Frrrrrrrrrank/Underwater-Glider/Datasheet/Pump/驱动器资料/电机驱动器BLD-485.STEP

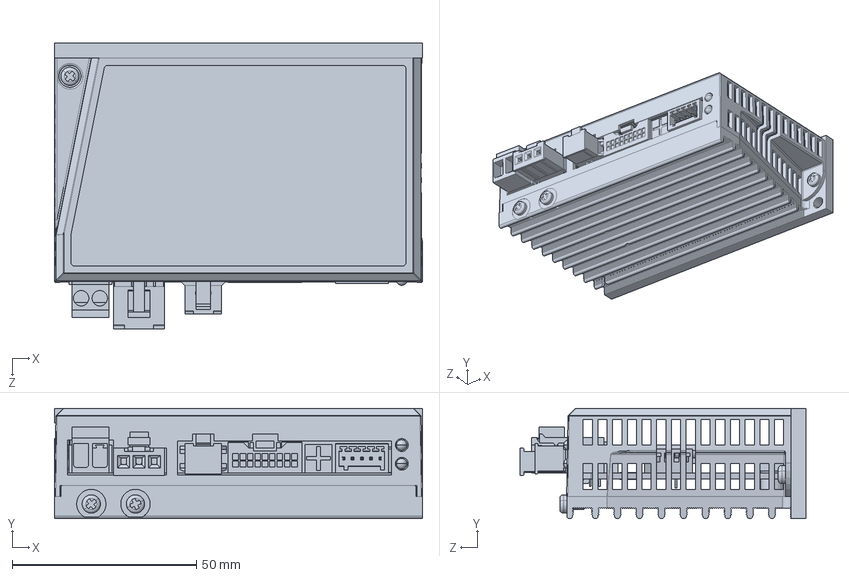
[picture p2: CAD file, 2026-04-29]
Datasheet/Pump/驱动器资料/电机驱动器BLD-485.STEP
100.0 x 30.0 x 77.6 mm
