Frrrrrrrrrank/Underwater-Glider/UnderwaterGlider/UnderwaterGlider.step

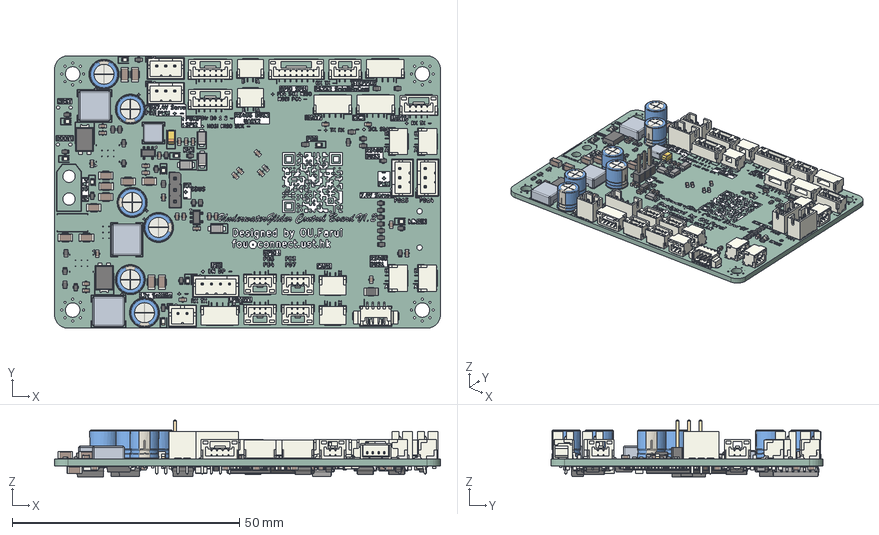
[picture p3: CAD file, 2026-06-17]
UnderwaterGlider/UnderwaterGlider.step
85.0 x 60.0 x 12.5 mm
C_0603_1608Metric x 64
JST_GH_SM04B-GHS-TB_1x04-1MP_P1.25mm_Horizontal x 4
CP_EIA-3216-18_Kemet-A
C_1206_3216Metric x 15
CP_Radial_D6.3mm_P2.50mm x 6
LED_0603_1608Metric x 10
UnderwaterGlider 1.10.1 x 3
R_0603_1608Metric x 64
JST_GH_SM02B-GHS-TB_1x02-1MP_P1.25mm_Horizontal x 8
JST_GH_BM04B-GHS-TBT_1x04-1MP_P1.25mm_Vertical
JST_GH_BM03B-GHS-TBT_1x03-1MP_P1.25mm_Vertical x 5
JST_PH_B3B-PH-K_1x03_P2.00mm_Vertical x 4
D_SMF x 5
JST_PH_B2B-PH-K_1x02_P2.00mm_Vertical
L_0603_1608Metric
PinHeader_1x03_P2.54mm_Vertical
SOT-23-5 x 2
Molex_PicoBlade_53261-0471_1x04-1MP_P1.25mm_Horizontal
JST_GH_BM05B-GHS-TBT_1x05-1MP_P1.25mm_Vertical x 2
UnderwaterGlider 1.111.1
JST_PH_B4B-PH-K_1x04_P2.00mm_Vertical
JST_GH_BM07B-GHS-TBT_1x07-1MP_P1.25mm_Vertical
Fuse_1206_3216Metric
TO-277B x 3
R_Array_Concave_4x0603 x 16
SOT-23 x 5
D_SMA x 3
D_SMC
Crystal_SMD_3225-4Pin_3.2x2.5mm
SOIC-8_3.9x4.9mm_P1.27mm x 4
TQFN-16-1EP_3x3mm_P0.5mm_EP1.6x1.6mm
SOT-363_SC-70-6
SOIC-16_4.55x10.3mm_P1.27mm
LQFP-100_14x14mm_P0.5mm
Fuse_1210_3225Metric
UnderwaterGlider_silkscreen
UnderwaterGlider_PCB
