Frrrrrrrrrank/Underwater-Glider/Datasheet/UMotor/UMLR闭环一体式系列调试软件V1.0(1)/UMLR闭环一体式系列调试软件V1.0/UMLR闭环RS485系列调试软件-V1.0/config/products/RS系列/UMLR28_object.xlsx

Index | Name | Value | Max | Min | Type | Access | Comment | Callback | Show
0x0000 | 驱动器版本 | 0 | 65535 | 0 | OB_UINT16 | RO |  | n | y
0x0001 | 驱动器标号 | 0 | 65535 | 0 | OB_UINT16 | RO |  | n | n
0x0002 | 驱动器节点号 | 0 | 65535 | 0 | OB_UINT16 | RO |  | n | n
0x0003 | 驱动器工作模式 | 0 | 65535 | 0 | OB_UINT16 | RO |  | n | n
0x0004 | 驱动器状态 | 0 | 65535 | 0 | OB_UINT16 | RO | Bit0:释放/使能 Bit1:静止/运动 Bit2-Bit3:回零状态 Bit4-Bit5:运动方向 Bit6:报警状态 | n | n
0x0005 | 当前给定理论速度 | 0 | 65535 | 0 | OB_UINT16 | RO | 单位:rev/min | n | n
0x0006 | 当前实际运行速度 | 0 | 65535 | 0 | OB_UINT16 | RO | 单位:rev/min | n | n
0x0007 | 当前错误码 | 0 | 65535 | 0 | OB_UINT16 | RO | 0:正常 其他值:错误码 | n | n
0x0008 | 当前错误子码 | 0 | 65535 | 0 | OB_UINT16 | RO | 0:正常 其他值:错误子码 | n | n
0x0009 | 输入端口状态标志位 | 0 | 65535 | 0 | OB_UINT16 | RO | 0:输入电平无效 1:输入电平有效 | n | n
0x000A | 输出端口状态标志位 | 0 | 65535 | 0 | OB_UINT16 | RO | 0:输出电平无效 1:输出电平有效 | n | n
0x000B | 当前位置低 | 0 | 65535 | 0 | OB_UINT16 | RO | 单位：Pul | n | n
0x000C | 当前位置高 | 0 | 65535 | 0 | OB_UINT16 | RO | 单位：Pul | n | n
0x000D | 当前实际电流值 | 0 | 65535 | 0 | OB_UINT16 | RO | 单位：mA | n | n
0x000E | 当前A相电流 | 0 | 65535 | 0 | OB_UINT16 | RO | 单位：mA | n | n
0x000F | 当前B相电流 | 0 | 65535 | 0 | OB_UINT16 | RO | 单位：mA | n | n
0x0010 | 闭环当前给定电流 | 0 | 65535 | 0 | OB_UINT16 | RO | 单位：rev/min | n | n
0x0011 | 拨码状态 | 0 | 65535 | 0 | OB_UINT16 | RO | 0:输入电平无效 1:输入电平有效 | n | n
0x0012 | 当前PT段路径号 | 0 | 65535 | 0 | OB_UINT16 | RO | 低8位：路径执行完成状态（保持），当前路径执行完成时，查询使用； 高8位：若处于运行中，则指示当前正在执行的路径段；若处于静止中，则指示上一次执行完成的路径段； | n | n
0x0194 | 最近一次故障码 | 0 | 65535 | 0 | OB_UINT16 | RO |  | n | y
0x0195 | 最近一次故障码子码 | 0 | 65535 | 0 | OB_UINT16 | RO |  | n | y
0x0196 | 最近二次故障码 | 0 | 65535 | 0 | OB_UINT16 | RO |  | n | n
0x0197 | 最近二次故障码子码 | 0 | 65535 | 0 | OB_UINT16 | RO |  | n | n
0x0198 | 最近三次故障码 | 0 | 65535 | 0 | OB_UINT16 | RO |  | n | n
0x0199 | 最近三次故障码子码 | 0 | 65535 | 0 | OB_UINT16 | RO |  | n | n
0x019A | 通讯类故障信息 | 0 | 65535 | 0 | OB_UINT16 | RO |  | n | n
0x019B | 通讯类故障信息 | 0 | 65535 | 0 | OB_UINT16 | RO |  | n | n
0x019C | 驱动器故障信息低16位 | 0 | 65535 | 0 | OB_UINT16 | RO |  | n | n
0x019D | 驱动器故障信息高16位 | 0 | 65535 | 0 | OB_UINT16 | RO |  | n | n
0x019E | 闭环定位精度值低16位 | 0 | 65535 | 0 | OB_UINT16 | RO | 单位：进制为10，1代表0.1个编码器值； | n | n
0x019F | 闭环定位精度值高16位 | 0 | 65535 | 0 | OB_UINT16 | RO | 以原点为分界线，正方向上差值为正值表示未到达目标位置，负值表示超过了目标位置；反方向上差值为负值表示未到达目标位置，正值表示超过了目标位置； | n | n
0x01A0 | 电机单次运行时间低16位 | 0 | 65535 | 0 | OB_UINT16 | RO | 单位：us | n | y
0x01A1 | 电机单次运行时间高16位 | 0 | 65535 | 0 | OB_UINT16 | RO | 单位：us | n | y
0x01A2 | 位置模式下实际给定的起始速度 | 0 | 65535 | 0 | OB_UINT16 | RO | 单位：rev/min | n | y
0x01A3 | 位置模式下实际给定的加速时间 | 0 | 65535 | 0 | OB_UINT16 | RO | 单位：ms | n | y
0x01A4 | 位置模式下实际给定的减速时间 | 0 | 65535 | 0 | OB_UINT16 | RO | 单位：ms | n | y
0x01A5 | 位置模式下实际给定的最大速度 | 0 | 65535 | 0 | OB_UINT16 | RO | 单位：rev/min | n | y
0x01A8 | 反馈单圈角度值 | 0 | 65535 | 0 | OB_UINT16 | RO | 单位：0.01° | n | n
0x0014 | 驱动器节点设置 | 0 | 65535 | 0 | OB_UINT16 | RW | 当设置地址拨码状态全为off时，才可自行设置驱动器节点号； | n | y
0x0015 | 自定义通讯波特率 | 0 | 6 | 0 | OB_UINT16 | RW | 0:9600 1:14400 2:19200 3:38400 4:115200 5:128000 6:256000 | n | y
0x0016 | 串口数据格式 | 0 | 3 | 0 | OB_UINT16 | RW | 0:8位数据，无校验，1停止 1:8位数据，无校验，2停止 2:8位数据，偶校验，1停止 3:8位数据，偶校验，1停止 | n | y
0x0017 | 保存参数功能 | 0 | 65535 | 0 | OB_UINT16 | RW | Bit0:同步更新功能 0:不更新 1:同步更新 Bit15:保存所有参数功能 0:不保存 1:保存所有参数 其他位功能详见说明书 | n | y
0x0018 | 超程停车方式 | 0 | 7 | 0 | OB_UINT16 | RW | 0:正负软限位生效 5:正负硬限位生效 6：软硬限位均无效 | n | y
0x0019 | 报警清除 | 0 | 1 | 0 | OB_UINT16 | RW | 0:无效 1:清除报警 | n | y
0x001A | 参数恢复出厂设置 | 0 | 1 | 0 | OB_UINT16 | RW | 0:无效 1:恢复出厂设置 | n | y
0x001B | 相位记忆使能 | 0 | 3 | 0 | OB_UINT16 | RW | Bit0：相位记忆使能功能 Bit1：掉电存储当前位置功能 0:不使能 1:使能 | n | n
0x001C | 初始旋转方向切换 | 0 | 3 | 0 | OB_UINT16 | RW | 1：出厂默认旋转方向 3：与出厂默认旋转方向相反 | n | y
0x001D | 回原点超时报警设置 | 0 | 4000 | 0 | OB_UINT16 | RW | 单位：s | n | y
0x001E | 开环电流设置 | 0 | 6000 | 0 | OB_UINT16 | RW | 单位：mA | n | n
0x001F | 开环细分设定 | 0 | 60000 | 200 | OB_UINT16 | RW | 单位：Pul/rev | n | n
0x0020 | 开环软启动时间 | 0 | 1000 | 1 | OB_UINT16 | RW | 单位：ms | n | n
0x0021 | 开环锁机电流时间 | 0 | 1000 | 1 | OB_UINT16 | RW | 单位：ms | n | n
0x0022 | 开环锁机电流比 | 0 | 100 | 0 | OB_UINT16 | RW | 单位：% | n | n
0x0023 | 开环算法选择 | 0 | 1 | 0 | OB_UINT16 | RW |  | n | n
0x0024 | 闭环运行最小有效电流值设置 | 0 | 6000 | 0 | OB_UINT16 | RW | 单位：mA | n | y
0x0025 | 闭环运行最大有效电流值设置 | 0 | 6000 | 0 | OB_UINT16 | RW | 单位：mA | n | y
0x0026 | 闭环锁机最小有效电流值设置 | 0 | 6000 | 0 | OB_UINT16 | RW | 单位：mA | n | y
0x0027 | 闭环锁机最大有效电流值设置 | 0 | 6000 | 0 | OB_UINT16 | RW | 单位：mA | n | y
0x0028 | 闭环细分设置 | 0 | 60000 | 200 | OB_UINT16 | RW | 单位：Pul/rev | n | y
0x0029 | 闭环软启动时间T1 | 0 | 65535 | 1 | OB_UINT16 | RW | 单位：ms | n | n
0x002A | 闭环软启动时间T2 | 0 | 65535 | 1 | OB_UINT16 | RW | 单位：ms | n | n
0x002B | 闭环锁机时间 | 0 | 500 | 1 | OB_UINT16 | RW | 单位：ms | n | n
0x002C | 闭环位置超差报警阈值 | 0 | 65535 | 1 | OB_UINT16 | RW | 单位：1代表0.09° 4000*0.09°=360° | n | y
0x002D | 闭环超差报警时间 | 0 | 1000 | 1 | OB_UINT16 | RW | 单位：ms | n | y
0x002E | 力矩模式选择 | 0 | 2 | 0 | OB_UINT16 | RW | 0:正常闭环模式 1:闭环力矩模式1(不会超差但可输出报警信号) 2:闭环力矩模式2(不会超差也不会输出报警信号) | n | n
0x002F | 闭环算法选择 | 0 | 31 | 0 | OB_UINT16 | RW |  | n | n
0x0030 | 起始速度 | 0 | 3000 | 1 | OB_UINT16 | RW | 单位：rev/min | n | n
0x0031 | 加速时间 | 0 | 2000 | 0 | OB_UINT16 | RW | 单位：ms | n | n
0x0032 | 减速时间 | 0 | 2000 | 0 | OB_UINT16 | RW | 单位：ms | n | n
0x0033 | 最大速度 | 0 | 65535 | 0 | OB_INT16 | RW | 单位：rev/min | n | n
0x0034 | 总脉冲数低16位 | 0 | 65535 | 0 | OB_UINT16 | RW | 单位：Pul | n | n
0x0035 | 总脉冲数高16位 | 0 | 65535 | 0 | OB_UINT16 | RW | 单位：Pul | n | n
0x0036 | 相对位置/绝对位置选择 | 0 | 1 | 0 | OB_UINT16 | RW |  | n | n
0x0037 | 启动命令 | 0 | 255 | 0 | OB_UINT16 | RW |  | n | n
0x0038 | 停止命令 | 0 | 2 | 0 | OB_UINT16 | RW |  | n | n
0x0039 | 电机使能//释放命令 | 0 | 3 | 0 | OB_UINT16 | RW | 0:不使能 1：手动控制使能 3：上电自动使能 | n | y
0x003A | 清除当前位置 | 0 | 1 | 0 | OB_UINT16 | RW | 0：无效；1：当前位置清零 | n | y
0x003B | 回原点模式 | 0 | 65535 | 0 | OB_UINT16 | RW | 回原方式详见说明书章节中回原点模式 | n | y
0x003C | 回原点速度V1 | 0 | 3000 | 1 | OB_UINT16 | RW | 单位：rev/min | n | y
0x003D | 回原点速度V2 | 0 | 3000 | 1 | OB_UINT16 | RW | 单位：rev/min | n | y
0x003E | 回原点加速时间 | 0 | 2000 | 0 | OB_UINT16 | RW | 单位：ms | n | n
0x003F | 回原点减速时间 | 0 | 2000 | 0 | OB_UINT16 | RW | 单位：ms | n | n
0x0040 | 原点低位补偿值 | 0 | 65535 | 0 | OB_UINT16 | RW | 单位：Pul | n | n
0x0041 | 原点高位补偿值 | 0 | 65535 | 0 | OB_UINT16 | RW | 单位：Pul | n | n
0x0042 | 堵转回零力矩保留时间 | 0 | 65535 | 0 | OB_UINT16 | RW | 单位:ms | n | n
0x0043 | 回零电流百分比设定 | 0 | 300 | 1 | OB_UINT16 | RW | 单位:% | n | n
0x0044 | 位置回零模式位置值设定低16位 | 0 | 65535 | 0 | OB_UINT16 | RW | 单位:pul 无符号 | n | n
0x0045 | 位置回零模式位置值设定高16位 | 0 | 65535 | 0 | OB_UINT16 | RW | 单位:pul 无符号 | n | n
0x004E | 单圈角度回零模式下，角度设定 | 0 | 36000 | 0 | OB_UINT16 | RW | 单位:0.01° | n | n
0x0046 | JOG运动起始速度设置 | 0 | 3000 | 1 | OB_UINT16 | RW | 单位rev/min | n | n
0x0047 | JOG运动加速时间设置 | 0 | 2000 | 0 | OB_UINT16 | RW | 单位:ms | n | y
0x0048 | JOG运动减速时间设置 | 0 | 2000 | 0 | OB_UINT16 | RW | 单位:ms | n | y
0x0049 | JOG运动最大速度设置 | 0 | 3000 | 0 | OB_UINT16 | RW | 单位rev/min | n | y
0x0056 | 正向超程最大位置低16位 | 0 | 65535 | 0 | OB_UINT16 | RW | 单位:pul 无符号 | n | y
0x0057 | 正向超程最大位置高16位 | 0 | 65535 | 0 | OB_UINT16 | RW | 单位:pul 无符号 | n | y
0x0058 | 反向超程最大位置低16位 | 0 | 65535 | 0 | OB_UINT16 | RW | 单位:pul 无符号 | n | y
0x0059 | 反向超程最大位置高16位 | 0 | 65535 | 0 | OB_UINT16 | RW | 单位:pul 无符号 | n | y
0x005A | 上电自动回零点使能 | 0 | 1 | 0 | OB_UINT16 | RW | 0:上电不自动回零功能 1:上电自动回零功能 | n | y
0x01B0 | 输入端口有效电平 | 0 | 65535 | 0 | OB_UINT16 | RW |  | n | y
0x01B1 | 输入端口 X0功能选择 | 0 | 21 | 0 | OB_UINT16 | RW |  | n | n
0x01B2 | 输入端口 X1功能选择 | 0 | 21 | 0 | OB_UINT16 | RW |  | n | n
0x01B3 | 输入端口 X2功能选择 | 0 | 21 | 0 | OB_UINT16 | RW |  | n | n
0x01B4 | 输入端口 X3功能选择 | 0 | 21 | 0 | OB_UINT16 | RW |  | n | n
0x01B5 | 输入端口 X4功能选择 | 0 | 21 | 0 | OB_UINT16 | RW |  | n | n
0x01B6 | 输入端口 X5功能选择 | 0 | 21 | 0 | OB_UINT16 | RW |  | n | n
0x01B7 | 输入端口 X6功能选择 | 0 | 21 | 0 | OB_UINT16 | RW |  | n | n
0x01B8 | 输入端口 X7功能选择 | 0 | 21 | 0 | OB_UINT16 | RW |  | n | n
0x01B9 | 输入端口 X8功能选择 | 0 | 21 | 0 | OB_UINT16 | RW |  | n | n
0x01BA | 输入端口 X9功能选择 | 0 | 21 | 0 | OB_UINT16 | RW |  | n | n
0x01BB | 输入端口 X10功能选择 | 0 | 21 | 0 | OB_UINT16 | RW |  | n | n
0x01BC | 输入端口 X0滤波时间 | 0 | 65535 | 0 | OB_UINT16 | RW | 单位：us 最小分辨率1000us | n | n
0x01BD | 输入端口 X1滤波时间 | 0 | 65535 | 0 | OB_UINT16 | RW | 单位：us 最小分辨率1000us | n | n
0x01BE | 输入端口 X2滤波时间 | 0 | 65535 | 0 | OB_UINT16 | RW | 单位：us 最小分辨率1000us | n | n
0x01BF | 输入端口 X3滤波时间 | 0 | 65535 | 0 | OB_UINT16 | RW | 单位：us 最小分辨率1000us | n | n
0x01C0 | 输入端口 X4滤波时间 | 0 | 65535 | 0 | OB_UINT16 | RW | 单位：us 最小分辨率1000us | n | n
0x01C1 | 输入端口 X5滤波时间 | 0 | 65535 | 0 | OB_UINT16 | RW | 单位：us 最小分辨率1000us | n | n
0x01C2 | 输入端口 X6滤波时间 | 0 | 65535 | 0 | OB_UINT16 | RW | 单位：us 最小分辨率1000us | n | n
0x01C3 | 输入端口 X7滤波时间 | 0 | 65535 | 0 | OB_UINT16 | RW | 单位：us 最小分辨率1000us | n | n
0x01C4 | 输入端口 X8滤波时间 | 0 | 65535 | 0 | OB_UINT16 | RW | 单位：us 最小分辨率1000us | n | n
0x01C5 | 输入端口 X9滤波时间 | 0 | 65535 | 0 | OB_UINT16 | RW | 单位：us 最小分辨率1000us | n | n
0x01C6 | 输入端口 X10滤波时间 | 0 | 65535 | 0 | OB_UINT16 | RW | 单位：us 最小分辨率1000us | n | n
0x01C7 | 输出端口有效状态 | 0 | 65535 | 0 | OB_UINT16 | RW |  | n | y
0x01C8 | 输出端口 Y0功能选择 | 0 | 11 | 0 | OB_UINT16 | RW |  | n | n
0x01C9 | 输出端口 Y1功能选择 | 0 | 11 | 0 | OB_UINT16 | RW |  | n | n
0x01CA | 输出端口 Y2功能选择 | 0 | 11 | 0 | OB_UINT16 | RW |  | n | n
0x01CB | 输出端口 Y3功能选择 | 0 | 11 | 0 | OB_UINT16 | RW |  | n | n
0x01CC | 输出端口 Y4功能选择 | 0 | 11 | 0 | OB_UINT16 | RW |  | n | n
0x01CD | 禁止不同模式下的到位输出功能 | 0 | 65535 | 0 | OB_UINT16 | RW | Bit0:速度模式 Bit1:相对位置 Bit2:绝对位置 Bit3:回零 Bit4:多段位置 Bit5:多段速度 Bit6:JOG+运动 Bit7:JOG-运动 0：禁止无效 1：禁止有效65535 | n | y
0x005E | 多段模式启动信号使能控制 | 0 | 1 | 0 | OB_UINT16 | RW | 0:多段模式不需要启动信号(此情况路径0失效) 1:多段模式需要启动信号(此情况路径0可启动) | n | y
0x005F | 多段模式IO组合滤波时间 | 0 | 65535 | 0 | OB_UINT16 | RW | 单位：us 最小分辨率1000us | n | n
0x0060 | 路径0功能设置1 | 0 | 65535 | 0 | OB_UINT16 | RW |  | n | n
0x0061 | 路径0功能设置2 | 0 | 65535 | 0 | OB_UINT16 | RW |  | n | n
0x0062 | 路径0位置段总脉冲数低位 | 0 | 65535 | 0 | OB_UINT16 | RW |  | n | n
0x0063 | 路径0位置段总脉冲数高位 | 0 | 65535 | 0 | OB_UINT16 | RW |  | n | n
0x0064 | 路径0运行/回原点最大速度 | 0 | 65535 | 0 | OB_UINT16 | RW | 单位：rev/min | n | n
0x0065 | 路径0运行/回原点起始速度 | 0 | 3000 | 1 | OB_UINT16 | RW | 单位：rev/min | n | n
0x0066 | 路径0运行/回原点加速时间 | 0 | 2000 | 0 | OB_UINT16 | RW | 单位：ms | n | n
0x0067 | 路径0运行/回原点减速时间 | 0 | 2000 | 0 | OB_UINT16 | RW | 单位：ms | n | n
0x0068 | 路径0执行完毕等待时长 | 0 | 65535 | 0 | OB_UINT16 | RW | 单位：ms | n | n
0x0069 | 路径0回原点低位补偿值 | 0 | 65535 | 0 | OB_UINT16 | RW | 单位：Pul | n | n
0x006A | 路径0回原点高位补偿值 | 0 | 65535 | 0 | OB_UINT16 | RW | 单位：Pul | n | n
0x006B | 路径0回原点后等待时长 | 0 | 65535 | 0 | OB_UINT16 | RW | 单位：ms | n | n
0x0070 | 路径1功能设置1 | 0 | 65535 | 0 | OB_UINT16 | RW |  | n | n
0x0071 | 路径1功能设置2 | 0 | 65535 | 0 | OB_UINT16 | RW |  | n | n
0x0072 | 路径1位置段总脉冲数低位 | 0 | 65535 | 0 | OB_UINT16 | RW |  | n | n
0x0073 | 路径1位置段总脉冲数高位 | 0 | 65535 | 0 | OB_UINT16 | RW |  | n | n
0x0074 | 路径1运行/回原点最大速度 | 0 | 65535 | 0 | OB_UINT16 | RW | 单位：rev/min | n | n
0x0075 | 路径1运行/回原点起始速度 | 0 | 3000 | 1 | OB_UINT16 | RW | 单位：rev/min | n | n
0x0076 | 路径1运行/回原点加速时间 | 0 | 2000 | 0 | OB_UINT16 | RW | 单位：ms | n | n
0x0077 | 路径1运行/回原点减速时间 | 0 | 2000 | 0 | OB_UINT16 | RW | 单位：ms | n | n
0x0078 | 路径1执行完毕等待时长 | 0 | 65535 | 0 | OB_UINT16 | RW | 单位：ms | n | n
0x0079 | 路径1回原点低位补偿值 | 0 | 65535 | 0 | OB_UINT16 | RW | 单位：Pul | n | n
0x007A | 路径1回原点高位补偿值 | 0 | 65535 | 0 | OB_UINT16 | RW | 单位：Pul | n | n
0x007B | 路径1回原点后等待时长 | 0 | 65535 | 0 | OB_UINT16 | RW | 单位：ms | n | n
0x0080 | 路径2功能设置1 | 0 | 65535 | 0 | OB_UINT16 | RW |  | n | n
0x0081 | 路径2功能设置2 | 0 | 65535 | 0 | OB_UINT16 | RW |  | n | n
0x0082 | 路径2位置段总脉冲数低位 | 0 | 65535 | 0 | OB_UINT16 | RW |  | n | n
0x0083 | 路径2位置段总脉冲数高位 | 0 | 65535 | 0 | OB_UINT16 | RW |  | n | n
0x0084 | 路径2运行/回原点最大速度 | 0 | 65535 | 0 | OB_UINT16 | RW | 单位：rev/min | n | n
0x0085 | 路径2运行/回原点起始速度 | 0 | 3000 | 1 | OB_UINT16 | RW | 单位：rev/min | n | n
0x0086 | 路径2运行/回原点加速时间 | 0 | 2000 | 0 | OB_UINT16 | RW | 单位：ms | n | n
0x0087 | 路径2运行/回原点减速时间 | 0 | 2000 | 0 | OB_UINT16 | RW | 单位：ms | n | n
0x0088 | 路径2执行完毕等待时长 | 0 | 65535 | 0 | OB_UINT16 | RW | 单位：ms | n | n
0x0089 | 路径2回原点低位补偿值 | 0 | 65535 | 0 | OB_UINT16 | RW | 单位：Pul | n | n
0x008A | 路径2回原点高位补偿值 | 0 | 65535 | 0 | OB_UINT16 | RW | 单位：Pul | n | n
0x008B | 路径2回原点后等待时长 | 0 | 65535 | 0 | OB_UINT16 | RW | 单位：ms | n | n
0x0090 | 路径3功能设置1 | 0 | 65535 | 0 | OB_UINT16 | RW |  | n | n
0x0091 | 路径3功能设置2 | 0 | 65535 | 0 | OB_UINT16 | RW |  | n | n
0x0092 | 路径3位置段总脉冲数低位 | 0 | 65535 | 0 | OB_UINT16 | RW |  | n | n
0x0093 | 路径3位置段总脉冲数高位 | 0 | 65535 | 0 | OB_UINT16 | RW |  | n | n
0x0094 | 路径3运行/回原点最大速度 | 0 | 65535 | 0 | OB_UINT16 | RW | 单位：rev/min | n | n
0x0095 | 路径3运行/回原点起始速度 | 0 | 3000 | 1 | OB_UINT16 | RW | 单位：rev/min | n | n
0x0096 | 路径3运行/回原点加速时间 | 0 | 2000 | 0 | OB_UINT16 | RW | 单位：ms | n | n
0x0097 | 路径3运行/回原点减速时间 | 0 | 2000 | 0 | OB_UINT16 | RW | 单位：ms | n | n
0x0098 | 路径3执行完毕等待时长 | 0 | 65535 | 0 | OB_UINT16 | RW | 单位：ms | n | n
0x0099 | 路径3回原点低位补偿值 | 0 | 65535 | 0 | OB_UINT16 | RW | 单位：Pul | n | n
0x009A | 路径3回原点高位补偿值 | 0 | 65535 | 0 | OB_UINT16 | RW | 单位：Pul | n | n
0x009B | 路径3回原点后等待时长 | 0 | 65535 | 0 | OB_UINT16 | RW | 单位：ms | n | n
0x00A0 | 路径4功能设置1 | 0 | 65535 | 0 | OB_UINT16 | RW |  | n | n
0x00A1 | 路径4功能设置2 | 0 | 65535 | 0 | OB_UINT16 | RW |  | n | n
0x00A2 | 路径4位置段总脉冲数低位 | 0 | 65535 | 0 | OB_UINT16 | RW |  | n | n
0x00A3 | 路径4位置段总脉冲数高位 | 0 | 65535 | 0 | OB_UINT16 | RW |  | n | n
0x00A4 | 路径4运行/回原点最大速度 | 0 | 65535 | 0 | OB_UINT16 | RW | 单位：rev/min | n | n
0x00A5 | 路径4运行/回原点起始速度 | 0 | 3000 | 1 | OB_UINT16 | RW | 单位：rev/min | n | n
0x00A6 | 路径4运行/回原点加速时间 | 0 | 2000 | 0 | OB_UINT16 | RW | 单位：ms | n | n
0x00A7 | 路径4运行/回原点减速时间 | 0 | 2000 | 0 | OB_UINT16 | RW | 单位：ms | n | n
0x00A8 | 路径4执行完毕等待时长 | 0 | 65535 | 0 | OB_UINT16 | RW | 单位：ms | n | n
0x00A9 | 路径4回原点低位补偿值 | 0 | 65535 | 0 | OB_UINT16 | RW | 单位：Pul | n | n
0x00AA | 路径4回原点高位补偿值 | 0 | 65535 | 0 | OB_UINT16 | RW | 单位：Pul | n | n
0x00AB | 路径4回原点后等待时长 | 0 | 65535 | 0 | OB_UINT16 | RW | 单位：ms | n | n
0x00B0 | 路径5功能设置1 | 0 | 65535 | 0 | OB_UINT16 | RW |  | n | n
0x00B1 | 路径5功能设置2 | 0 | 65535 | 0 | OB_UINT16 | RW |  | n | n
0x00B2 | 路径5位置段总脉冲数低位 | 0 | 65535 | 0 | OB_UINT16 | RW |  | n | n
0x00B3 | 路径5位置段总脉冲数高位 | 0 | 65535 | 0 | OB_UINT16 | RW |  | n | n
0x00B4 | 路径5运行/回原点最大速度 | 0 | 65535 | 0 | OB_UINT16 | RW | 单位：rev/min | n | n
0x00B5 | 路径5运行/回原点起始速度 | 0 | 3000 | 1 | OB_UINT16 | RW | 单位：rev/min | n | n
0x00B6 | 路径5运行/回原点加速时间 | 0 | 2000 | 0 | OB_UINT16 | RW | 单位：ms | n | n
0x00B7 | 路径5运行/回原点减速时间 | 0 | 2000 | 0 | OB_UINT16 | RW | 单位：ms | n | n
0x00B8 | 路径5执行完毕等待时长 | 0 | 65535 | 0 | OB_UINT16 | RW | 单位：ms | n | n
0x00B9 | 路径5回原点低位补偿值 | 0 | 65535 | 0 | OB_UINT16 | RW | 单位：Pul | n | n
0x00BA | 路径5回原点高位补偿值 | 0 | 65535 | 0 | OB_UINT16 | RW | 单位：Pul | n | n
0x00BB | 路径5回原点后等待时长 | 0 | 65535 | 0 | OB_UINT16 | RW | 单位：ms | n | n
0x00C0 | 路径6功能设置1 | 0 | 65535 | 0 | OB_UINT16 | RW |  | n | n
0x00C1 | 路径6功能设置2 | 0 | 65535 | 0 | OB_UINT16 | RW |  | n | n
0x00C2 | 路径6位置段总脉冲数低位 | 0 | 65535 | 0 | OB_UINT16 | RW |  | n | n
0x00C3 | 路径6位置段总脉冲数高位 | 0 | 65535 | 0 | OB_UINT16 | RW |  | n | n
0x00C4 | 路径6运行/回原点最大速度 | 0 | 65535 | 0 | OB_UINT16 | RW | 单位：rev/min | n | n
0x00C5 | 路径6运行/回原点起始速度 | 0 | 3000 | 1 | OB_UINT16 | RW | 单位：rev/min | n | n
0x00C6 | 路径6运行/回原点加速时间 | 0 | 2000 | 0 | OB_UINT16 | RW | 单位：ms | n | n
0x00C7 | 路径6运行/回原点减速时间 | 0 | 2000 | 0 | OB_UINT16 | RW | 单位：ms | n | n
0x00C8 | 路径6执行完毕等待时长 | 0 | 65535 | 0 | OB_UINT16 | RW | 单位：ms | n | n
0x00C9 | 路径6回原点低位补偿值 | 0 | 65535 | 0 | OB_UINT16 | RW | 单位：Pul | n | n
0x00CA | 路径6回原点高位补偿值 | 0 | 65535 | 0 | OB_UINT16 | RW | 单位：Pul | n | n
0x00CB | 路径6回原点后等待时长 | 0 | 65535 | 0 | OB_UINT16 | RW | 单位：ms | n | n
0x00D0 | 路径7功能设置1 | 0 | 65535 | 0 | OB_UINT16 | RW |  | n | n
0x00D1 | 路径7功能设置2 | 0 | 65535 | 0 | OB_UINT16 | RW |  | n | n
0x00D2 | 路径7位置段总脉冲数低位 | 0 | 65535 | 0 | OB_UINT16 | RW |  | n | n
0x00D3 | 路径7位置段总脉冲数高位 | 0 | 65535 | 0 | OB_UINT16 | RW |  | n | n
0x00D4 | 路径7运行/回原点最大速度 | 0 | 65535 | 0 | OB_UINT16 | RW | 单位：rev/min | n | n
0x00D5 | 路径7运行/回原点起始速度 | 0 | 3000 | 1 | OB_UINT16 | RW | 单位：rev/min | n | n
0x00D6 | 路径7运行/回原点加速时间 | 0 | 2000 | 0 | OB_UINT16 | RW | 单位：ms | n | n
0x00D7 | 路径7运行/回原点减速时间 | 0 | 2000 | 0 | OB_UINT16 | RW | 单位：ms | n | n
0x00D8 | 路径7执行完毕等待时长 | 0 | 65535 | 0 | OB_UINT16 | RW | 单位：ms | n | n
0x00D9 | 路径7回原点低位补偿值 | 0 | 65535 | 0 | OB_UINT16 | RW | 单位：Pul | n | n
0x00DA | 路径7回原点高位补偿值 | 0 | 65535 | 0 | OB_UINT16 | RW | 单位：Pul | n | n
0x00DB | 路径7回原点后等待时长 | 0 | 65535 | 0 | OB_UINT16 | RW | 单位：ms | n | n
0x00E0 | 路径8功能设置1 | 0 | 65535 | 0 | OB_UINT16 | RW |  | n | n
0x00E1 | 路径8功能设置2 | 0 | 65535 | 0 | OB_UINT16 | RW |  | n | n
0x00E2 | 路径8位置段总脉冲数低位 | 0 | 65535 | 0 | OB_UINT16 | RW |  | n | n
0x00E3 | 路径8位置段总脉冲数高位 | 0 | 65535 | 0 | OB_UINT16 | RW |  | n | n
0x00E4 | 路径8运行/回原点最大速度 | 0 | 65535 | 0 | OB_UINT16 | RW | 单位：rev/min | n | n
0x00E5 | 路径8运行/回原点起始速度 | 0 | 3000 | 1 | OB_UINT16 | RW | 单位：rev/min | n | n
0x00E6 | 路径8运行/回原点加速时间 | 0 | 2000 | 0 | OB_UINT16 | RW | 单位：ms | n | n
0x00E7 | 路径8运行/回原点减速时间 | 0 | 2000 | 0 | OB_UINT16 | RW | 单位：ms | n | n
0x00E8 | 路径8执行完毕等待时长 | 0 | 65535 | 0 | OB_UINT16 | RW | 单位：ms | n | n
0x00E9 | 路径8回原点低位补偿值 | 0 | 65535 | 0 | OB_UINT16 | RW | 单位：Pul | n | n
0x00EA | 路径8回原点高位补偿值 | 0 | 65535 | 0 | OB_UINT16 | RW | 单位：Pul | n | n
0x00EB | 路径8回原点后等待时长 | 0 | 65535 | 0 | OB_UINT16 | RW | 单位：ms | n | n
0x00F0 | 路径9功能设置1 | 0 | 65535 | 0 | OB_UINT16 | RW |  | n | n
0x00F1 | 路径9功能设置2 | 0 | 65535 | 0 | OB_UINT16 | RW |  | n | n
0x00F2 | 路径9位置段总脉冲数低位 | 0 | 65535 | 0 | OB_UINT16 | RW |  | n | n
0x00F3 | 路径9位置段总脉冲数高位 | 0 | 65535 | 0 | OB_UINT16 | RW |  | n | n
0x00F4 | 路径9运行/回原点最大速度 | 0 | 65535 | 0 | OB_UINT16 | RW | 单位：rev/min | n | n
0x00F5 | 路径9运行/回原点起始速度 | 0 | 3000 | 1 | OB_UINT16 | RW | 单位：rev/min | n | n
0x00F6 | 路径9运行/回原点加速时间 | 0 | 2000 | 0 | OB_UINT16 | RW | 单位：ms | n | n
0x00F7 | 路径9运行/回原点减速时间 | 0 | 2000 | 0 | OB_UINT16 | RW | 单位：ms | n | n
0x00F8 | 路径9执行完毕等待时长 | 0 | 65535 | 0 | OB_UINT16 | RW | 单位：ms | n | n
0x00F9 | 路径9回原点低位补偿值 | 0 | 65535 | 0 | OB_UINT16 | RW | 单位：Pul | n | n
0x00FA | 路径9回原点高位补偿值 | 0 | 65535 | 0 | OB_UINT16 | RW | 单位：Pul | n | n
0x00FB | 路径9回原点后等待时长 | 0 | 65535 | 0 | OB_UINT16 | RW | 单位：ms | n | n
0x0100 | 路径10功能设置1 | 0 | 65535 | 0 | OB_UINT16 | RW |  | n | n
0x0101 | 路径10功能设置2 | 0 | 65535 | 0 | OB_UINT16 | RW |  | n | n
0x0102 | 路径10位置段总脉冲数低位 | 0 | 65535 | 0 | OB_UINT16 | RW |  | n | n
0x0103 | 路径10位置段总脉冲数高位 | 0 | 65535 | 0 | OB_UINT16 | RW |  | n | n
0x0104 | 路径10运行/回原点最大速度 | 0 | 65535 | 0 | OB_UINT16 | RW | 单位：rev/min | n | n
0x0105 | 路径10运行/回原点起始速度 | 0 | 3000 | 1 | OB_UINT16 | RW | 单位：rev/min | n | n
0x0106 | 路径10运行/回原点加速时间 | 0 | 2000 | 0 | OB_UINT16 | RW | 单位：ms | n | n
0x0107 | 路径10运行/回原点减速时间 | 0 | 2000 | 0 | OB_UINT16 | RW | 单位：ms | n | n
0x0108 | 路径10执行完毕等待时长 | 0 | 65535 | 0 | OB_UINT16 | RW | 单位：ms | n | n
0x0109 | 路径10回原点低位补偿值 | 0 | 65535 | 0 | OB_UINT16 | RW | 单位：Pul | n | n
0x010A | 路径10回原点高位补偿值 | 0 | 65535 | 0 | OB_UINT16 | RW | 单位：Pul | n | n
0x010B | 路径10回原点后等待时长 | 0 | 65535 | 0 | OB_UINT16 | RW | 单位：ms | n | n
0x0110 | 路径11功能设置1 | 0 | 65535 | 0 | OB_UINT16 | RW |  | n | n
0x0111 | 路径11功能设置2 | 0 | 65535 | 0 | OB_UINT16 | RW |  | n | n
0x0112 | 路径11位置段总脉冲数低位 | 0 | 65535 | 0 | OB_UINT16 | RW |  | n | n
0x0113 | 路径11位置段总脉冲数高位 | 0 | 65535 | 0 | OB_UINT16 | RW |  | n | n
0x0114 | 路径11运行/回原点最大速度 | 0 | 65535 | 0 | OB_UINT16 | RW | 单位：rev/min | n | n
0x0115 | 路径11运行/回原点起始速度 | 0 | 3000 | 1 | OB_UINT16 | RW | 单位：rev/min | n | n
0x0116 | 路径11运行/回原点加速时间 | 0 | 2000 | 0 | OB_UINT16 | RW | 单位：ms | n | n
0x0117 | 路径11运行/回原点减速时间 | 0 | 2000 | 0 | OB_UINT16 | RW | 单位：ms | n | n
0x0118 | 路径11执行完毕等待时长 | 0 | 65535 | 0 | OB_UINT16 | RW | 单位：ms | n | n
0x0119 | 路径11回原点低位补偿值 | 0 | 65535 | 0 | OB_UINT16 | RW | 单位：Pul | n | n
0x011A | 路径11回原点高位补偿值 | 0 | 65535 | 0 | OB_UINT16 | RW | 单位：Pul | n | n
0x011B | 路径11回原点后等待时长 | 0 | 65535 | 0 | OB_UINT16 | RW | 单位：ms | n | n
0x0120 | 路径12功能设置1 | 0 | 65535 | 0 | OB_UINT16 | RW |  | n | n
0x0121 | 路径12功能设置2 | 0 | 65535 | 0 | OB_UINT16 | RW |  | n | n
0x0122 | 路径12位置段总脉冲数低位 | 0 | 65535 | 0 | OB_UINT16 | RW |  | n | n
0x0123 | 路径12位置段总脉冲数高位 | 0 | 65535 | 0 | OB_UINT16 | RW |  | n | n
0x0124 | 路径12运行/回原点最大速度 | 0 | 65535 | 0 | OB_UINT16 | RW | 单位：rev/min | n | n
0x0125 | 路径12运行/回原点起始速度 | 0 | 3000 | 1 | OB_UINT16 | RW | 单位：rev/min | n | n
0x0126 | 路径12运行/回原点加速时间 | 0 | 2000 | 0 | OB_UINT16 | RW | 单位：ms | n | n
0x0127 | 路径12运行/回原点减速时间 | 0 | 2000 | 0 | OB_UINT16 | RW | 单位：ms | n | n
0x0128 | 路径12执行完毕等待时长 | 0 | 65535 | 0 | OB_UINT16 | RW | 单位：ms | n | n
0x0129 | 路径12回原点低位补偿值 | 0 | 65535 | 0 | OB_UINT16 | RW | 单位：Pul | n | n
0x012A | 路径12回原点高位补偿值 | 0 | 65535 | 0 | OB_UINT16 | RW | 单位：Pul | n | n
0x012B | 路径12回原点后等待时长 | 0 | 65535 | 0 | OB_UINT16 | RW | 单位：ms | n | n
0x0130 | 路径13功能设置1 | 0 | 65535 | 0 | OB_UINT16 | RW |  | n | n
0x0131 | 路径13功能设置2 | 0 | 65535 | 0 | OB_UINT16 | RW |  | n | n
0x0132 | 路径13位置段总脉冲数低位 | 0 | 65535 | 0 | OB_UINT16 | RW |  | n | n
0x0133 | 路径13位置段总脉冲数高位 | 0 | 65535 | 0 | OB_UINT16 | RW |  | n | n
0x0134 | 路径13运行/回原点最大速度 | 0 | 65535 | 0 | OB_UINT16 | RW | 单位：rev/min | n | n
0x0135 | 路径13运行/回原点起始速度 | 0 | 3000 | 1 | OB_UINT16 | RW | 单位：rev/min | n | n
0x0136 | 路径13运行/回原点加速时间 | 0 | 2000 | 0 | OB_UINT16 | RW | 单位：ms | n | n
0x0137 | 路径13运行/回原点减速时间 | 0 | 2000 | 0 | OB_UINT16 | RW | 单位：ms | n | n
0x0138 | 路径13执行完毕等待时长 | 0 | 65535 | 0 | OB_UINT16 | RW | 单位：ms | n | n
0x0139 | 路径13回原点低位补偿值 | 0 | 65535 | 0 | OB_UINT16 | RW | 单位：Pul | n | n
0x013A | 路径13回原点高位补偿值 | 0 | 65535 | 0 | OB_UINT16 | RW | 单位：Pul | n | n
0x013B | 路径13回原点后等待时长 | 0 | 65535 | 0 | OB_UINT16 | RW | 单位：ms | n | n
0x0140 | 路径14功能设置1 | 0 | 65535 | 0 | OB_UINT16 | RW |  | n | n
0x0141 | 路径14功能设置2 | 0 | 65535 | 0 | OB_UINT16 | RW |  | n | n
0x0142 | 路径14位置段总脉冲数低位 | 0 | 65535 | 0 | OB_UINT16 | RW |  | n | n
0x0143 | 路径14位置段总脉冲数高位 | 0 | 65535 | 0 | OB_UINT16 | RW |  | n | n
0x0144 | 路径14运行/回原点最大速度 | 0 | 65535 | 0 | OB_UINT16 | RW | 单位：rev/min | n | n
0x0145 | 路径14运行/回原点起始速度 | 0 | 3000 | 1 | OB_UINT16 | RW | 单位：rev/min | n | n
0x0146 | 路径14运行/回原点加速时间 | 0 | 2000 | 0 | OB_UINT16 | RW | 单位：ms | n | n
0x0147 | 路径14运行/回原点减速时间 | 0 | 2000 | 0 | OB_UINT16 | RW | 单位：ms | n | n
0x0148 | 路径14执行完毕等待时长 | 0 | 65535 | 0 | OB_UINT16 | RW | 单位：ms | n | n
0x0149 | 路径14回原点低位补偿值 | 0 | 65535 | 0 | OB_UINT16 | RW | 单位：Pul | n | n
0x014A | 路径14回原点高位补偿值 | 0 | 65535 | 0 | OB_UINT16 | RW | 单位：Pul | n | n
0x014B | 路径14回原点后等待时长 | 0 | 65535 | 0 | OB_UINT16 | RW | 单位：ms | n | n
0x0150 | 路径15功能设置1 | 0 | 65535 | 0 | OB_UINT16 | RW |  | n | n
0x0151 | 路径15功能设置2 | 0 | 65535 | 0 | OB_UINT16 | RW |  | n | n
0x0152 | 路径15位置段总脉冲数低位 | 0 | 65535 | 0 | OB_UINT16 | RW |  | n | n
0x0153 | 路径15位置段总脉冲数高位 | 0 | 65535 | 0 | OB_UINT16 | RW |  | n | n
0x0154 | 路径15运行/回原点最大速度 | 0 | 65535 | 0 | OB_UINT16 | RW | 单位：rev/min | n | n
0x0155 | 路径15运行/回原点起始速度 | 0 | 3000 | 1 | OB_UINT16 | RW | 单位：rev/min | n | n
0x0156 | 路径15运行/回原点加速时间 | 0 | 2000 | 0 | OB_UINT16 | RW | 单位：ms | n | n
0x0157 | 路径15运行/回原点减速时间 | 0 | 2000 | 0 | OB_UINT16 | RW | 单位：ms | n | n
0x0158 | 路径15执行完毕等待时长 | 0 | 65535 | 0 | OB_UINT16 | RW | 单位：ms | n | n
0x0159 | 路径15回原点低位补偿值 | 0 | 65535 | 0 | OB_UINT16 | RW | 单位：Pul | n | n
0x015A | 路径15回原点高位补偿值 | 0 | 65535 | 0 | OB_UINT16 | RW | 单位：Pul | n | n
0x015B | 路径15回原点后等待时长 | 0 | 65535 | 0 | OB_UINT16 | RW | 单位：ms | n | n
0x0160 | 缺相检测阈值 | 0 | 100 | 0 | OB_UINT16 | RW |  | n | n
0x0161 | 开闭环电流给定控制因子调整 | 0 | 500 | 0 | OB_UINT16 | RW | 单位：% | n | n
0x0162 | 中频震荡处理使能 | 0 | 1 | 0 | OB_UINT16 | RW |  | n | n
0x0163 | 中频震荡抑制系数K | 0 | 500 | 0 | OB_UINT16 | RW | 单位：% | n | n
0x0164 | 中频震荡起始速度V1 | 0 | 2000 | 1 | OB_UINT16 | RW | 单位：rev/min | n | n
0x0165 | 中频震荡最大速度V2 | 0 | 2000 | 1 | OB_UINT16 | RW | 单位：rev/min | n | n
0x0166 | 电机绕组阻值调整 | 0 | 500 | 0 | OB_UINT16 | RW | 单位：% | n | n
0x0167 | 开环电流环参数调整使能 | 0 | 1 | 0 | OB_UINT16 | RW |  | n | n
0x0168 | 开环电流环比例增益 | 0 | 500 | 0 | OB_UINT16 | RW | 单位：% | n | n
0x0169 | 开环电流环积分增益 | 0 | 500 | 0 | OB_UINT16 | RW | 单位：% | n | n
0x016A | 开环抱轴比例增益 | 0 | 500 | 0 | OB_UINT16 | RW | 单位：% | n | n
0x016B | 开环抱轴积分增益 | 0 | 500 | 0 | OB_UINT16 | RW | 单位：% | n | n
0x016C | 开环比例增益自适应调整使能 | 0 | 1 | 0 | OB_UINT16 | RW |  | n | n
0x016D | 开环比例增益自适应起始比例 | 0 | 1000 | 1 | OB_UINT16 | RW | 单位：千分比 | n | n
0x016E | 开环比例增益自适应起始速度V1 | 0 | 2000 | 1 | OB_UINT16 | RW | 单位：rev/min | n | n
0x016F | 开环比例增益自适应转折速度V2 | 0 | 2000 | 1 | OB_UINT16 | RW | 单位：rev/min | n | n
0x0170 | 开环比例增益自适应限幅 | 0 | 500 | 100 | OB_UINT16 | RW | 单位：% | n | n
0x0171 | 开环电流自适应调整使能 | 0 | 1 | 0 | OB_UINT16 | RW |  | n | n
0x0172 | 开环电流自适应调节起始速度V1 | 0 | 2000 | 1 | OB_UINT16 | RW | 单位：rev/min | n | n
0x0173 | 开环电流自适应调节最大速度V2 | 0 | 2000 | 1 | OB_UINT16 | RW | 单位：rev/min | n | n
0x0174 | 开环电流自适应调节最大限幅 | 0 | 200 | 100 | OB_UINT16 | RW | 单位：% | n | n
0x0175 | 闭环上电锁机电流百分比设置 | 0 | 500 | 0 | OB_UINT16 | RW | 单位：% | n | y
0x0176 | 刹车控制占空比调节百分比 | 0 | 110 | 0 | OB_UINT16 | RW | 单位：% | n | n
0x0177 | 闭环电流环比例系数 | 0 | 500 | 0 | OB_UINT16 | RW | 单位：% | n | y
0x0178 | 闭环电流环积分系数 | 0 | 500 | 0 | OB_UINT16 | RW | 单位：% | n | n
0x0179 | 闭环位置环比例系数 | 0 | 500 | 0 | OB_UINT16 | RW | 单位：% | n | n
0x017A | 闭环位置环积分系数 | 0 | 500 | 0 | OB_UINT16 | RW | 单位：% | n | n
0x017B | 闭环锁机电流比例系数 | 0 | 500 | 0 | OB_UINT16 | RW | 单位：% | n | n
0x017C | 闭环锁机电流积分系数 | 0 | 500 | 0 | OB_UINT16 | RW | 单位：% | n | n
0x017D | 闭环速度环比例系数 | 0 | 500 | 0 | OB_UINT16 | RW | 单位：% | n | n
0x017E | 闭环速度环前馈系数 | 0 | 500 | 0 | OB_UINT16 | RW | 单位：% | n | n
0x017F | 闭环给定速度滤波系数F1 | 0 | 500 | 0 | OB_UINT16 | RW | 单位：% | n | n
0x0180 | 闭环给定速度滤波系数F2 | 0 | 500 | 0 | OB_UINT16 | RW | 单位：% | n | n
0x0181 | 编码器反馈速度滤波系数F1 | 0 | 500 | 0 | OB_UINT16 | RW | 单位：% | n | n
0x0182 | 编码器反馈速度滤波系数F2 | 0 | 500 | 0 | OB_UINT16 | RW | 单位：% | n | n
0x0183 | 闭环编码器线数设置 | 0 | 15 | 0 | OB_UINT16 | RW |  | n | n
0x0184 | 闭环锁机定位精度阈值1 | 0 | 65535 | 0 | OB_UINT16 | RW | 单位：0.1个编码器值 | n | n
0x0185 | 闭环锁机电流动态调节参数1 | 0 | 65535 | 1 | OB_UINT16 | RW | 单位：0.01mA | n | n
0x0186 | 闭环锁机电流动态调节参数2 | 0 | 65535 | 1 | OB_UINT16 | RW | 单位：0.01mA | n | n
0x0187 | 开闭环报警检测使能 | 0 | 65535 | 0 | OB_UINT16 | RW | Bit0:过流 Bit1:过欠压 Bit4:缺相 Bit5:保留 Bit6:回原点超时 Bit7:超差 Bit2~Bit3、Bit8~Bit15:保留 0:不使能对应的报警功能 1:使能对应的报警功能 | n | n
0x0188 | 堵转回零误差限值 | 0 | 65535 | 1 | OB_UINT16 | RW | 单位：1代表0.09° | n | n
0x0189 | 闭环锁机定位精度阈值2 | 0 | 65535 | 0 | OB_UINT16 | RW | 单位：0.1个编码器值 | n | n
0x018A | 闭环锁机积分使能 | 0 | 1 | 0 | OB_UINT16 | RW |  | n | n
0x018B | 闭环锁机积分限幅调整 | 0 | 1000 | 0 | OB_UINT16 | RW | 单位：% | n | n
0x018C | 闭环锁机方式B电流百分比调节 | 0 | 500 | 0 | OB_UINT16 | RW | 单位：% | n | n
0x018D | 闭环锁机方式B电流百分比调节 | 0 | 500 | 0 | OB_UINT16 | RW | 单位：% | n | n
0x018E | 相位存储时间 | 0 | 65535 | 500 | OB_UINT16 | RW | 单位：ms | n | n
0x018F | 机械传动比 | 0 | 0x3232 | 0x0101 | OB_UINT16 | RW | 减速箱输出端与电机端齿轮比，默认1:1 低8位代表电机端，高8位代表减速箱输出端 | n | n
0x0190 | 刹车吸合延时 | 0 | 65535 | 0 | OB_UINT16 | RW | 单位：ms | n | n
0x0191 | 刹车松开延时 | 0 | 65535 | 0 | OB_UINT16 | RW | 单位：ms | n | n
0x0192 | 刹车控制选择 | 0 | 2 | 0 | OB_UINT16 | RW |  | n | n
0x0193 | 主站控制刹车使能 | 0 | 1 | 0 | OB_UINT16 | RW |  | n | n
0x01EB | 自校准模式选择 | 0 | 1 | 0 | OB_UINT16 | RW | (厂家参数）0：闭环正常工作模式 1：闭环自校准模式 | n | y
0x01EC | 自校准功能使能/禁止 | 0 | 1 | 0 | OB_UINT16 | RW | (厂家参数）0：禁止 1：使能 在开启前，需确保已设定好想要的自校准速度区间 | n | y
0x01ED | 自校准速度区间设定 | 0 | 7 | 0 | OB_UINT16 | RW | (厂家参数）需先设定好想要的自校准速度区间，再开启自校准功能；若默认的速度区间是想要的自校准速度范围，则不需操作此寄存器 | n | n
0x01EE | 自校准状态获取 | 0 | 65535 | 0 | OB_UINT16 | RO | (厂家参数）0：没有执行自校准 1：正在自校准 2：自校准失败 3：自校准成功； | n | y
0x01EF | 保存EEPROM指令 | 0 | 1 | 0 | OB_UINT16 | RW | 0：禁止保存EEPROM指令 1：执行保存EEPROM指令； | n | y
