Frrrrrrrrrank/Underwater-Glider/Datasheet/UMotor/UMLR闭环一体式系列调试软件V1.0(1)/UMLR闭环一体式系列调试软件V1.0/UMLR闭环RS485系列调试软件-V1.0/png/hm/home_18.png

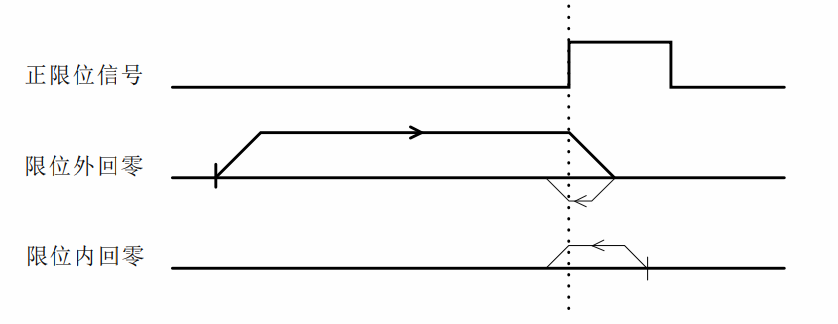
Datasheet/UMotor/UMLR闭环一体式系列调试软件V1.0(1)/UMLR闭环一体式系列调试软件V1.0/UMLR闭环RS485系列调试软件-V1.0/png/hm/home_18.png
