Frrrrrrrrrank/Underwater-Glider/UnderwaterGlider/UnderwaterGlider.pdf

MainControl File: MainControl.kicad_sch Power File: Power.kicad_sch

Id: 1/3 Title: File: UnderwaterGlider.kicad_sch Sheet: /

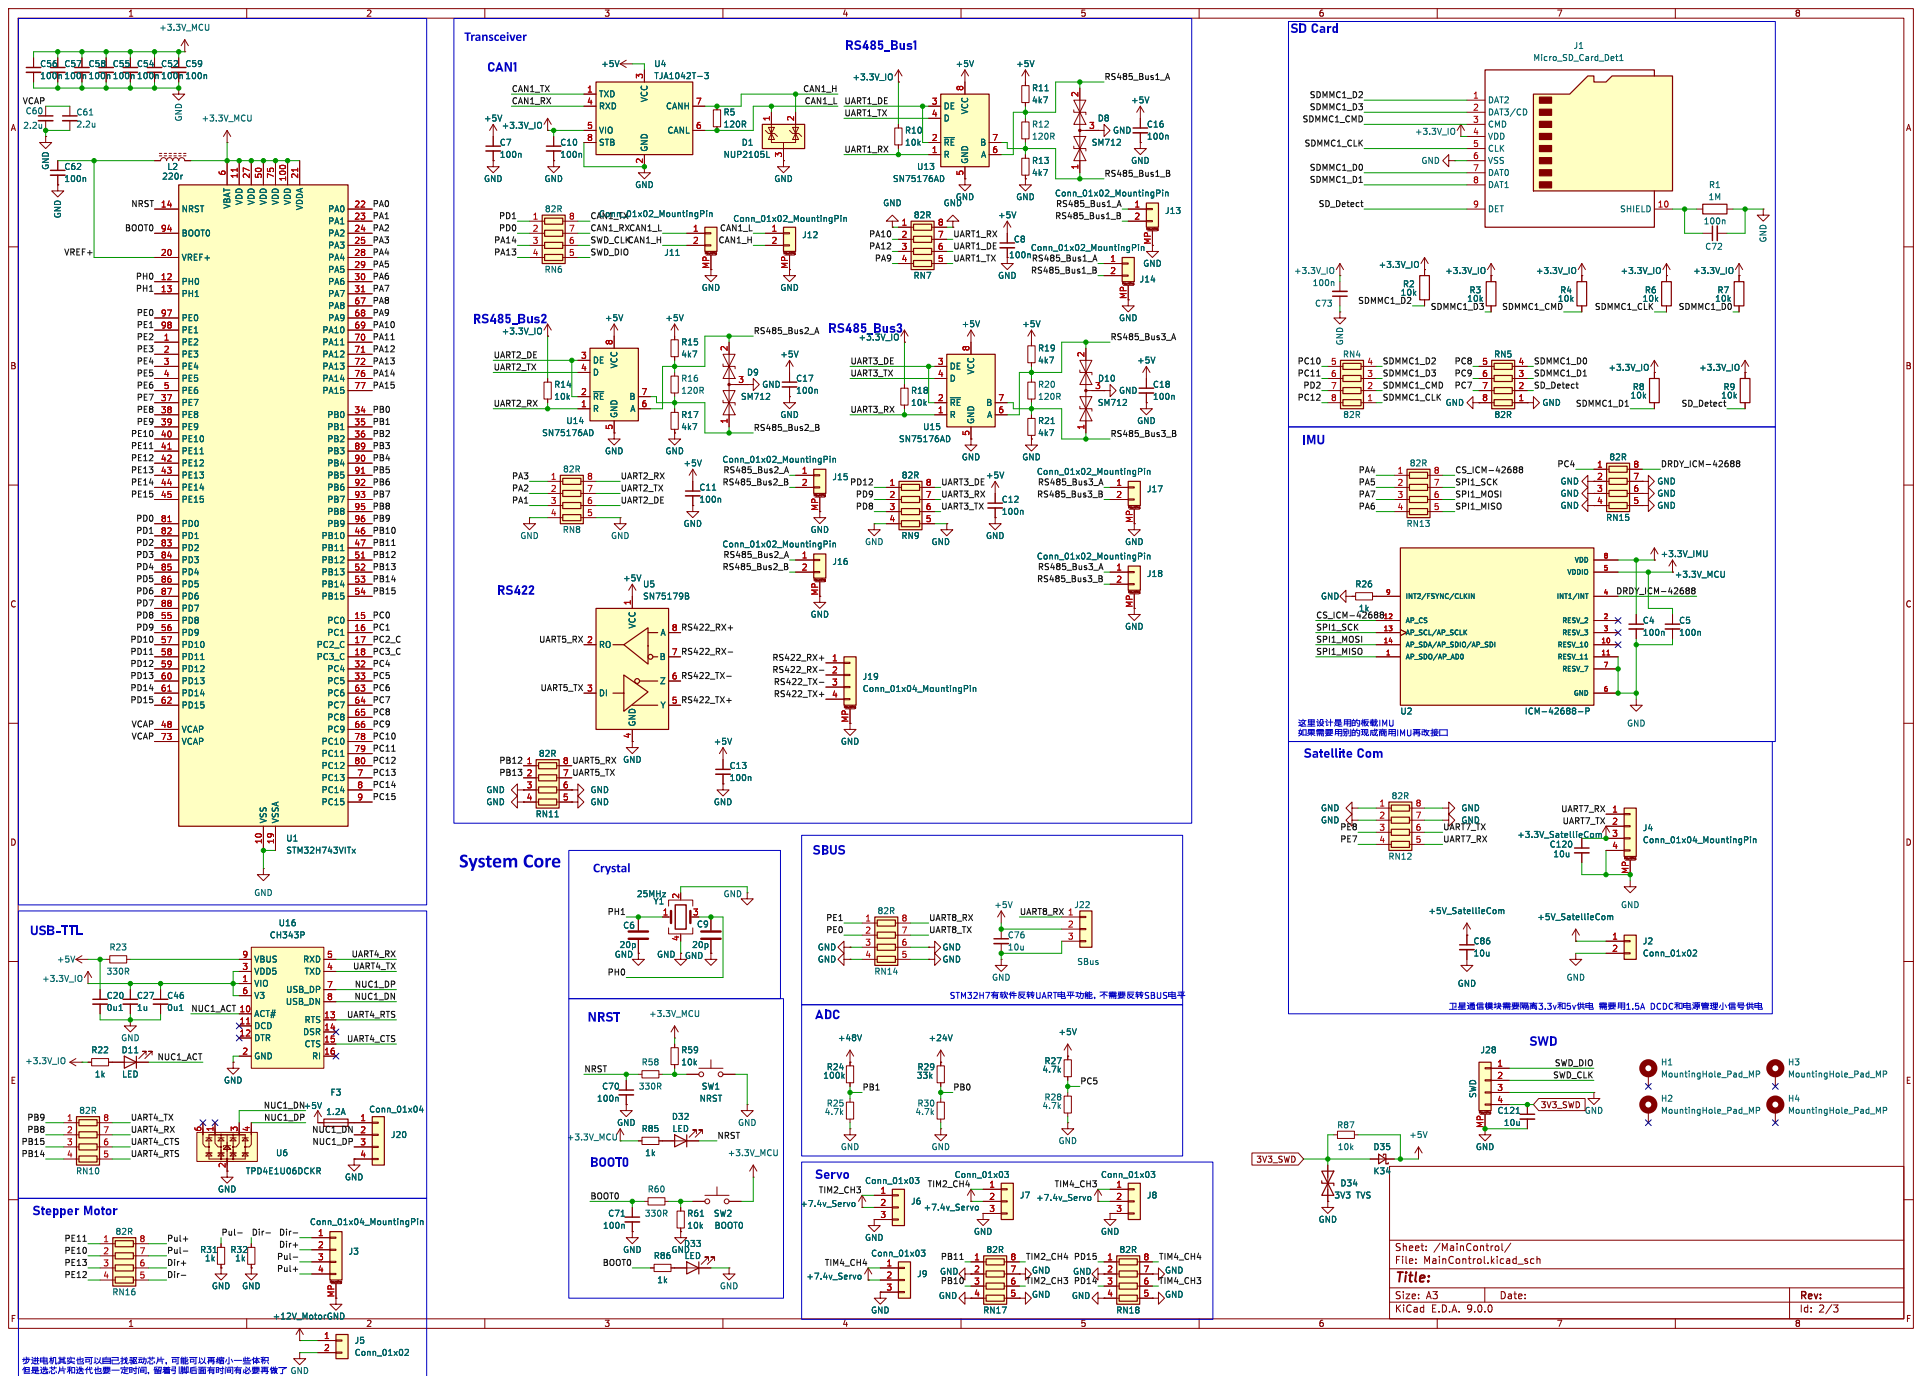
[picture p35: page 2]

6 VDD 11 VDD 27 VDD 50 VSS 10 VDD 75 VSSA 19 VDD 100 VDDA 21 PA0 22 PA1 23 PA2 24 PA3 25 PA4 28 PA5 29 PA6 30 PA7 31 PA8 67 PA9 68 PA10 69 PA11 70 PA12 71 PA13 72 PA14 76 PA15 77 PB0 34 PB1 35 PB2 36 PB3 89 PB4 90 PB5 91 PB6 92 PB7 93 PB8 95 PB9 96 PB10 46 PB11 47 PB12 51 PB13 52 PB14 53 PB15 54 PC0 15 PC1 16 PC2_C 17 PC3_C 18 PC4 32 PC5 33 PC6 63 PC7 64 PC8 65 PC9 66 PC10 78 PC11 79 PC12 80 PC13 7 PC14 8 PC15 9 U1STM32H743VITx

6 VDD 11 VDD 27 VDD 50 VSS 10 VDD 75 VSSA 19 VDD 100 VDDA 21 PA0 22 PA1 23 PA2 24 PA3 25 PA4 28 PA5 29 PA6 30 PA7 31 PA8 67 PA9 68 PA10 69 PA11 70 PA12 71 PA13 72 PA14 76 PA15 77 PB0 34 PB1 35 PB2 36 PB3 89 PB4 90 PB5 91 PB6 92 PB7 93 PB8 95 PB9 96 PB10 46 PB11 47 PB12 51 PB13 52 PB14 53 PB15 54 PC0 15 PC1 16 PC2_C 17 PC3_C 18 PC4 32 PC5 33 PC6 63 PC7 64 PC8 65 PC9 66 PC10 78 PC11 79 PC12 80 PC13 7 PC14 8 PC15 9 U5SN75179B RO 2 DI 3 VCC

þÿY‚gœ—‰•u(R+v„s°bUFu(IMUQ•e9c¥Sã
Satellite Com

þÿSTM32H7g •oNöSÍ•lUARTu5^sRŸ€ýÿN

þÿSkf•Oáj!WW—‰•–”y»3.3vTŒ5vO›u5 þÿ—‰•u(1.5A þÿDCDCTŒu5n•{¡t\OáS÷O›u5
J28 SWD GND

þÿke•Ûu5g:Qv[žN_SïNå•ê]ñb~šqR¨‚¯rGÿSï€ýSïNåQ••)\NN›OSyï þÿOFf/• ‚¯rGTŒ•íNãN_‰•N[šeö•ôÿuYw@_•T—bg eö•ôg _Å‰•Q•PZN†

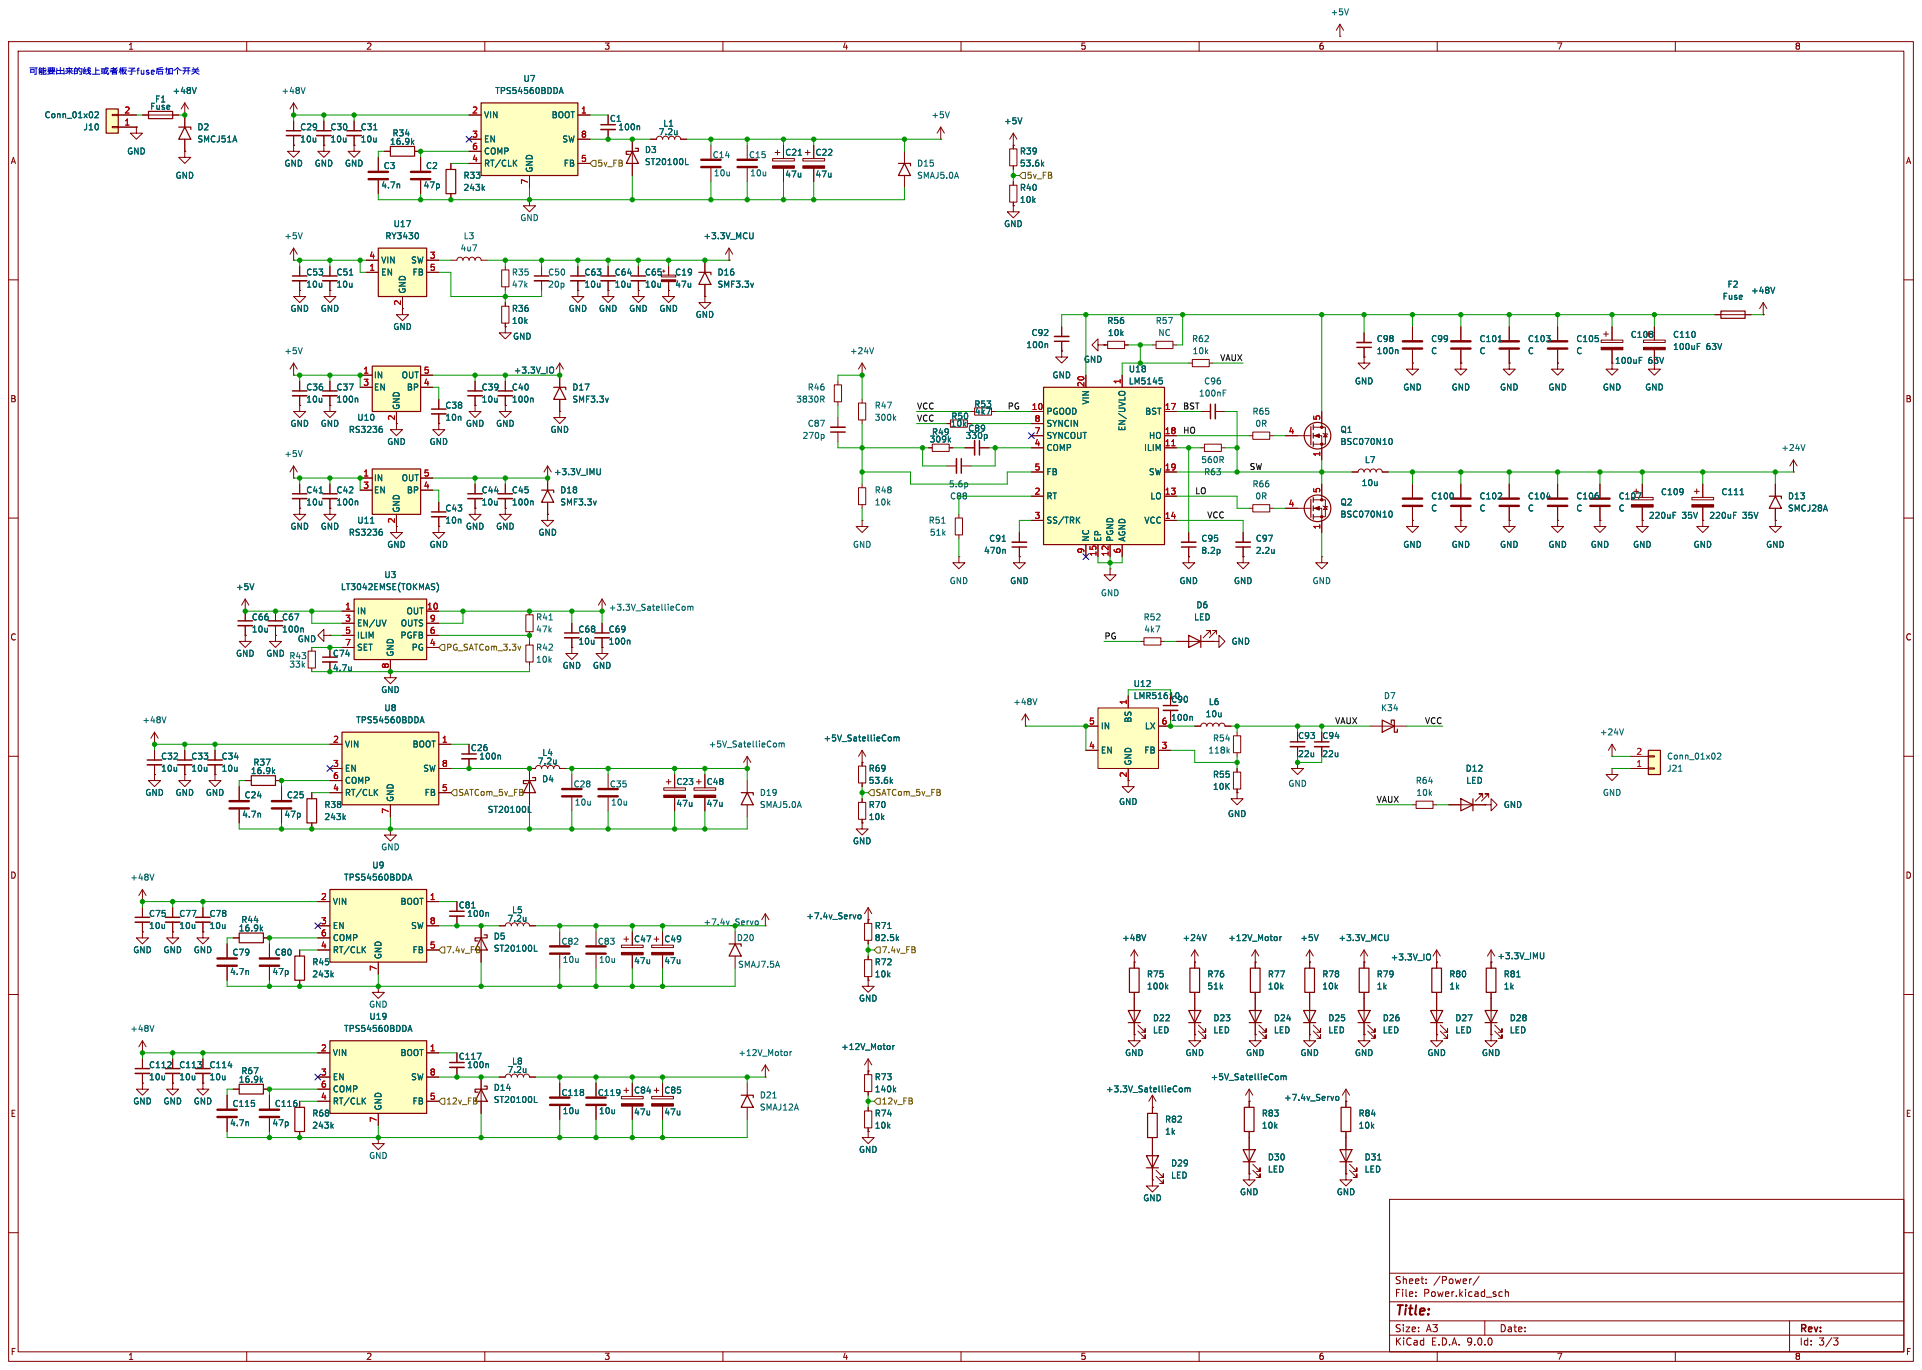
[picture p36: page 3]

7 BOOT 1 SW 8 FB 5 GND

8 OUT 10 OUTS 9 PGFB 6 PG 4 C63
47u GND

2 OUT 5 BP 4 GND GND GND
10u GND

9 EP 15 PGND 12 EN/UVLO

8 OUT 10 OUTS 9 PGFB 6 PG 4 U3

7 BOOT 1 SW 8 FB 5 U19 TPS54560BDDA GND
