Frrrrrrrrrank/Underwater-Glider/UnderwaterGlider/UnderwaterGlider.kicad_pcb

## KiCad design UnderwaterGlider/UnderwaterGlider.kicad_pcb (2026-04-10)

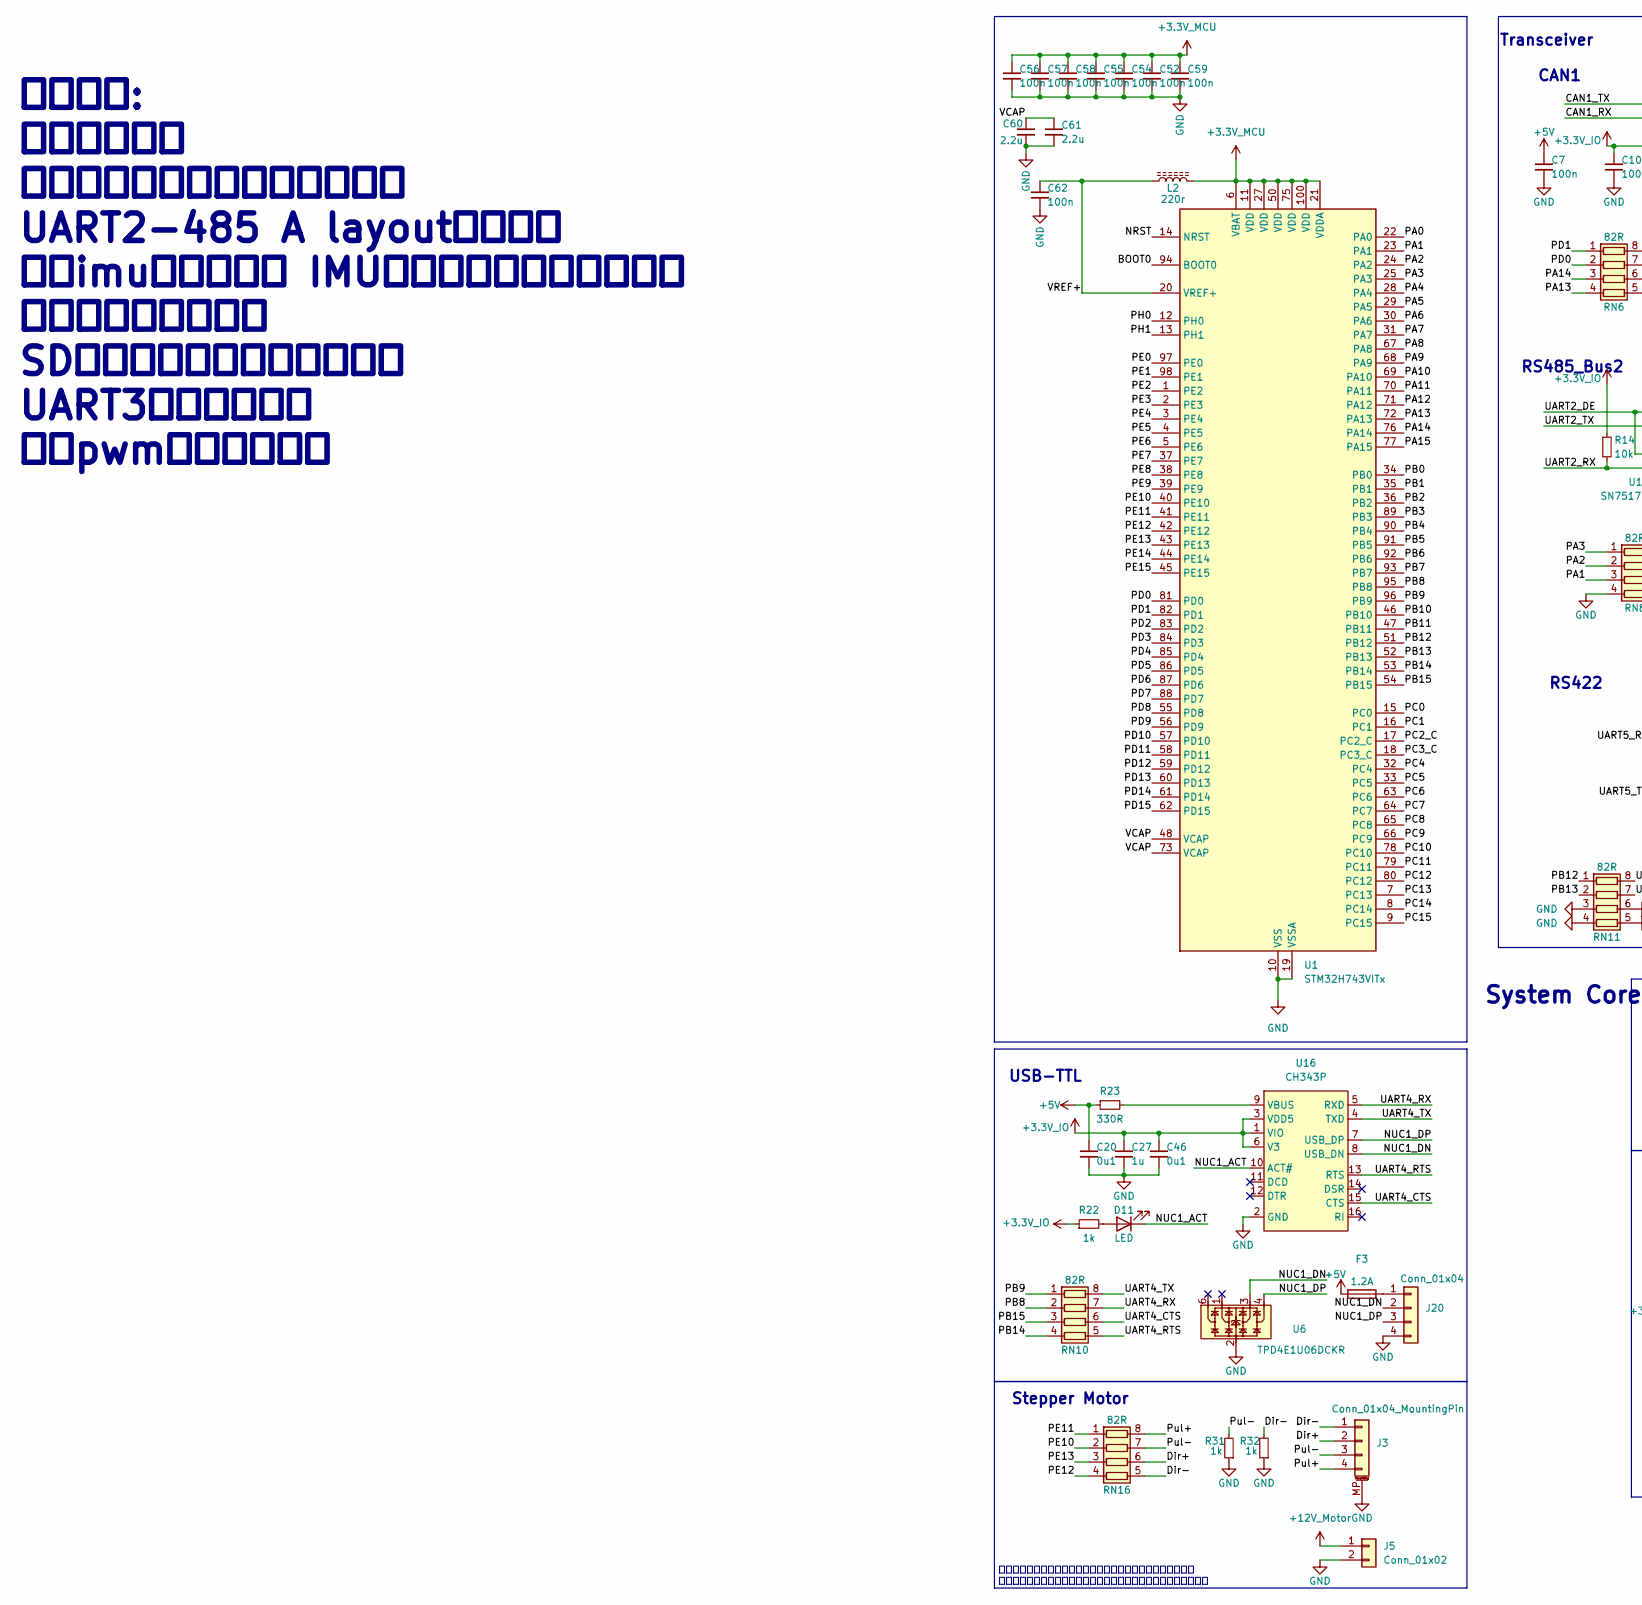
[picture p37: schematic MainControl.kicad_sch, part in row 1, column 1]

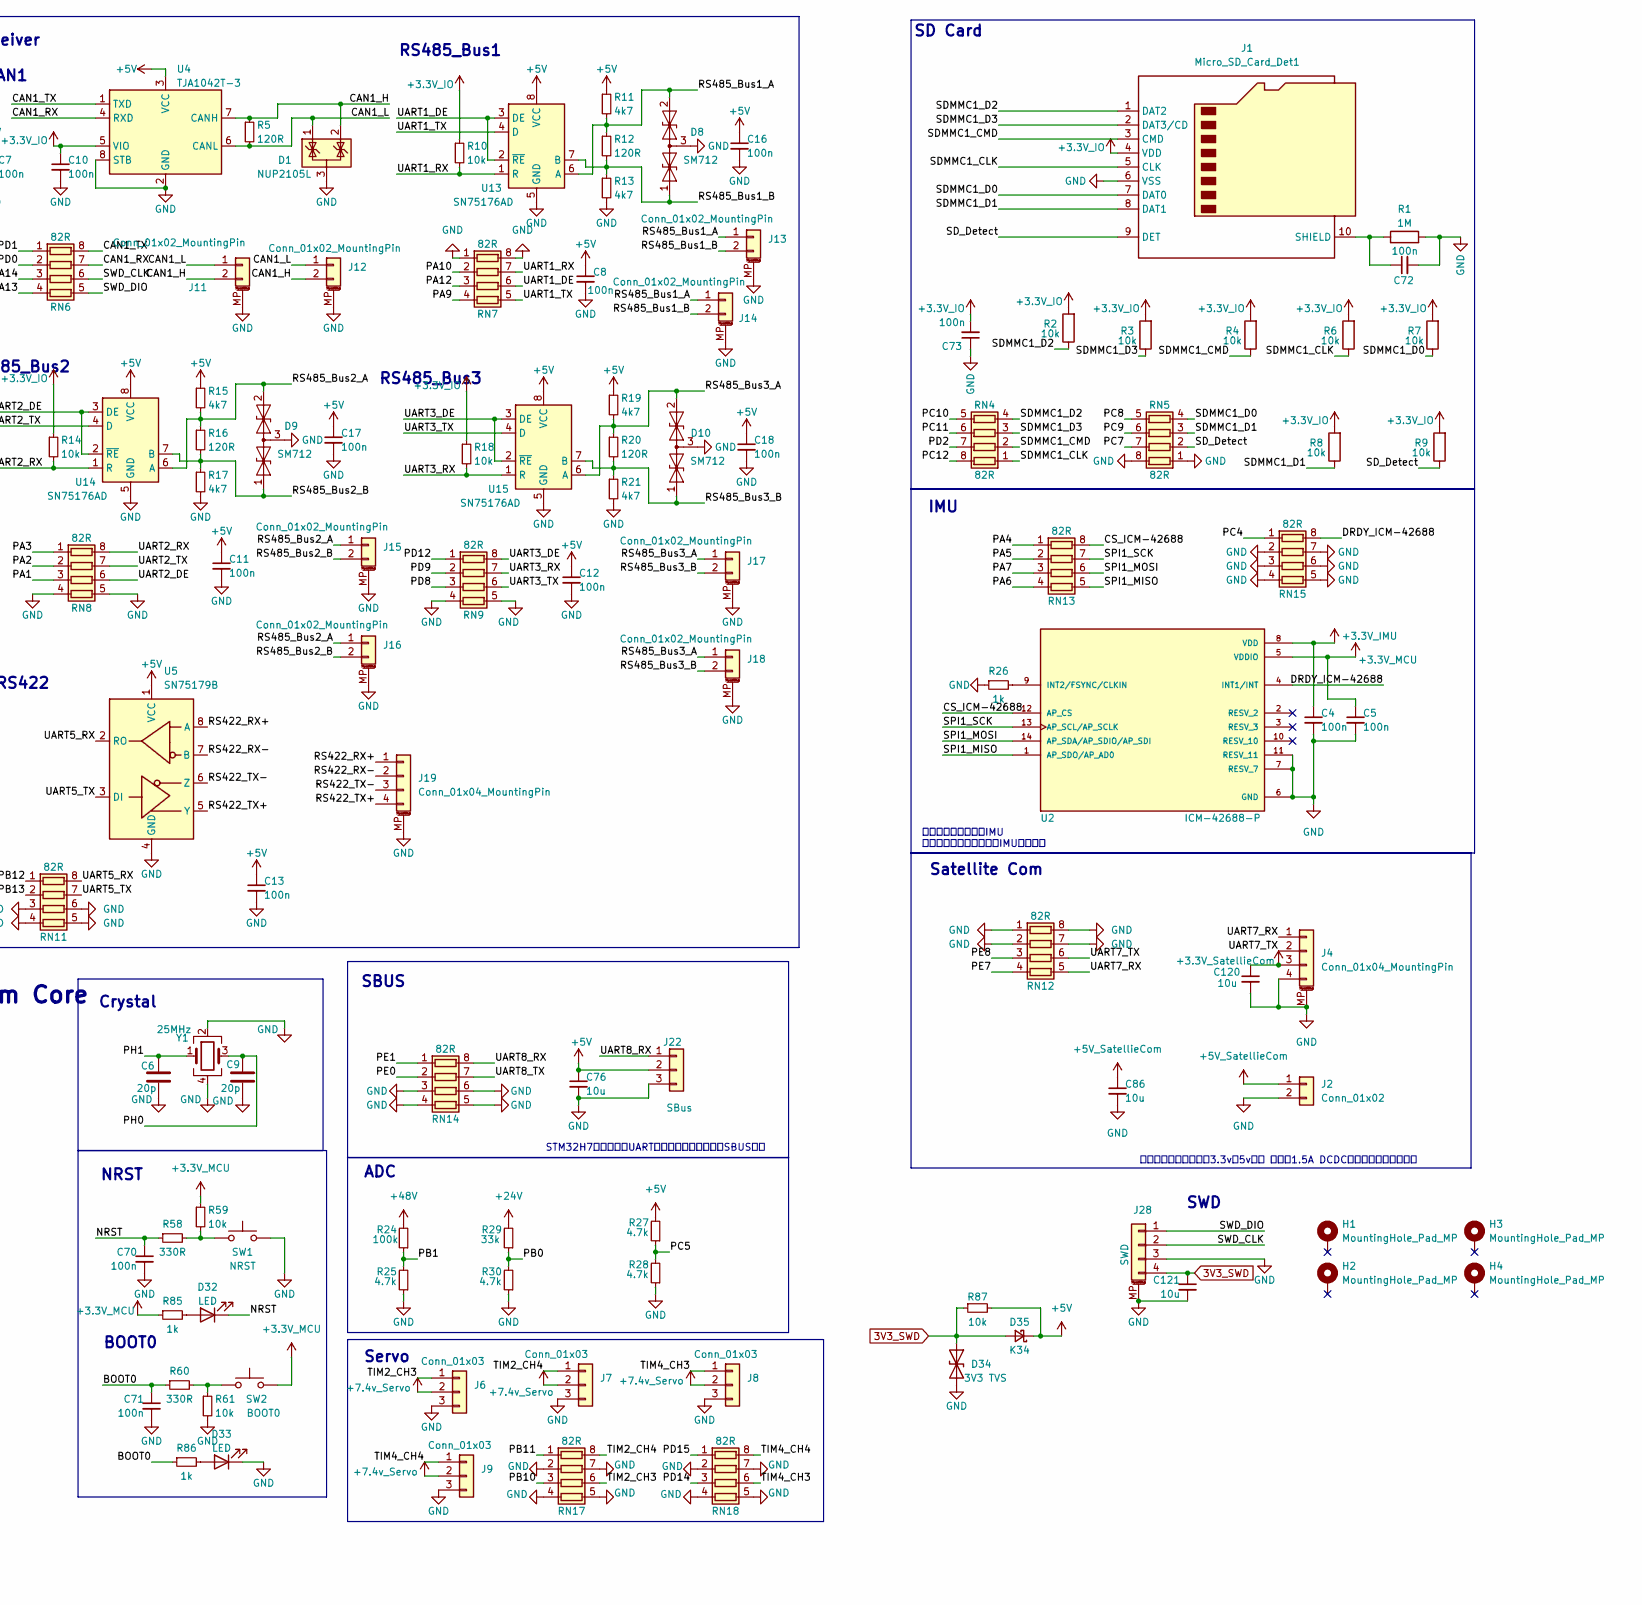
[picture p38: schematic MainControl.kicad_sch, part in row 1, column 2]

Parts:
C4, C5, C7, C8, C10, C11, C12, C13, C16, C17, C18, C52, C54, C55, C56, C57, C58, C59, C62, C70, C71, C72, C73: 100n; C_0603_1608Metric
C6, C9: 20p; C_0603_1608Metric
C20, C46: 0u1; C_0603_1608Metric
C27: 1u; C_0603_1608Metric
C60, C61: 2.2u; C_0603_1608Metric
C76, C86, C120, C121: 10u; C_0603_1608Metric
D1: NUP2105L; SOT-23
D8, D9, D10: SM712; SOT-23
D11, D32, D33: LED; LED_0603_1608Metric
D34: 3V3 TVS; D_SMF
D35: K34; D_SMF
F3: 1.2A; Fuse_1210_3225Metric
H1, H2, H3, H4: MountingHole_Pad_MP; MountingHole_3.2mm_M3_Pad_Via
J1: Micro_SD_Card_Det1; TF-SMD_TF-PUSH
J2, J5: Conn_01x02; JST_PH_B2B-PH-K_1x02_P2.00mm_Vertical
J3, J4: Conn_01x04_MountingPin; JST_GH_SM04B-GHS-TB_1x04-1MP_P1.25mm_Horizontal
J6, J7, J8, J9: Conn_01x03; JST_PH_B3B-PH-K_1x03_P2.00mm_Vertical
J11, J12, J13, J14, J15, J16, J17, J18: Conn_01x02_MountingPin; JST_GH_SM02B-GHS-TB_1x02-1MP_P1.25mm_Horizontal
J19: Conn_01x04_MountingPin; JST_GH_BM04B-GHS-TBT_1x04-1MP_P1.25mm_Vertical
J20: Conn_01x04; JST_PH_B4B-PH-K_1x04_P2.00mm_Vertical
J22: SBus; PinHeader_1x03_P2.54mm_Vertical
J28: SWD; Molex_PicoBlade_53261-0471_1x04-1MP_P1.25mm_Horizontal
L2: 220r; L_0603_1608Metric
R1: 1M; R_0603_1608Metric
R2, R3, R4, R6, R7, R8, R9, R10, R14, R18, R59, R61, R87: 10k; R_0603_1608Metric
R5, R12, R16, R20: 120R; R_0603_1608Metric
R11, R13, R15, R17, R19, R21: 4k7; R_0603_1608Metric
R22, R26, R31, R32, R85, R86: 1k; R_0603_1608Metric
R23, R58, R60: 330R; R_0603_1608Metric
R24: 100k; R_0603_1608Metric
R25, R27, R28, R30: 4.7k; R_0603_1608Metric
R29: 33k; R_0603_1608Metric
RN4, RN5, RN6, RN7, RN8, RN9, RN10, RN11, RN12, RN13, RN14, RN15, RN16, RN17, RN18: 82R; R_Array_Concave_4x0603
SW1: NRST; Panasonic_EVQPUL_EVQPUC
SW2: BOOT0; Panasonic_EVQPUL_EVQPUC
U1: STM32H743VITx; LQFP-100_14x14mm_P0.5mm
U2: ICM-42688-P; PQFN50P300X250X97-14N; PARTREV 1.2
U4: TJA1042T-3; SOIC-8_3.9x4.9mm_P1.27mm
U5: SN75179B; SOIC-8_3.9x4.9mm_P1.27mm
U6: TPD4E1U06DCKR; SOT-363_SC-70-6
U13, U14, U15: SN75176AD; SOIC-8_3.9x4.9mm_P1.27mm
U16: CH343P; TQFN-16-1EP_3x3mm_P0.5mm_EP1.6x1.6mm
Y1: 25MHz; Crystal_SMD_3225-4Pin_3.2x2.5mm

Connections:
3V3_SWD: C121.1, D34.1 (A1), D35.2 (A), J28.4, R87.1
+3.3V_IMU: C4.1, U2.8 (VDD); also elsewhere on the board
+3.3V_IO: C10.1, C27.1, C46.1, C73.2, J1.4 (VDD), R2.2, R3.2, R4.2, R6.2, R7.2, R8.2, R9.2, R10.1, R14.1, R18.1, R22.1, U4.5 (VIO), U16.1 (VIO), U16.3 (VDD5), U16.6 (V3); also elsewhere on the board
+3.3V_MCU: C5.1, C52.1, C54.1, C55.1, C56.1, C57.1, C58.1, C59.1, L2.2, R59.1, R85.1, SW2.2, U1.6 (VBAT), U1.11 (VDD), U1.21 (VDDA), U1.27 (VDD), U1.50 (VDD), U1.75 (VDD), U1.100 (VDD), U2.5 (VDDIO); also elsewhere on the board
+3.3V_SatellieCom: C120.1, J4.3; also elsewhere on the board
+5V: C7.1, C8.1, C11.1, C12.1, C13.1, C16.1, C17.1, C18.1, C20.1, C76.1, D35.1 (K), F3.1, J22.2, R11.1, R15.1, R19.1, R23.1, R27.2, R87.2, U4.3 (VCC), U5.1 (VCC), U13.8 (VCC), U14.8 (VCC), U15.8 (VCC); also elsewhere on the board
+5V_SatellieCom: C86.1, J2.1; also elsewhere on the board
+7.4v_Servo: J6.2, J7.2, J8.2, J9.2; also elsewhere on the board
+12V_Motor: J5.1; also elsewhere on the board
+24V: R29.2; also elsewhere on the board
+48V: R24.2; also elsewhere on the board
/MainControl/BOOT0: C71.1, R60.1, R86.1, U1.94 (BOOT0)
/MainControl/CAN1_H: D1.2 (K), J11.2, J12.2, R5.1, U4.7 (CANH)
/MainControl/CAN1_L: D1.1 (K), J11.1, J12.1, R5.2, U4.6 (CANL)
/MainControl/CAN1_RX: RN6.7 (R2.2), U4.4 (RXD)
/MainControl/CAN1_TX: RN6.8 (R1.2), U4.1 (TXD)
/MainControl/CS_ICM-42688: RN13.8 (R1.2), U2.12 (AP_CS)
/MainControl/DRDY_ICM-42688: RN15.8 (R1.2), U2.4 (INT1/INT)
/MainControl/Dir+: J3.2, RN16.6 (R3.2)
/MainControl/Dir-: J3.1, R32.2, RN16.5 (R4.2)
/MainControl/NRST: C70.1, D32.1 (K), R58.1, U1.14 (NRST)
/MainControl/NUC1_ACT: D11.1 (K), U16.10 (ACT#)
/MainControl/NUC1_DN: J20.2, U6.3, U16.8 (USB_DN)
/MainControl/NUC1_DP: J20.3, U6.4, U16.7 (USB_DP)
/MainControl/PA0: U1.22 (PA0)
/MainControl/PA1: RN8.3 (R3.1), U1.23 (PA1)
/MainControl/PA2: RN8.2 (R2.1), U1.24 (PA2)
/MainControl/PA3: RN8.1 (R1.1), U1.25 (PA3)
/MainControl/PA4: RN13.1 (R1.1), U1.28 (PA4)
/MainControl/PA5: RN13.2 (R2.1), U1.29 (PA5)
/MainControl/PA6: RN13.4 (R4.1), U1.30 (PA6)
/MainControl/PA7: RN13.3 (R3.1), U1.31 (PA7)
/MainControl/PA8: U1.67 (PA8)
/MainControl/PA9: RN7.4 (R4.1), U1.68 (PA9)
/MainControl/PA10: RN7.2 (R2.1), U1.69 (PA10)
/MainControl/PA11: U1.70 (PA11)
/MainControl/PA12: RN7.3 (R3.1), U1.71 (PA12)
/MainControl/PA13: RN6.4 (R4.1), U1.72 (PA13)
/MainControl/PA14: RN6.3 (R3.1), U1.76 (PA14)
/MainControl/PA15: U1.77 (PA15)
/MainControl/PB0: R29.1, R30.2, U1.34 (PB0)
/MainControl/PB1: R24.1, R25.2, U1.35 (PB1)
/MainControl/PB2: U1.36 (PB2)
/MainControl/PB3: U1.89 (PB3)
/MainControl/PB4: U1.90 (PB4)
/MainControl/PB5: U1.91 (PB5)
/MainControl/PB6: U1.92 (PB6)
/MainControl/PB7: U1.93 (PB7)
/MainControl/PB8: RN10.2 (R2.1), U1.95 (PB8)
/MainControl/PB9: RN10.1 (R1.1), U1.96 (PB9)
/MainControl/PB10: RN17.3 (R3.1), U1.46 (PB10)
/MainControl/PB11: RN17.1 (R1.1), U1.47 (PB11)
/MainControl/PB12: RN11.1 (R1.1), U1.51 (PB12)
/MainControl/PB13: RN11.2 (R2.1), U1.52 (PB13)
/MainControl/PB14: RN10.4 (R4.1), U1.53 (PB14)
/MainControl/PB15: RN10.3 (R3.1), U1.54 (PB15)
/MainControl/PC0: U1.15 (PC0)
/MainControl/PC1: U1.16 (PC1)
/MainControl/PC2_C: U1.17 (PC2_C)
/MainControl/PC3_C: U1.18 (PC3_C)
/MainControl/PC4: RN15.1 (R1.1), U1.32 (PC4)
/MainControl/PC5: R27.1, R28.2, U1.33 (PC5)
/MainControl/PC6: U1.63 (PC6)
/MainControl/PC7: RN5.7 (R2.2), U1.64 (PC7)
/MainControl/PC8: RN5.5 (R4.2), U1.65 (PC8)
/MainControl/PC9: RN5.6 (R3.2), U1.66 (PC9)
/MainControl/PC10: RN4.5 (R4.2), U1.78 (PC10)
/MainControl/PC11: RN4.6 (R3.2), U1.79 (PC11)
/MainControl/PC12: RN4.8 (R1.2), U1.80 (PC12)
/MainControl/PC13: U1.7 (PC13)
/MainControl/PC14: U1.8 (PC14)
/MainControl/PC15: U1.9 (PC15)
/MainControl/PD0: RN6.2 (R2.1), U1.81 (PD0)
/MainControl/PD1: RN6.1 (R1.1), U1.82 (PD1)
/MainControl/PD2: RN4.7 (R2.2), U1.83 (PD2)
/MainControl/PD3: U1.84 (PD3)
/MainControl/PD4: U1.85 (PD4)
/MainControl/PD5: U1.86 (PD5)
/MainControl/PD6: U1.87 (PD6)
/MainControl/PD7: U1.88 (PD7)
/MainControl/PD8: RN9.3 (R3.1), U1.55 (PD8)
/MainControl/PD9: RN9.2 (R2.1), U1.56 (PD9)
/MainControl/PD10: U1.57 (PD10)
/MainControl/PD11: U1.58 (PD11)
/MainControl/PD12: RN9.1 (R1.1), U1.59 (PD12)
/MainControl/PD13: U1.60 (PD13)
/MainControl/PD14: RN18.3 (R3.1), U1.61 (PD14)
/MainControl/PD15: RN18.1 (R1.1), U1.62 (PD15)
/MainControl/PE0: RN14.2 (R2.1), U1.97 (PE0)
/MainControl/PE1: RN14.1 (R1.1), U1.98 (PE1)
/MainControl/PE2: U1.1 (PE2)
/MainControl/PE3: U1.2 (PE3)
/MainControl/PE4: U1.3 (PE4)
/MainControl/PE5: U1.4 (PE5)
/MainControl/PE6: U1.5 (PE6)
/MainControl/PE7: RN12.4 (R4.1), U1.37 (PE7)
/MainControl/PE8: RN12.3 (R3.1), U1.38 (PE8)
/MainControl/PE9: U1.39 (PE9)
/MainControl/PE10: RN16.2 (R2.1), U1.40 (PE10)
/MainControl/PE11: RN16.1 (R1.1), U1.41 (PE11)
/MainControl/PE12: RN16.4 (R4.1), U1.42 (PE12)
/MainControl/PE13: RN16.3 (R3.1), U1.43 (PE13)
/MainControl/PE14: U1.44 (PE14)
/MainControl/PE15: U1.45 (PE15)
/MainControl/PH0: C9.1, U1.12 (PH0), Y1.3
/MainControl/PH1: C6.1, U1.13 (PH1), Y1.1
/MainControl/Pul+: J3.4, RN16.8 (R1.2)
/MainControl/Pul-: J3.3, R31.2, RN16.7 (R2.2)
/MainControl/RS422_RX+: J19.1, U5.8 (A)
/MainControl/RS422_RX-: J19.2, U5.7 (B)
/MainControl/RS422_TX+: J19.4, U5.5 (Y)
/MainControl/RS422_TX-: J19.3, U5.6 (Z)
/MainControl/RS485_Bus1_A: D8.2 (A2), J13.1, J14.1, R11.2, R12.1, U13.6 (A)
/MainControl/RS485_Bus1_B: D8.1 (A1), J13.2, J14.2, R12.2, R13.1, U13.7 (B)
/MainControl/RS485_Bus2_A: D9.2 (A2), J15.1, J16.1, R15.2, R16.1, U14.6 (A)
/MainControl/RS485_Bus2_B: D9.1 (A1), J15.2, J16.2, R16.2, R17.1, U14.7 (B)
/MainControl/RS485_Bus3_A: D10.2 (A2), J17.1, J18.1, R19.2, R20.1, U15.6 (A)
/MainControl/RS485_Bus3_B: D10.1 (A1), J17.2, J18.2, R20.2, R21.1, U15.7 (B)
/MainControl/SDMMC1_CLK: J1.5 (CLK), R6.1, RN4.1 (R1.1)
/MainControl/SDMMC1_CMD: J1.3 (CMD), R4.1, RN4.2 (R2.1)
/MainControl/SDMMC1_D0: J1.7 (DAT0), R7.1, RN5.4 (R4.1)
/MainControl/SDMMC1_D1: J1.8 (DAT1), R8.1, RN5.3 (R3.1)
/MainControl/SDMMC1_D2: J1.1 (DAT2), R2.1, RN4.4 (R4.1)
/MainControl/SDMMC1_D3: J1.2 (DAT3/CD), R3.1, RN4.3 (R3.1)
/MainControl/SD_Detect: J1.9 (DET), R9.1, RN5.2 (R2.1)
/MainControl/SPI1_MISO: RN13.5 (R4.2), U2.1 (AP_SDO/AP_AD0)
/MainControl/SPI1_MOSI: RN13.6 (R3.2), U2.14 (AP_SDA/AP_SDIO/AP_SDI)
/MainControl/SPI1_SCK: RN13.7 (R2.2), U2.13 (AP_SCL/AP_SCLK)
/MainControl/SWD_CLK: J28.2, RN6.6 (R3.2)
/MainControl/SWD_DIO: J28.1, RN6.5 (R4.2)
/MainControl/TIM2_CH3: J6.1, RN17.6 (R3.2)
/MainControl/TIM2_CH4: J7.1, RN17.8 (R1.2)
/MainControl/TIM4_CH3: J8.1, RN18.6 (R3.2)
/MainControl/TIM4_CH4: J9.1, RN18.8 (R1.2)
/MainControl/UART1_DE: RN7.6 (R3.2), U13.2 (~RE), U13.3 (DE)
/MainControl/UART1_RX: R10.2, RN7.7 (R2.2), U13.1 (R)
/MainControl/UART1_TX: RN7.5 (R4.2), U13.4 (D)
/MainControl/UART2_DE: RN8.6 (R3.2), U14.2 (~RE), U14.3 (DE)
/MainControl/UART2_RX: R14.2, RN8.8 (R1.2), U14.1 (R)
/MainControl/UART2_TX: RN8.7 (R2.2), U14.4 (D)
/MainControl/UART3_DE: RN9.8 (R1.2), U15.2 (~RE), U15.3 (DE)
/MainControl/UART3_RX: R18.2, RN9.7 (R2.2), U15.1 (R)
/MainControl/UART3_TX: RN9.6 (R3.2), U15.4 (D)
/MainControl/UART4_CTS: RN10.6 (R3.2), U16.15 (CTS)
/MainControl/UART4_RTS: RN10.5 (R4.2), U16.13 (RTS)
/MainControl/UART4_RX: RN10.7 (R2.2), U16.5 (RXD)
/MainControl/UART4_TX: RN10.8 (R1.2), U16.4 (TXD)
/MainControl/UART5_RX: RN11.8 (R1.2), U5.2 (RO)
/MainControl/UART5_TX: RN11.7 (R2.2), U5.3 (DI)
/MainControl/UART7_RX: J4.1, RN12.5 (R4.2)
/MainControl/UART7_TX: J4.2, RN12.6 (R3.2)
/MainControl/UART8_RX: J22.1, RN14.8 (R1.2)
/MainControl/UART8_TX: RN14.7 (R2.2)
/MainControl/VCAP: C60.1, C61.1, U1.48 (VCAP), U1.73 (VCAP)
/MainControl/VREF+: C62.1, L2.1, U1.20 (VREF+)
GND: C4.2, C5.2, C6.2, C7.2, C8.2, C9.2, C10.2, C11.2, C12.2, C13.2, C16.2, C17.2, C18.2, C20.2, C27.2, C46.2, C52.2, C54.2, C55.2, C56.2, C57.2, C58.2, C59.2, C60.2, C61.2, C62.2, C70.2, C71.2, C72.2, C73.1, C76.2, C86.2, C120.2, C121.2, D1.3 (A), D8.3 (common), D9.3 (common), D10.3 (common), D33.1 (K), D34.2 (A2), J1.6 (VSS), J2.2, J3.MP (MountPin), J4.4, J4.MP (MountPin), J5.2, J6.3, J7.3, J8.3, J9.3, J11.MP (MountPin), J12.MP (MountPin), J13.MP (MountPin), J14.MP (MountPin), J15.MP (MountPin), J16.MP (MountPin), J17.MP (MountPin), J18.MP (MountPin), J19.MP (MountPin), J20.4, J22.3, J28.3, J28.MP (MountPin), R1.2, R13.2, R17.2, R21.2, R25.1, R26.1, R28.1, R30.1, R31.1, R32.1, R61.2, RN5.1 (R1.1), RN5.8 (R1.2), RN7.1 (R1.1), RN7.8 (R1.2), RN8.4 (R4.1), RN8.5 (R4.2), RN9.4 (R4.1), RN9.5 (R4.2), RN11.3 (R3.1), RN11.4 (R4.1), RN11.5 (R4.2), RN11.6 (R3.2), RN12.1 (R1.1), RN12.2 (R2.1), RN12.7 (R2.2), RN12.8 (R1.2), RN14.3 (R3.1), RN14.4 (R4.1), RN14.5 (R4.2), RN14.6 (R3.2), RN15.2 (R2.1), RN15.3 (R3.1), RN15.4 (R4.1), RN15.5 (R4.2), RN15.6 (R3.2), RN15.7 (R2.2), RN17.2 (R2.1), RN17.4 (R4.1), RN17.5 (R4.2), RN17.7 (R2.2), RN18.2 (R2.1), RN18.4 (R4.1), RN18.5 (R4.2), RN18.7 (R2.2), SW1.2, U1.10 (VSS), U1.19 (VSSA), U1.26 (VSS), U1.49 (VSS), U1.74 (VSS), U1.99 (VSS), U2.6 (GND), U2.7 (RESV_7), U2.11 (RESV_11), U4.2 (GND), U4.8 (STB), U5.4 (GND), U6.2, U13.5 (GND), U14.5 (GND), U15.5 (GND), U16.2 (GND), U16.17 (GND), Y1.2, Y1.4; also elsewhere on the board
unnamed: D11.2 (A), R22.2
unnamed: D32.2 (A), R85.2
unnamed: D33.2 (A), R86.2
unnamed: C72.1, J1.10 (SHIELD), R1.1
unnamed: F3.2, J20.1
unnamed: R58.2, R59.2, SW1.1
unnamed: R60.2, R61.1, SW2.1
unnamed: R26.2, U2.9 (INT2/FSYNC/CLKIN)
unnamed: R23.2, U16.9 (VBUS)

Notes on the sheet:
IMU
Stepper Motor
SBUS
Crystal
RS485_Bus1
USB-TTL
Transceiver
RS485_Bus3
迭代意见: 接口用竖插的 电源分少一些别再这块板上画了 UART2-485 A layout少一根线 板载imu不一定要了 IMU封装有问题阻焊层没去掉 把其他引脚也引出来 SD卡测试完再迭代还是直接迭 UART3有个丝印反了 舵机pwm接口丝印反了
卫星通信模块需要隔离3.3v和5v供电 需要用1.5A DCDC和电源管理小信号供电
RS485_Bus2
BOOT0
NRST
SWD
Satellite Com
Servo
这里设计是用的板载IMU 如果需要用别的现成商用IMU再改接口
RS422
ADC
SD Card
STM32H7有软件反转UART电平功能，不需要反转SBUS电平
System Core
CAN1
步进电机其实也可以自己找驱动芯片，可能可以再缩小一些体积 但是选芯片和迭代也要一定时间，留着引脚后面有时间有必要再做了

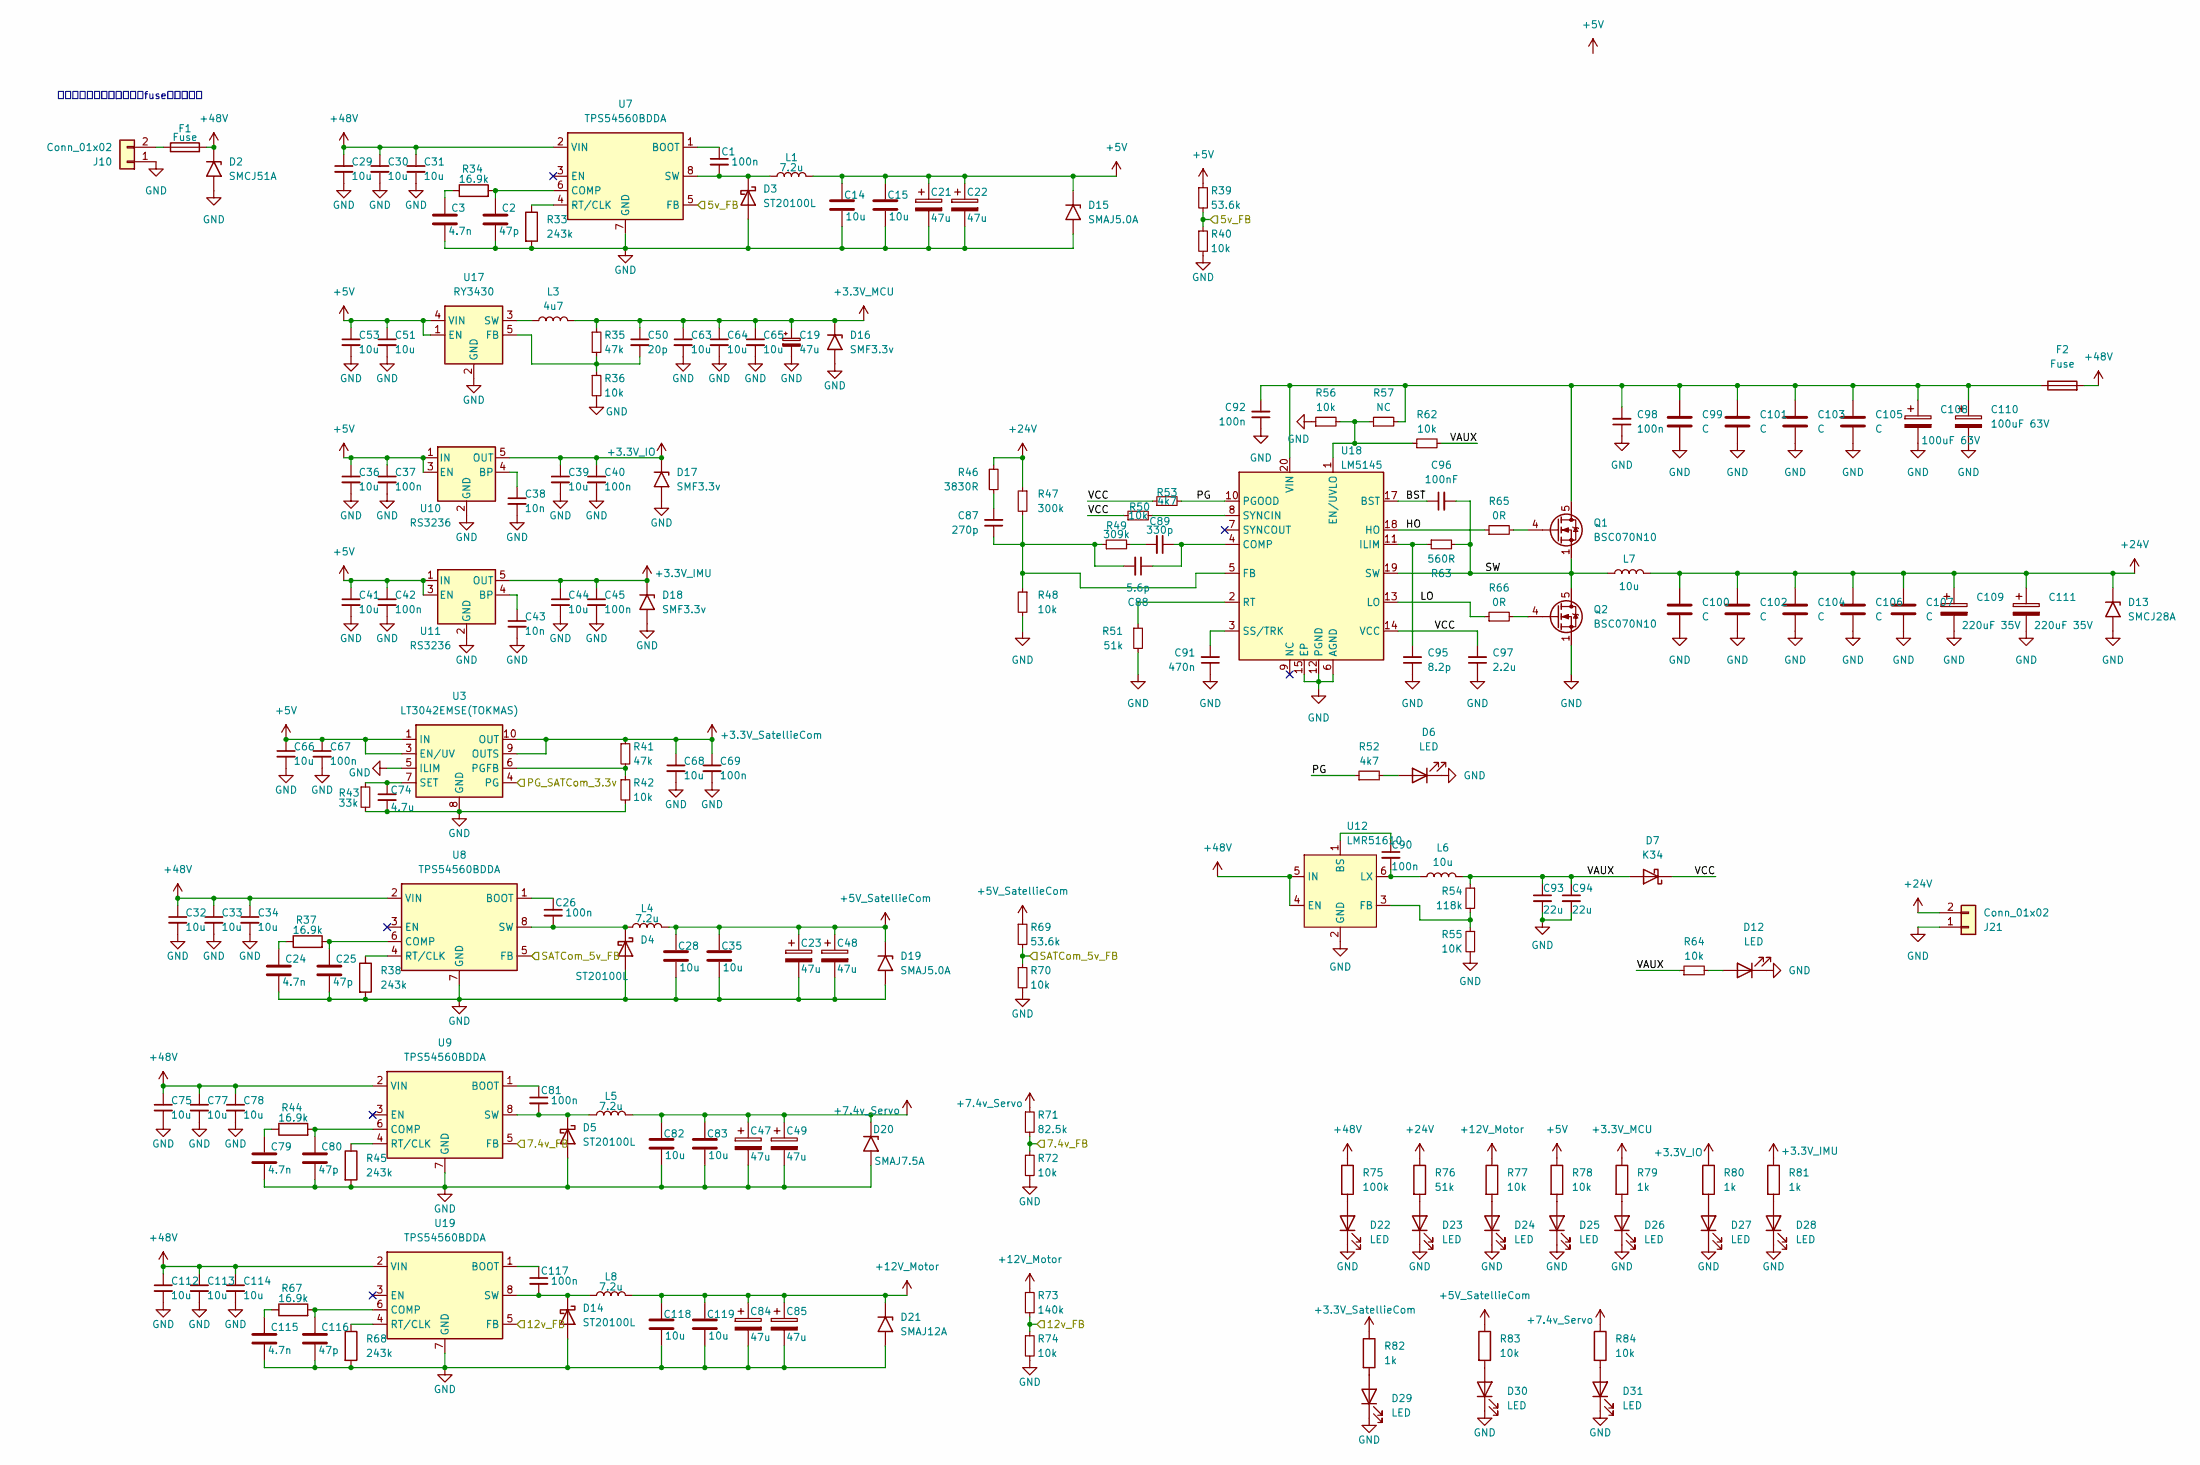
[picture p39: schematic Power.kicad_sch]

Parts:
C1, C26, C37, C40, C42, C45, C67, C69, C81, C90, C92, C98, C117: 100n; C_0603_1608Metric
C2, C25, C80, C116: 47p; C_0603_1608Metric
C3, C24, C79, C115: 4.7n; C_0603_1608Metric
C14, C15, C28, C29, C30, C31, C32, C33, C34, C35, C75, C77, C78, C82, C83, C112, C113, C114, C118, C119: 10u; C_1206_3216Metric
C19: 47u; CP_EIA-3216-18_Kemet-A_Pad1.58x1.35mm_HandSolder
C21, C22, C23, C47, C48, C49, C84, C85: 47u; CP_Radial_D6.3mm_P2.50mm
C36, C39, C41, C44, C51, C53, C63, C64, C65, C66, C68: 10u; C_0603_1608Metric
C38, C43: 10n; C_0603_1608Metric
C50: 20p; C_0603_1608Metric
C74: 4.7u; C_0603_1608Metric
C87: 270p; C_0603_1608Metric
C88: 5.6p; C_0603_1608Metric
C89: 330p; C_0603_1608Metric
C91: 470n; C_0603_1608Metric
C93, C94: 22u; C_0805_2012Metric
C95: 8.2p; C_0603_1608Metric
C96: 100nF; C_0603_1608Metric
C97: 2.2u; C_0603_1608Metric
C99, C101, C103, C105: C; C_1210_3225Metric
C100, C102, C104, C106, C107: C; C_1206_3216Metric
C108, C110: 100uF 63V; CP_Radial_D8.0mm_P3.50mm
C109, C111: 220uF 35V; CP_Radial_D8.0mm_P3.50mm
D2: SMCJ51A; D_SMC
D3, D4, D5, D14: ST20100L; D_PowerDI-5
D6, D12, D22, D23, D24, D25, D26, D27, D28, D29, D30, D31: LED; LED_0603_1608Metric
D7: K34; D_SMF
D13: SMCJ28A; D_SMC
D15, D19: SMAJ5.0A; D_SMA
D16, D17, D18: SMF3.3v; D_SMF
D20: SMAJ7.5A; D_SMA
D21: SMAJ12A; D_SMA
F1: Fuse; Fuseholder_Littelfuse_Nano2_157x
F2: Fuse; Fuse_Littelfuse-NANO2-451_453
J10: Conn_01x02; AMASS_XT60-M_1x02_P7.20mm_Vertical
J21: Conn_01x02; AMASS_XT30PW-F_1x02_P2.50mm_Horizontal
L1, L4, L5, L8: 7.2u; L_Sunlord_MWSA0603S
L3: 4u7; L_Sunlord_MWSA0402S
L6: 10u; L_Sunlord_MWSA0402S
L7: 10u; PQ2014_10uH
Q1, Q2: BSC070N10; TDSON-8-1
R33, R38, R45, R68: 243k; R_0603_1608Metric
R34, R37, R44, R67: 16.9k; R_0603_1608Metric
R35, R41: 47k; R_0603_1608Metric
R36, R40, R42, R48, R50, R56, R62, R64, R70, R72, R74, R77, R78, R83, R84: 10k; R_0603_1608Metric
R39, R69: 53.6k; R_0603_1608Metric
R43: 33k; R_0603_1608Metric
R46: 3830R; R_0603_1608Metric
R47: 300k; R_0603_1608Metric
R49: 309k; R_0603_1608Metric
R51, R76: 51k; R_0603_1608Metric
R52, R53: 4k7; R_0603_1608Metric
R54: 118k; R_0603_1608Metric
R55: 10K; R_0603_1608Metric
R57: NC; R_0603_1608Metric
R63: 560R; R_0603_1608Metric
R65, R66: 0R; R_0603_1608Metric
R71: 82.5k; R_0603_1608Metric
R73: 140k; R_0603_1608Metric
R75: 100k; R_0603_1608Metric
R79, R80, R81, R82: 1k; R_0603_1608Metric
U3: LT3042EMSE(TOKMAS); MSOP-10-1EP_3x3mm_P0.5mm_EP1.68x1.88mm
U7, U8, U9, U19: TPS54560BDDA; Texas_R-PDSO-G8_EP2.95x4.9mm_Mask2.4x3.1mm_ThermalVias
U10, U11: RS3236; SOT-23-5
U12: LMR51610; SOT-23-6
U17: RY3430; SOT-23-5
U18: LM5145; Texas_RGY_R-PVQFN-N20_EP2.05x3.05mm

Connections:
+3.3V_IMU: C44.1, C45.1, D18.1 (A1), R81.1, U11.5 (OUT); also elsewhere on the board
+3.3V_IO: C39.1, C40.1, D17.1 (A1), R80.1, U10.5 (OUT); also elsewhere on the board
+3.3V_MCU: C19.1, C50.1, C63.1, C64.1, C65.1, D16.1 (A1), L3.2, R35.1, R79.1; also elsewhere on the board
+3.3V_SatellieCom: C68.1, C69.1, R41.1, R82.1, U3.9 (OUTS), U3.10 (OUT); also elsewhere on the board
+5V: C14.1, C15.1, C21.1, C22.1, C36.1, C37.1, C41.1, C42.1, C51.1, C53.1, C66.1, C67.1, D15.1 (A1), L1.2, R39.1, R78.1, U3.1 (IN), U3.2 (IN), U3.3 (EN/UV), U10.1 (IN), U10.3 (EN), U11.1 (IN), U11.3 (EN), U17.1 (EN), U17.4 (VIN); also elsewhere on the board
+5V_SatellieCom: C23.1, C28.1, C35.1, C48.1, D19.1 (A1), L4.2, R69.1, R83.1; also elsewhere on the board
+7.4v_Servo: C47.1, C49.1, C82.1, C83.1, D20.1 (A1), L5.2, R71.1, R84.1; also elsewhere on the board
+12V_Motor: C84.1, C85.1, C118.1, C119.1, D21.1 (A1), L8.2, R73.1, R77.1; also elsewhere on the board
+24V: C100.1, C102.1, C104.1, C106.1, C107.1, C109.1, C111.1, D13.1 (A1), J21.2, L7.2, R46.1, R47.1, R76.1; also elsewhere on the board
+48V: C29.1, C30.1, C31.1, C32.1, C33.1, C34.1, C75.1, C77.1, C78.1, C112.1, C113.1, C114.1, D2.1 (A1), F1.2, F2.2, R75.1, U7.2 (VIN), U8.2 (VIN), U9.2 (VIN), U12.4 (EN), U12.5 (IN), U19.2 (VIN); also elsewhere on the board
/Power/5v_FB: R39.2, R40.1, U7.5 (FB)
/Power/7.4v_FB: R71.2, R72.1, U9.5 (FB)
/Power/12v_FB: R73.2, R74.1, U19.5 (FB)
/Power/BST: C96.1, U18.17 (BST)
/Power/HO: R65.1, U18.18 (HO)
/Power/LO: R66.1, U18.13 (LO)
/Power/PG: R52.1, R53.2, U18.10 (PGOOD)
/Power/PG_SATCom_3.3v: U3.4 (PG)
/Power/SATCom_5v_FB: R69.2, R70.1, U8.5 (FB)
/Power/SW: C96.2, L7.1, Q1.1 (S), Q1.2 (S), Q1.3 (S), Q2.5 (D), R63.2, U18.19 (SW)
/Power/VAUX: C93.1, C94.1, D7.2 (A), L6.2, R54.1, R62.2, R64.1
/Power/VCC: C97.2, D7.1 (K), R50.1, R53.1, U18.14 (VCC)
GND: C2.1, C3.1, C14.2, C15.2, C19.2, C21.2, C22.2, C23.2, C24.1, C25.1, C28.2, C29.2, C30.2, C31.2, C32.2, C33.2, C34.2, C35.2, C36.2, C37.2, C38.2, C39.2, C40.2, C41.2, C42.2, C43.2, C44.2, C45.2, C47.2, C48.2, C49.2, C51.2, C53.2, C63.2, C64.2, C65.2, C66.2, C67.2, C68.2, C69.2, C74.2, C75.2, C77.2, C78.2, C79.1, C80.1, C82.2, C83.2, C84.2, C85.2, C91.1, C92.1, C93.2, C94.2, C95.1, C97.1, C98.1, C99.2, C100.2, C101.2, C102.2, C103.2, C104.2, C105.2, C106.2, C107.2, C108.2, C109.2, C110.2, C111.2, C112.2, C113.2, C114.2, C115.1, C116.1, C118.2, C119.2, D2.2 (A2), D3.2 (A), D4.2 (A), D5.2 (A), D6.1 (K), D12.1 (K), D13.2 (A2), D14.2 (A), D15.2 (A2), D16.2 (A2), D17.2 (A2), D18.2 (A2), D19.2 (A2), D20.2 (A2), D21.2 (A2), D22.1 (K), D23.1 (K), D24.1 (K), D25.1 (K), D26.1 (K), D27.1 (K), D28.1 (K), D29.1 (K), D30.1 (K), D31.1 (K), J10.1, J21.1, Q2.1 (S), Q2.2 (S), Q2.3 (S), R33.2, R36.2, R38.2, R40.2, R42.2, R43.2, R45.2, R48.2, R51.2, R55.2, R56.1, R68.2, R70.2, R72.2, R74.2, U3.5 (ILIM), U3.8 (GND), U3.11 (GND), U7.7 (GND), U7.9 (GND), U8.7 (GND), U8.9 (GND), U9.7 (GND), U9.9 (GND), U10.2 (GND), U11.2 (GND), U12.2 (GND), U17.2 (GND), U18.6 (AGND), U18.12 (PGND), U18.15 (EP), U18.21 (EP), U19.7 (GND), U19.9 (GND); also elsewhere on the board
unnamed: C3.2, R34.1
unnamed: C24.2, R37.1
unnamed: C79.2, R44.1
unnamed: C87.2, R46.2
unnamed: C89.2, R49.2
unnamed: C115.2, R67.1
unnamed: C1.2, D3.1 (K), L1.1, U7.8 (SW)
unnamed: C26.2, D4.1 (K), L4.1, U8.8 (SW)
unnamed: C81.2, D5.1 (K), L5.1, U9.8 (SW)
unnamed: D6.2 (A), R52.2
unnamed: D12.2 (A), R64.2
unnamed: C117.2, D14.1 (K), L8.1, U19.8 (SW)
unnamed: D22.2 (A), R75.2
unnamed: D23.2 (A), R76.2
unnamed: D24.2 (A), R77.2
unnamed: D25.2 (A), R78.2
unnamed: D26.2 (A), R79.2
unnamed: D27.2 (A), R80.2
unnamed: D28.2 (A), R81.2
unnamed: D29.2 (A), R82.2
unnamed: D30.2 (A), R83.2
unnamed: D31.2 (A), R84.2
unnamed: F1.1, J10.2
unnamed: C92.2, C98.2, C99.1, C101.1, C103.1, C105.1, C108.1, C110.1, F2.1, Q1.5 (D), R57.2, U18.20 (VIN)
unnamed: Q1.4 (G), R65.2
unnamed: Q2.4 (G), R66.2
unnamed: R41.2, R42.1, U3.6 (PGFB)
unnamed: C74.1, R43.1, U3.7 (SET)
unnamed: C1.1, U7.1 (BOOT)
unnamed: C2.2, R34.2, U7.6 (COMP)
unnamed: R33.1, U7.4 (RT/CLK)
unnamed: C26.1, U8.1 (BOOT)
unnamed: C25.2, R37.2, U8.6 (COMP)
unnamed: R38.1, U8.4 (RT/CLK)
unnamed: C81.1, U9.1 (BOOT)
unnamed: C80.2, R44.2, U9.6 (COMP)
unnamed: R45.1, U9.4 (RT/CLK)
unnamed: C38.1, U10.4 (BP)
unnamed: C43.1, U11.4 (BP)
unnamed: C90.1, U12.1 (BS)
unnamed: R54.2, R55.1, U12.3 (FB)
unnamed: C90.2, L6.1, U12.6 (LX)
unnamed: C50.2, R35.2, R36.1, U17.5 (FB)
unnamed: L3.1, U17.3 (SW)
unnamed: C88.1, C89.1, U18.4 (COMP)
unnamed: R56.2, R57.1, R62.1, U18.1 (EN/UVLO)
unnamed: C87.1, C88.2, R47.2, R48.1, R49.1, U18.5 (FB)
unnamed: C95.2, R63.1, U18.11 (ILIM)
unnamed: R51.1, U18.2 (RT)
unnamed: C91.2, U18.3 (SS/TRK)
unnamed: R50.2, U18.8 (SYNCIN)
unnamed: C117.1, U19.1 (BOOT)
unnamed: C116.2, R67.2, U19.6 (COMP)
unnamed: R68.1, U19.4 (RT/CLK)

Notes on the sheet:
可能要出来的线上或者板子fuse后加个开关

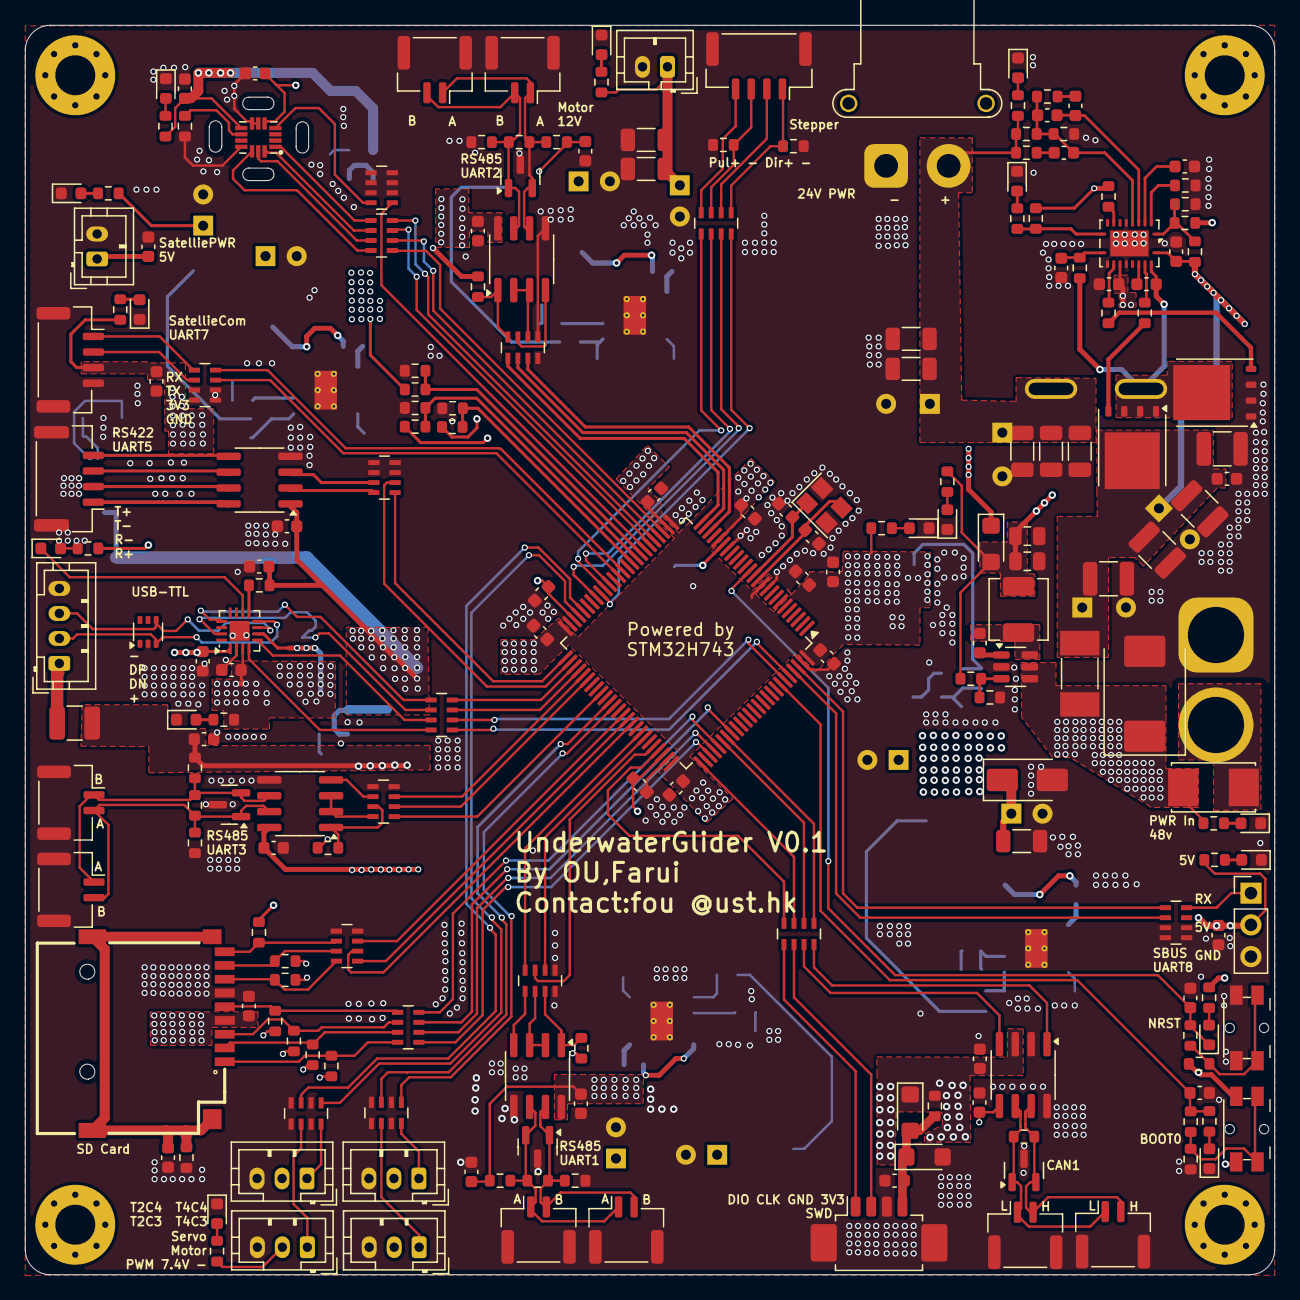
[picture p40: board UnderwaterGlider.kicad_pcb from above]

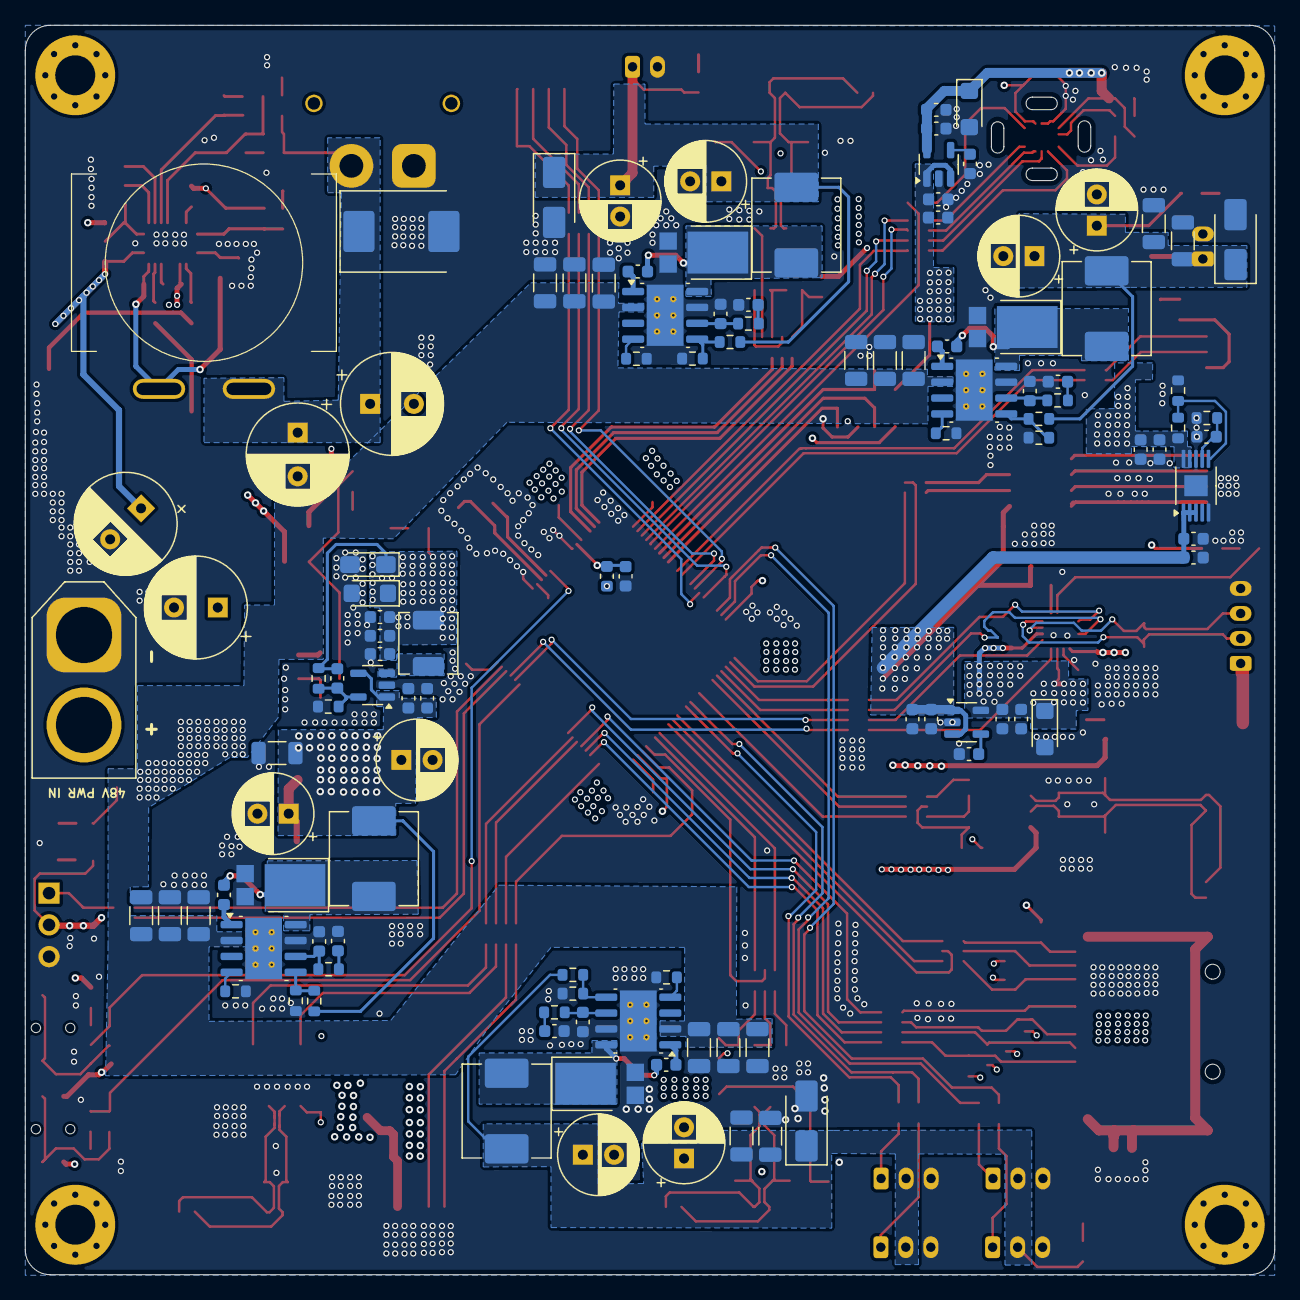
[picture p41: board UnderwaterGlider.kicad_pcb from below]

Board: 4 copper layers, 100.0 x 100.0 mm, 320 parts (112 on the bottom side), 195 nets.
