Frrrrrrrrrank/Underwater-Glider/software/Core/Src/main.c

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
/* Includes ------------------------------------------------------------------*/
#include "main.h"
#include "cmsis_os.h"
#include "fatfs.h"

/* USER CODE BEGIN Includes */
#include "glider_core.h"
#include "glider_rdss_codec.h"
#include "imu_core.h"
#include "rudder_driver.h"
#include "motor_driver.h"
#include "worm_axis.h"
#include "pump_driver.h"
#include "displacement_sensor.h"
#include "pressure_sensor_driver.h"
#include "sbus_driver.h"
#include "stepper_driver.h"
#include "buzzer_driver.h"
#include "ethernet_uart_driver.h"
#include "limit_switch.h"
#include "FreeRTOS.h"
#include "task.h"
#include "ekf_task.h"//EKF相关头文件声明
#include "ekf_bridge.h"
#include "pid_control_service.h"
#include "glider_time.h"
#include "disk_driver.h"
#include "thruster_driver.h"
#include "sd_log_task.h"//SD 卡日志任务，每分钟落盘系统快照
#include "battery_monitor.h"
#include "battery_task.h"

/* USER CODE END Includes */

/* USER CODE BEGIN PTD */

typedef struct
{
  uint32_t boot_stage;            /* Boot marker from main() */
  uint32_t alive_counter;         /* defaultTask loop counter */
  uint32_t rtos_tick;             /* osKernelGetTickCount() snapshot */
  uint32_t rx_line_count;         /* Decoded RX line counter */
  uint32_t rx_overflow_count;     /* RX ring overflow counter */
  uint32_t tx_attempt_count;      /* UART TX attempts */
  uint32_t tx_ok_count;           /* UART TX success count */
  uint32_t tx_fail_count;         /* UART TX fail count */
  uint32_t tx_last_status;        /* Last HAL_UART_Transmit status */
  uint32_t tx_last_uart_error;    /* Last UART error code */
  char last_tx_text[32];          /* Last transmitted command text */
  char card_id[24];               /* Stored card id used by TESTTC send */
  uint32_t card_id_known;         /* 1 when card id was parsed/queried */
  uint32_t shortmsg_sent_count;   /* Number of sent coordinate short messages */
  char last_shortmsg_payload[96]; /* Last sent coordinate payload */
  uint32_t last_rx_update_count;  /* Incremented on each new RX callback update */
  uint32_t last_rx_text_len;      /* Length of last text frame */
  char last_rx_text[512];         /* Last text frame (null-terminated) */
  uint32_t last_rx_bin_len;       /* Length of last binary frame */
  uint8_t last_rx_bin[64];        /* Last binary frame bytes */
  uint32_t is_rd_mode;            /* 1 when last decoded text is RD Mode! */
  uint32_t is_bdpwi;              /* 1 when last decoded sentence is BDPWI */
  char bdpwi_utc[16];             /* BDPWI UTC field string */
  uint32_t bdpwi_field1;          /* BDPWI Field[2], compatibility mirror */
  uint32_t bdpwi_field2;          /* BDPWI Field[3], compatibility mirror */
  uint32_t bdpwi_field1_valid;    /* BDPWI Field[2] numeric-valid flag */
  uint32_t bdpwi_field2_valid;    /* BDPWI Field[3] numeric-valid flag */
  char bdpwi_latitude_raw[16];    /* BDPWI Field[4] raw text */
  char bdpwi_longitude_raw[16];   /* BDPWI Field[5] raw text */
  char bdpwi_heading_raw[16];     /* BDPWI Field[6] raw text */
  int32_t bdpwi_latitude_x100;    /* BDPWI Field[4] fixed-point x100 */
  int32_t bdpwi_longitude_x100;   /* BDPWI Field[5] fixed-point x100 */
  int32_t bdpwi_heading_x100;     /* BDPWI Field[6] fixed-point x100 */
  uint32_t bdpwi_latitude_valid;  /* BDPWI Field[4] decimal-valid flag */
  uint32_t bdpwi_longitude_valid; /* BDPWI Field[5] decimal-valid flag */
  uint32_t bdpwi_heading_valid;   /* BDPWI Field[6] decimal-valid flag */
  char bdpwi_latitude_dm[20];     /* Located BDPWI latitude candidate */
  char bdpwi_latitude_ns[4];      /* Located BDPWI latitude direction */
  char bdpwi_longitude_dm[20];    /* Located BDPWI longitude candidate */
  char bdpwi_longitude_ew[4];     /* Located BDPWI longitude direction */
  int32_t bdpwi_latitude_deg_e7;  /* Converted BDPWI latitude * 1e7 */
  int32_t bdpwi_longitude_deg_e7; /* Converted BDPWI longitude * 1e7 */
  float bdpwi_latitude_deg;       /* Map-ready BDPWI latitude */
  float bdpwi_longitude_deg;      /* Map-ready BDPWI longitude */
  uint32_t bdpwi_latitude_deg_valid;  /* Located latitude conversion valid */
  uint32_t bdpwi_longitude_deg_valid; /* Located longitude conversion valid */
  uint32_t bdpwi_old_beam_count;  /* Old-system locked beam count */
  uint32_t bdpwi_new_beam_count;  /* New-system locked beam count */
  uint32_t bdpwi_best_d_cnr;      /* Best D-branch CNR */
  uint32_t bdpwi_best_p_cnr;      /* Best P-branch CNR */
  uint32_t bdpwi_good_beam_count; /* Count of good beams */
  uint32_t rd_signal_good;        /* 1 when signal is good enough */
  uint32_t tx_mode;               /* 0 signal poll, 1 position test */
  uint32_t is_gnrmc;              /* 1 when last decoded sentence is GNRMC */
  char gnrmc_utc[16];             /* GNRMC UTC */
  char gnrmc_status[4];           /* GNRMC A/V */
  char gnrmc_date[16];            /* GNRMC date */
  char gnrmc_latitude_dm[20];     /* GNRMC raw latitude */
  char gnrmc_latitude_ns[4];      /* GNRMC latitude direction */
  char gnrmc_longitude_dm[20];    /* GNRMC raw longitude */
  char gnrmc_longitude_ew[4];     /* GNRMC longitude direction */
  int32_t gnrmc_latitude_deg_e7;  /* GNRMC latitude * 1e7 */
  int32_t gnrmc_longitude_deg_e7; /* GNRMC longitude * 1e7 */
  float gnrmc_latitude_deg;       /* GNRMC decimal latitude */
  float gnrmc_longitude_deg;      /* GNRMC decimal longitude */
  uint32_t gnrmc_status_valid;    /* 1 when status is A */
  uint32_t gnrmc_latitude_valid;  /* 1 when latitude is valid */
  uint32_t gnrmc_longitude_valid; /* 1 when longitude is valid */
  uint32_t is_bdepi;              /* 1 when last decoded sentence is BDEPI */
  char bdepi_sender_card[24];     /* BDEPI Field[1] */
  char bdepi_receiver_card[24];   /* BDEPI Field[2] */
  char bdepi_utc[16];             /* BDEPI Field[6] */
  uint32_t bdepi_freq_code;       /* BDEPI Field[3] */
  uint32_t bdepi_emergency_code;  /* BDEPI Field[4] */
  uint32_t bdepi_report_mode;     /* BDEPI Field[5] */
  uint32_t bdepi_freq_valid;      /* BDEPI Field[3] numeric-valid */
  uint32_t bdepi_emergency_valid; /* BDEPI Field[4] numeric-valid */
  uint32_t bdepi_report_mode_valid; /* BDEPI Field[5] numeric-valid */
  char bdepi_longitude_dm[20];    /* BDEPI Field[7] raw dddmm.mmmmmm */
  char bdepi_longitude_ew[4];     /* BDEPI Field[8] */
  char bdepi_latitude_dm[20];     /* BDEPI Field[9] raw ddmm.mmmmmm */
  char bdepi_latitude_ns[4];      /* BDEPI Field[10] */
  int32_t bdepi_longitude_deg_e7; /* Converted decimal degree * 1e7 */
  int32_t bdepi_latitude_deg_e7;  /* Converted decimal degree * 1e7 */
  float bdepi_longitude_deg;      /* Map-ready longitude as decimal degree */
  float bdepi_latitude_deg;       /* Map-ready latitude as decimal degree */
  uint32_t bdepi_longitude_valid; /* BDEPI longitude conversion valid */
  uint32_t bdepi_latitude_valid;  /* BDEPI latitude conversion valid */
  char bdepi_altitude_raw[16];    /* BDEPI Field[11] raw altitude */
  int32_t bdepi_altitude_x100;    /* BDEPI altitude * 100 */
  uint32_t bdepi_altitude_valid;  /* BDEPI altitude conversion valid */
  char bdepi_altitude_unit[4];    /* BDEPI Field[12] */
  char bdepi_altitude_abnormal[8]; /* BDEPI Field[13] */
  char bdepi_altitude_abn_unit[4]; /* BDEPI Field[14] */
  char bdepi_precision_indicator[8]; /* BDEPI Field[15] */
  char bdepi_multi_solution[8];   /* BDEPI Field[16] */
  char bdepi_rescue_subtype[8];   /* BDEPI Field[17] */
  char bdepi_rescue_center_type[8]; /* BDEPI Field[18] */
  uint32_t bdepi_data_len;        /* BDEPI Field[19] */
  uint32_t bdepi_data_len_valid;  /* BDEPI Field[19] numeric-valid */
  char bdepi_data_payload[48];    /* BDEPI Field[20] */
} GliderDebugView;

typedef struct
{
  uint32_t frame_count;           /* Total IMU frames received */
  uint32_t crc_error_count;       /* CRC checksum failures */
  uint32_t rx_overflow_count;     /* Ring buffer overflow count */
  uint32_t rx_irq_count;          /* IMU UART RX callback count */
  uint32_t rx_byte_count;         /* Raw received byte count */
  uint32_t rx_poll_byte_count;    /* Bytes captured by polling fallback */
  uint32_t rx_rearm_ok_count;     /* RX IT re-arm successful count */
  uint32_t rx_rearm_fail_count;   /* RX IT re-arm failed count */
  uint32_t rx_init_status;        /* Initial RX IT arm status */
  uint32_t uart4_irq_count;       /* IMU UART IRQ entry count; legacy watch name */
  uint32_t uart4_error_count;     /* IMU UART HAL error callback count; legacy watch name */
  uint32_t uart4_last_error;      /* IMU UART last HAL error code; legacy watch name */
  uint32_t uart_rxne_flag;        /* Current RXNE flag state (1=data ready, 0=no data) */
  uint32_t uart_error_flags;      /* Current error flags (bit0=ORE, bit1=NE, bit2=FE, bit3=PE) */
  uint32_t recent_rx_len;         /* Number of valid bytes in recent_rx_bytes */
  uint8_t recent_rx_bytes[16];    /* Recent raw bytes from IMU RX stream */
  uint32_t task_loop_count;       /* IMU task loop count */
  uint32_t last_function_code;    /* Last received function code (0x40, 0x41, etc) */
  uint32_t last_rx_function;      /* Return-state frame field[0] */
  int32_t last_rx_state;          /* Return-state frame field[1] */
  //Ozone调试变量,用于看IMU设置的频率
  uint32_t freq_set_attempt_count;/* 输出频率设置命令的发送尝试次数 */
  uint32_t freq_set_success_count;/* 输出频率设置命令的串口发送成功次数 */
  uint32_t freq_set_last_status;  /* 最近一次发送频率命令的 HAL 状态 */
  uint32_t requested_output_hz;   /* 最近一次请求设置的输出频率，单位 Hz */
  uint32_t version_request_attempt_count; /* 固件版本查询命令的发送次数 */
  uint32_t version_request_last_status;   /* 最近一次版本查询的 HAL 状态 */
  
  /* Raw 9-axis data */
  float ax, ay, az;               /* Accelerometer (m/s²) */
  float gx, gy, gz;               /* Gyroscope (rad/s) */
  float mx, my, mz;               /* Magnetometer (µT) */
  uint32_t raw_updated;           /* Flag: raw data was updated */
  
  /* Euler angles */
  float roll, pitch, yaw;         /* Degrees */
  uint32_t euler_updated;         /* Flag: euler data was updated */
  
  /* Quaternion */
  float q0, q1, q2, q3;
  uint32_t quat_updated;          /* Flag: quaternion data was updated */
  
  /* Barometer */
  float height, temperature;
  float pressure, pressure_contrast;
  uint32_t baro_updated;          /* Flag: baro data was updated */
  
  /* Version */
  uint8_t version_high;
  uint8_t version_mid;
  uint8_t version_low;
  uint32_t version_known;         /* 1 表示已经收到固件版本返回帧 */
} IMUDebugView;

typedef struct
{
  uint32_t update_count;          /* Increments on each decoded line */
  uint32_t frame_type;            /* GliderRdssFrameType */
  uint32_t checksum_valid;        /* 1 if checksum passed or absent */
  uint32_t is_bdpwi;              /* 1 if BDPWI */
  uint32_t is_bdepi;              /* 1 if BDEPI */
  uint32_t is_gnrmc;              /* 1 if GNRMC */
  char sentence[24];              /* Sentence id */
  char utc[16];                   /* UTC string from decoded frame */
  uint32_t mode_code;             /* BDPWI field1 or BDEPI report_mode */
  uint32_t status_code;           /* BDPWI field2 or BDEPI emergency */
  float longitude_deg;            /* Map-ready when available */
  float latitude_deg;             /* Map-ready when available */
  uint32_t position_valid;        /* 1 if longitude/latitude are valid */
  uint32_t signal_good;           /* 1 if BDPWI signal is good */
  uint32_t tx_mode;               /* 0 signal poll, 1 position test */
  uint32_t card_id_known;         /* 1 when local card id is known */
  uint32_t card_mismatch;         /* 1 when queried local card changed */
  uint32_t has_cached_fix;        /* 1 when last valid RN/GNRMC is cached */
  uint32_t shortmsg_pending;      /* 1 when payload queued for send */
  uint32_t ready_to_send;         /* 1 when all last-send conditions are met */
  char local_card_id[24];         /* Local queried card id */
  char target_card_id[24];        /* Destination platform card id */
  char last_tx_text[32];          /* Last transmitted command text */
  char last_text[96];             /* Last text line snapshot */
} GliderDebugQuickView;

/* USER CODE END PTD */

ADC_HandleTypeDef hadc1;

FDCAN_HandleTypeDef hfdcan1;

I2C_HandleTypeDef hi2c2;

UART_HandleTypeDef hlpuart1;
UART_HandleTypeDef huart4;
UART_HandleTypeDef huart5;
UART_HandleTypeDef huart7;
UART_HandleTypeDef huart8;
UART_HandleTypeDef huart1;
UART_HandleTypeDef huart2;
UART_HandleTypeDef huart3;

SD_HandleTypeDef hsd1;

SPI_HandleTypeDef hspi1;
SPI_HandleTypeDef hspi2;

TIM_HandleTypeDef htim1;
TIM_HandleTypeDef htim2;
TIM_HandleTypeDef htim4;
TIM_HandleTypeDef htim15;

MDMA_HandleTypeDef hmdma_mdma_channel0_sdmmc1_end_data_0;
/* Definitions for defaultTask */
osThreadId_t defaultTaskHandle;
const osThreadAttr_t defaultTask_attributes = {
  .name = "defaultTask",
  .stack_size = 128 * 4,
  .priority = (osPriority_t) osPriorityNormal,
};
/* Definitions for uart7RxTask */
osThreadId_t uart7RxTaskHandle;
const osThreadAttr_t uart7RxTask_attributes = {
  .name = "uart7RxTask",
  .stack_size = 512 * 4,
  .priority = (osPriority_t) osPriorityNormal1,
};
/* Definitions for uartTxTask */
osThreadId_t uartTxTaskHandle;
const osThreadAttr_t uartTxTask_attributes = {
  .name = "uartTxTask",
  .stack_size = 256 * 4,
  .priority = (osPriority_t) osPriorityBelowNormal7,
};
/* Definitions for imuRxTask */
osThreadId_t imuRxTaskHandle;
const osThreadAttr_t imuRxTask_attributes = {
  .name = "imuRxTask",
  .stack_size = 256 * 4,
  .priority = (osPriority_t) osPriorityNormal2,
};
/* Definitions for servoTask */
osThreadId_t servoTaskHandle;
const osThreadAttr_t servoTask_attributes = {
  .name = "servoTask",
  /* PID 参数解码最深静态调用链约 1000B；2KB 留出异常/浮点上下文余量。 */
  .stack_size = 512 * 4,
  .priority = (osPriority_t) osPriorityNormal3,
};
/* Definitions for Usart3Task */
osThreadId_t Usart3TaskHandle;
const osThreadAttr_t Usart3Task_attributes = {
  .name = "Usart3Task",
  .stack_size = 512 * 4,
  .priority = (osPriority_t) osPriorityNormal1,
};
/* Definitions for Usart2Task */
osThreadId_t Usart2TaskHandle;
const osThreadAttr_t Usart2Task_attributes = {
  .name = "Usart2Task",
  .stack_size = 512 * 4,
  .priority = (osPriority_t) osPriorityNormal3,
};
/* USER CODE BEGIN PV */
/* 电池采样独占 ADC1，低于控制/通信任务，不在控制循环中等待转换。 */
osThreadId_t batteryTaskHandle;
const osThreadAttr_t batteryTask_attributes = {
  .name = "batteryTask",
  .stack_size = 512 * 4,
  .priority = (osPriority_t) osPriorityBelowNormal,
};
/* EKF 任务句柄与属性，单一所有者，仅此任务访问滤波器单例 g_ekf */
osThreadId_t ekfTaskHandle;
const osThreadAttr_t ekfTask_attributes = {
  .name = "ekfTask",
  /* 栈 16KB（4096 B ×4），上板后看 g_ekf_stack_high_water_words 再收敛 */
  .stack_size = 4096 * 4,
  /* 优先级与 IMU 同级，低于舵机任务 */
  .priority = (osPriority_t) osPriorityNormal2,
};
osThreadId_t EthernetTaskHandle;
const osThreadAttr_t EthernetTask_attributes = {
  .name = "EthernetTask",
  .stack_size = 512 * 4,
  .priority = (osPriority_t) osPriorityNormal3,
};
/* SD 卡日志任务：每分钟把系统快照追加写入 armfly.txt，优先级最低不抢占控制 */
osThreadId_t sdLogTaskHandle;
const osThreadAttr_t sdLogTask_attributes = {
  .name = "sdLogTask",
  .stack_size = 512 * 4,
  .priority = (osPriority_t) osPriorityLow,
};
volatile uint32_t g_dbg_alive_counter = 0U;
volatile uint32_t g_dbg_rtos_tick = 0U;
volatile uint32_t g_dbg_rx_line_count = 0U;
volatile uint32_t g_dbg_rx_overflow_count = 0U;
volatile uint32_t g_dbg_default_task_tick = 0U;
volatile uint32_t g_dbg_boot_stage = 0U;
volatile uint32_t g_dbg_systick_count = 0U;
volatile uint32_t g_dbg_fault_code = 0U;
volatile uint32_t g_dbg_fault_count = 0U;
volatile uint32_t g_dbg_assert_count = 0U;
volatile uint32_t g_dbg_assert_line = 0U;
volatile uint32_t g_dbg_rtos_hook_code = 0U;
volatile uint32_t g_dbg_tx_attempt_count = 0U;
volatile uint32_t g_dbg_tx_ok_count = 0U;
volatile uint32_t g_dbg_tx_fail_count = 0U;
volatile uint32_t g_dbg_tx_last_status = 0U;
volatile uint32_t g_dbg_tx_last_uart_error = 0U;
volatile uint32_t g_dbg_signal_good = 0U;
volatile uint32_t g_dbg_tx_mode = 0U;
volatile char g_dbg_last_tx_text[32] = {0};
volatile char g_dbg_card_id[24] = {0};
volatile uint32_t g_dbg_card_id_known = 0U;
volatile uint32_t g_dbg_shortmsg_sent_count = 0U;
volatile char g_dbg_last_shortmsg_payload[96] = {0};
volatile uint32_t g_dbg_last_rx_text_len = 0U;
volatile char g_dbg_last_rx_text[192] = {0};
volatile uint32_t g_dbg_last_rx_bin_len = 0U;
volatile uint8_t g_dbg_last_rx_bin[64] = {0};
volatile uint32_t g_dbg_last_rx_update_count = 0U;
volatile uint32_t g_dbg_is_rd_mode = 0U;
volatile uint32_t g_dbg_is_bdpwi = 0U;
volatile char g_dbg_bdpwi_utc[16] = {0};
volatile uint32_t g_dbg_bdpwi_field1 = 0U;
volatile uint32_t g_dbg_bdpwi_field2 = 0U;
volatile uint32_t g_dbg_bdpwi_field1_valid = 0U;
volatile uint32_t g_dbg_bdpwi_field2_valid = 0U;
volatile uint32_t g_dbg_uart4_irq_count = 0U;  /* Legacy watch name; now tracks UART5 IMU IRQ. */
volatile uint32_t g_dbg_uart3_irq_count = 0U;
volatile uint32_t g_dbg_uart3_rxne_count = 0U;
volatile uint32_t g_dbg_uart4_error_count = 0U;  /* Legacy watch name; now tracks UART5 IMU errors. */
volatile uint32_t g_dbg_uart4_last_error = 0U;   /* Legacy watch name; now tracks UART5 IMU errors. */
volatile uint32_t g_dbg_uart3_error_count = 0U;
volatile uint32_t g_dbg_uart3_last_error = 0U;
volatile uint32_t g_dbg_imu_task_loop_count = 0U;
volatile uint32_t g_dbg_servo_start_ok = 0U;
volatile uint32_t g_dbg_servo_step_count = 0U;
volatile uint32_t g_dbg_servo_pulse_us = 1500U;
volatile uint32_t g_rc_ctrl_mode = 0U;
volatile uint32_t g_rc_ctrl_off_reason = 0U;
/* pitch 安装转换后的驱动请求，与原始反馈同方向；仍可能被驱动层限位阻挡。 */
volatile int32_t g_rc_worm_cmd_rpm = 0;
volatile int32_t g_rc_stepper_cmd_rpm = 0;
volatile uint16_t g_rc_sw_left_outer = 0U;
volatile uint16_t g_rc_sw_left_mid_1 = 0U;
volatile uint16_t g_rc_sw_left_mid_2 = 0U;
volatile uint16_t g_rc_sw_right_outer = 0U;
volatile uint16_t g_rc_left_stick_y = SBUS_VALUE_CENTER_OBSERVED;
volatile uint16_t g_rc_left_stick_x = SBUS_VALUE_CENTER_OBSERVED;
volatile uint16_t g_rc_right_stick_y = SBUS_VALUE_CENTER_OBSERVED;
volatile uint8_t g_limit_switch_states[LIMIT_SWITCH_COUNT] = {1U, 1U, 1U, 1U};
volatile uint32_t g_limit_switch_update_count = 0U;
volatile GliderDebugView g_dbg_view = {0};
volatile GliderDebugQuickView g_dbg_quick = {0};
volatile IMUDebugView g_imu_debug = {0};

/* USER CODE END PV */

void SystemClock_Config(void);
static void MPU_Config(void);
static void MX_GPIO_Init(void);
static void MX_MDMA_Init(void);
static void MX_FDCAN1_Init(void);
static void MX_SDMMC1_SD_Init(void);
static void MX_UART4_Init(void);
static void MX_USART1_UART_Init(void);
static void MX_USART2_UART_Init(void);
static void MX_USART3_UART_Init(void);
static void MX_UART5_Init(void);
static void MX_UART7_Init(void);
static void MX_UART8_Init(void);
static void MX_ADC1_Init(void);
static void MX_SPI1_Init(void);
static void MX_TIM1_Init(void);
static void MX_TIM2_Init(void);
static void MX_TIM4_Init(void);
static void MX_I2C2_Init(void);
static void MX_LPUART1_UART_Init(void);
static void MX_SPI2_Init(void);
static void MX_TIM15_Init(void);
void StartDefaultTask(void *argument);
void StartUartRxTask(void *argument);
void StartUartTxTask(void *argument);
void Start_IMU_Task(void *argument);
void StartServoTask(void *argument);
void StartUsart3Task(void *argument);
void StartUsart2Task(void *argument);

/* USER CODE BEGIN 0 */

#define RC_SWITCH_UP_THRESHOLD     640U
#define RC_SWITCH_DOWN_THRESHOLD   1400U
#define RC_STICK_DEADBAND          40U
#define RC_CONTROL_PERIOD_MS       20U  //ServoTask，也即PID 控制周期，20ms 对应 50Hz
#define RC_FRAME_TIMEOUT_MS        150U

#define RC_WORM_MOTOR_NODE_ID      0x01U
/* g_umotor 默认槽位 0x01~0x04 对应 slot 0~3；node_id 0x01 对应 slot 0 */
#define RC_WORM_MOTOR_SLOT         0U
#define RC_WORM_MOTOR_MAX_RPM      600U
#define RC_STEPPER_MAX_RPM         800U

#define RC_OFF_REASON_NONE                 0U
#define RC_OFF_REASON_FRAME_TIMEOUT        1U
#define RC_OFF_REASON_FAILSAFE_OR_LOST     2U
#define RC_OFF_REASON_ALL_SWITCH_UP        3U
#define RC_OFF_REASON_MODE_SWITCH_NOT_MID  4U
#define RC_OFF_REASON_PID_FAULT_BASE        100U

typedef enum
{
  RC_CTRL_MODE_OFF = 0U,
  RC_CTRL_MODE_OPEN_LOOP_SPEED = 1U,
  RC_CTRL_MODE_ETH = 2U,
  RC_CTRL_MODE_PID_ETH = 3U,
  RC_CTRL_MODE_WORM_HOMING = 4U /* 保留诊断编号：双轴校准接管，泵/推进保持零 */
} RcControlMode;

static uint32_t RcControl_IsSwitchUp(uint16_t raw)
{
  return (raw < RC_SWITCH_UP_THRESHOLD) ? 1U : 0U;
}

static uint32_t RcControl_IsSwitchMid(uint16_t raw)
{
  return ((raw >= RC_SWITCH_UP_THRESHOLD) && (raw <= RC_SWITCH_DOWN_THRESHOLD)) ? 1U : 0U;
}

static int32_t RcControl_ClampSigned(int32_t value, int32_t limit)
{
  if (limit < 0)
  {
    limit = -limit;
  }

  if (value > limit)
  {
    return limit;
  }

  if (value < -limit)
  {
    return -limit;
  }

  return value;
}

/* Map SBUS stick raw value to signed RPM with a deadband around center. */
static int32_t RcControl_MapStickToSignedRpm(uint16_t raw, uint16_t max_rpm)
{
  const uint32_t center = SBUS_VALUE_CENTER_OBSERVED;
  const uint32_t min_v = SBUS_VALUE_MIN_OBSERVED;
  const uint32_t max_v = SBUS_VALUE_MAX_OBSERVED;
  const uint32_t threshold_high = center + RC_STICK_DEADBAND;
  const uint32_t threshold_low = center - RC_STICK_DEADBAND;
  int32_t signed_rpm = 0;

  if (max_rpm == 0U)
  {
    return 0;
  }

  if ((uint32_t)raw > threshold_high)
  {
    const uint32_t num = (uint32_t)raw - threshold_high;
    const uint32_t den = max_v - threshold_high;
    if (den != 0U)
    {
      signed_rpm = (int32_t)((num * (uint32_t)max_rpm) / den);
    }
  }
  else if ((uint32_t)raw < threshold_low)
  {
    const uint32_t num = threshold_low - (uint32_t)raw;
    const uint32_t den = threshold_low - min_v;
    if (den != 0U)
    {
      signed_rpm = -(int32_t)((num * (uint32_t)max_rpm) / den);
    }
  }

  return RcControl_ClampSigned(signed_rpm, (int32_t)max_rpm);
}

/* 校准终态只接受新收到的全中立命令，不能恢复校准前缓存的运动目标。 */
static uint8_t RcControl_IsEthernetNeutral(const EthernetUartReadoutPack *pack)
{
  return (pack->pitchmotor_speed_rpm == 0 && pack->rollmotor_speed_rpm == 0 &&
          pack->thrustmotor1se_speed_rpm == 0U && pack->thrustmotor2se_speed_rpm == 0U &&
          pack->pump_on_off == 0U && pack->rudder_angle_cdeg == 0) ? 1U : 0U;
}

/* 只在本任务应用校准动作。KEEP 不写连续速度，否则会撤销释放沿停止或定步回中。 */
static uint8_t RcControl_ApplyCalibrationRoll(const WormCalibrationOutput *out)
{
  StepperState state;
  uint8_t accepted;
  switch (out->roll_action)
  {
    case WORM_ROLL_ACTION_STOP:
      Stepper_DisarmReleaseStop();
      Stepper_SetContinuousSignedRpm(0);
      return 1U;
    case WORM_ROLL_ACTION_CONTINUOUS:
      Stepper_DisarmReleaseStop();
      Stepper_SetContinuousSignedRpm(out->roll_rpm);
      if (Stepper_CopyState(&state) == 0U ||
          state.last_stop_reason == STEPPER_STOP_START_FAILED ||
          state.last_stop_reason == STEPPER_STOP_RANGE)
      {
        WormAxis_ConfirmRollCommand(0U);
        Stepper_Stop();
        return 0U;
      }
      return 1U;
    case WORM_ROLL_ACTION_START_BACKOFF:
      Stepper_DisarmReleaseStop();
      Stepper_Stop();
      accepted = Stepper_ArmReleaseStop(out->roll_release_arm_mask);
      if (accepted != 0U)
      {
        Stepper_SetContinuousSignedRpm(out->roll_rpm);
        accepted = Stepper_CopyState(&state);
        accepted = (accepted != 0U && (state.running != 0U ||
                    state.last_stop_reason == STEPPER_STOP_RELEASE)) ? 1U : 0U;
      }
      WormAxis_ConfirmRollCommand(accepted);
      break;
    case WORM_ROLL_ACTION_START_CENTER:
      Stepper_DisarmReleaseStop();
      Stepper_Stop();
      Stepper_MoveAbsolute(out->roll_center_pos, (uint16_t)out->roll_rpm);
      accepted = Stepper_CopyState(&state);
      accepted = (accepted != 0U && (state.running != 0U ||
                  (state.current_pos == out->roll_center_pos &&
                   state.last_stop_reason == STEPPER_STOP_COMPLETED))) ? 1U : 0U;
      WormAxis_ConfirmRollCommand(accepted);
      break;
    case WORM_ROLL_ACTION_KEEP_BACKOFF:
    case WORM_ROLL_ACTION_KEEP_CENTER:
      return 1U;
    default:
      accepted = 0U;
      WormAxis_ConfirmRollCommand(0U);
      break;
  }
  if (accepted == 0U)
  {
    Stepper_DisarmReleaseStop();
    Stepper_Stop();
  }
  return accepted;
}

extern void DemoFatFS(void);

/* USER CODE END 0 */

/**
  * @brief  The application entry point.
  * @retval int
  */
int main(void)
{

  /* USER CODE BEGIN 1 */
  g_dbg_boot_stage = 1U;

  /* USER CODE END 1 */

  /* MPU Configuration--------------------------------------------------------*/
  MPU_Config();

  /* MCU Configuration--------------------------------------------------------*/

  /* Reset of all peripherals, Initializes the Flash interface and the Systick. */
  HAL_Init();

  /* USER CODE BEGIN Init */
  g_dbg_boot_stage = 2U;

  /* USER CODE END Init */

  /* Configure the system clock */
  SystemClock_Config();

  /* USER CODE BEGIN SysInit */
  g_dbg_boot_stage = 3U;

  /* USER CODE END SysInit */

  /* Initialize all configured peripherals */
  MX_GPIO_Init();
  MX_MDMA_Init();
  MX_FDCAN1_Init();
  MX_SDMMC1_SD_Init();
  MX_UART4_Init();
  MX_USART1_UART_Init();
  MX_USART2_UART_Init();
  MX_USART3_UART_Init();
  MX_UART5_Init();
  MX_UART7_Init();
  MX_UART8_Init();
  MX_ADC1_Init();
  MX_SPI1_Init();
  MX_TIM1_Init();
  MX_TIM2_Init();
  MX_TIM4_Init();
  MX_I2C2_Init();
  MX_LPUART1_UART_Init();
  MX_SPI2_Init();
  MX_TIM15_Init();
  MX_FATFS_Init();
  /* USER CODE BEGIN 2 */
  /* 此处只初始化状态；较慢的 ADC 校准交给低优先级电池任务，不阻塞启动。 */
  (void)BatteryMonitor_Init(&hadc1);
  g_dbg_boot_stage = 46U;
  GliderCore_Init(&huart7);
  g_dbg_boot_stage = 4U;

  /* Initialize Ethernet UART driver on LPUART1 */
  EthernetUartDriver_Init(&hlpuart1);
  
  /* Initialize IMU module on UART5 (PB13 TX, PB12 RX). */
  IMU_Core_Init(&huart5);

  /* Initialize pressure sensor non-blocking RX driver */
  PressureSensorDriver_Init(&huart1);

  /* 尾舵使用 J9 / PD15 / TIM4_CH4：先写中位，再启动 333Hz PWM。 */
  if (RudderDriver_Init(&htim4) != HAL_OK)
  {
    Error_Handler();
  }
  g_dbg_servo_start_ok = 1U;

  /* Initialize thruster PWM driver on TIM15 CH1/CH2 (PE5/PE6). */
  if (ThrusterDriver_Init(&htim15) != HAL_OK)
  {
    Error_Handler();
  }

  /* Initialize SBUS non-blocking RX driver on UART8 */
  SbusDriver_Init(&huart8);

  /* Initialize buzzer PWM driver on TIM2 CH1 / PA0 */
  BuzzerDriver_Init(&htim2);
  {
    static const BuzzerTone init_done_tone[] = {
      {1200U, 90U},
      {1600U, 90U},
      {2000U, 90U},
      {2600U, 140U}
    };
    uint32_t tone_start_tick;

    BuzzerDriver_PlaySequence(init_done_tone,
                              (uint32_t)(sizeof(init_done_tone) / sizeof(init_done_tone[0])));
    tone_start_tick = HAL_GetTick();
    while ((g_buzzer_diag.active != 0U) && ((HAL_GetTick() - tone_start_tick) < 700U))
    {
      BuzzerDriver_Poll(HAL_GetTick());
      HAL_Delay(5U);
    }
  }
  /* USER CODE END 2 */

  /* Init scheduler */
  osKernelInitialize();

  /* USER CODE BEGIN RTOS_MUTEX */
  /* add mutexes, ... */
  DisplacementSensor_Init(&huart3);
  IoControlPump_Init();
  PidControlService_Init();//新添加的PID任务初始化
  /* USER CODE END RTOS_MUTEX */

  /* USER CODE BEGIN RTOS_SEMAPHORES */
  /* add semaphores, ... */
  /* USER CODE END RTOS_SEMAPHORES */

  /* USER CODE BEGIN RTOS_TIMERS */
  /* start timers, add new ones, ... */
  /* USER CODE END RTOS_TIMERS */

  /* USER CODE BEGIN RTOS_QUEUES */
  /* add queues, ... */
  /* USER CODE END RTOS_QUEUES */

  /* Create the thread(s) */
  /* creation of defaultTask */
  defaultTaskHandle = osThreadNew(StartDefaultTask, NULL, &defaultTask_attributes);

  /* creation of uart7RxTask */
  uart7RxTaskHandle = osThreadNew(StartUartRxTask, NULL, &uart7RxTask_attributes);

  /* creation of uartTxTask */
  uartTxTaskHandle = osThreadNew(StartUartTxTask, NULL, &uartTxTask_attributes);

  /* creation of imuRxTask */
  imuRxTaskHandle = osThreadNew(Start_IMU_Task, NULL, &imuRxTask_attributes);

  /* creation of servoTask */
  servoTaskHandle = osThreadNew(StartServoTask, NULL, &servoTask_attributes);

  /* creation of Usart3Task */
  Usart3TaskHandle = osThreadNew(StartUsart3Task, NULL, &Usart3Task_attributes);

  /* creation of Usart2Task */
  Usart2TaskHandle = osThreadNew(StartUsart2Task, NULL, &Usart2Task_attributes);

  /* USER CODE BEGIN RTOS_THREADS */
  /* add threads, ... */
  batteryTaskHandle = osThreadNew(StartBatteryTask, NULL, &batteryTask_attributes);
  if (batteryTaskHandle == NULL)
  {
    Error_Handler();
  }
  EthernetTaskHandle = osThreadNew(EthernetUartDriver_RunTask, NULL, &EthernetTask_attributes);
  /* 创建 EKF 任务，基于事件触发，IMU 输入后被唤醒 */
  ekfTaskHandle = osThreadNew(StartEkfTask, NULL, &ekfTask_attributes);
  /* 创建 SD 卡日志任务，每分钟落盘一次系统快照 */
  sdLogTaskHandle = osThreadNew(StartSdLogTask, NULL, &sdLogTask_attributes);
  g_dbg_boot_stage = 6U;//EKF Task 阶段标志位
  /* USER CODE END RTOS_THREADS */

  /* USER CODE BEGIN RTOS_EVENTS */
  /* add events, ... */
  g_dbg_boot_stage = 7U;
  /* USER CODE END RTOS_EVENTS */

  /* Start scheduler */
  osKernelStart();

  /* We should never get here as control is now taken by the scheduler */

  /* Infinite loop */
  /* USER CODE BEGIN WHILE */
  while (1)
  {
    /* USER CODE END WHILE */

    /* USER CODE BEGIN 3 */
  }
  /* USER CODE END 3 */
}

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
/* USER CODE BEGIN 4 */

void GliderCore_OnTextFrame(const char *line)
{
  size_t i = 0U;
  size_t len = 0U;

  if (line == NULL)
  {
    g_dbg_last_rx_text_len = 0U;
    g_dbg_last_rx_text[0] = '\0';
    g_dbg_last_rx_update_count++;
    g_dbg_view.last_rx_text_len = 0U;
    g_dbg_view.last_rx_text[0] = '\0';
    g_dbg_view.last_rx_update_count = g_dbg_last_rx_update_count;
    return;
  }

  while (line[len] != '\0' && len < (sizeof(g_dbg_last_rx_text) - 1U))
  {
    len++;
  }

  for (i = 0U; i < len; i++)
  {
    g_dbg_last_rx_text[i] = line[i];
  }
  g_dbg_last_rx_text[len] = '\0';

  for (i = len + 1U; i < sizeof(g_dbg_last_rx_text); i++)
  {
    g_dbg_last_rx_text[i] = '\0';
  }

  g_dbg_last_rx_text_len = (uint32_t)len;
  g_dbg_last_rx_update_count++;
  g_dbg_view.last_rx_text_len = g_dbg_last_rx_text_len;
  for (i = 0U; i < sizeof(g_dbg_view.last_rx_text); i++)
  {
    g_dbg_view.last_rx_text[i] = g_dbg_last_rx_text[i];
  }
  g_dbg_view.last_rx_update_count = g_dbg_last_rx_update_count;

  for (i = 0U; i < sizeof(g_dbg_quick.last_text); i++)
  {
    if (i < len)
    {
      g_dbg_quick.last_text[i] = line[i];
    }
    else
    {
      g_dbg_quick.last_text[i] = '\0';
    }
  }
}

void GliderCore_OnBinaryFrame(const uint8_t *payload, size_t payload_len)
{
  size_t i = 0U;
  size_t copy_len = 0U;

  if (payload == NULL)
  {
    g_dbg_last_rx_bin_len = 0U;
    for (i = 0U; i < sizeof(g_dbg_last_rx_bin); i++)
    {
      g_dbg_last_rx_bin[i] = 0U;
    }
    g_dbg_last_rx_update_count++;
    g_dbg_view.last_rx_bin_len = 0U;
    for (i = 0U; i < sizeof(g_dbg_view.last_rx_bin); i++)
    {
      g_dbg_view.last_rx_bin[i] = 0U;
    }
    g_dbg_view.last_rx_update_count = g_dbg_last_rx_update_count;
    return;
  }

  copy_len = (payload_len < sizeof(g_dbg_last_rx_bin)) ? payload_len : sizeof(g_dbg_last_rx_bin);
  for (i = 0U; i < copy_len; i++)
  {
    g_dbg_last_rx_bin[i] = payload[i];
  }
  for (; i < sizeof(g_dbg_last_rx_bin); i++)
  {
    g_dbg_last_rx_bin[i] = 0U;
  }

  g_dbg_last_rx_bin_len = (uint32_t)copy_len;
  g_dbg_last_rx_update_count++;
  g_dbg_view.last_rx_bin_len = g_dbg_last_rx_bin_len;
  for (i = 0U; i < sizeof(g_dbg_view.last_rx_bin); i++)
  {
    g_dbg_view.last_rx_bin[i] = g_dbg_last_rx_bin[i];
  }
  g_dbg_view.last_rx_update_count = g_dbg_last_rx_update_count;
}

void GliderCore_OnDecodedFrame(const GliderRdssDecodedFrame *frame)
{
  size_t i = 0U;
  size_t len = 0U;

  if (frame == NULL)
  {
    g_dbg_is_rd_mode = 0U;
    g_dbg_is_bdpwi = 0U;
    g_dbg_card_id[0] = '\0';
    g_dbg_card_id_known = 0U;
    g_dbg_bdpwi_utc[0] = '\0';
    g_dbg_bdpwi_field1 = 0U;
    g_dbg_bdpwi_field2 = 0U;
    g_dbg_bdpwi_field1_valid = 0U;
    g_dbg_bdpwi_field2_valid = 0U;
    g_dbg_view.is_rd_mode = 0U;
    g_dbg_view.is_bdpwi = 0U;
    g_dbg_view.bdpwi_utc[0] = '\0';
    g_dbg_view.bdpwi_field1 = 0U;
    g_dbg_view.bdpwi_field2 = 0U;
    g_dbg_view.bdpwi_field1_valid = 0U;
    g_dbg_view.bdpwi_field2_valid = 0U;
    g_dbg_view.bdpwi_latitude_raw[0] = '\0';
    g_dbg_view.bdpwi_longitude_raw[0] = '\0';
    g_dbg_view.bdpwi_heading_raw[0] = '\0';
    g_dbg_view.bdpwi_latitude_dm[0] = '\0';
    g_dbg_view.bdpwi_latitude_ns[0] = '\0';
    g_dbg_view.bdpwi_longitude_dm[0] = '\0';
    g_dbg_view.bdpwi_longitude_ew[0] = '\0';
    g_dbg_view.bdpwi_latitude_x100 = 0;
    g_dbg_view.bdpwi_longitude_x100 = 0;
    g_dbg_view.bdpwi_heading_x100 = 0;
    g_dbg_view.bdpwi_latitude_deg_e7 = 0;
    g_dbg_view.bdpwi_longitude_deg_e7 = 0;
    g_dbg_view.bdpwi_latitude_deg = 0.0f;
    g_dbg_view.bdpwi_longitude_deg = 0.0f;
    g_dbg_view.bdpwi_latitude_valid = 0U;
    g_dbg_view.bdpwi_longitude_valid = 0U;
    g_dbg_view.bdpwi_heading_valid = 0U;
    g_dbg_view.bdpwi_latitude_deg_valid = 0U;
    g_dbg_view.bdpwi_longitude_deg_valid = 0U;
    g_dbg_view.bdpwi_old_beam_count = 0U;
    g_dbg_view.bdpwi_new_beam_count = 0U;
    g_dbg_view.bdpwi_best_d_cnr = 0U;
    g_dbg_view.bdpwi_best_p_cnr = 0U;
    g_dbg_view.bdpwi_good_beam_count = 0U;
    g_dbg_view.rd_signal_good = 0U;
    g_dbg_view.tx_mode = 0U;
    g_dbg_view.last_tx_text[0] = '\0';
    g_dbg_view.card_id[0] = '\0';
    g_dbg_view.card_id_known = 0U;
    g_dbg_view.shortmsg_sent_count = 0U;
    g_dbg_view.last_shortmsg_payload[0] = '\0';
    g_dbg_view.is_gnrmc = 0U;
    g_dbg_view.gnrmc_utc[0] = '\0';
    g_dbg_view.gnrmc_status[0] = '\0';
    g_dbg_view.gnrmc_date[0] = '\0';
    g_dbg_view.gnrmc_latitude_dm[0] = '\0';
    g_dbg_view.gnrmc_latitude_ns[0] = '\0';
    g_dbg_view.gnrmc_longitude_dm[0] = '\0';
    g_dbg_view.gnrmc_longitude_ew[0] = '\0';
    g_dbg_view.gnrmc_latitude_deg_e7 = 0;
    g_dbg_view.gnrmc_longitude_deg_e7 = 0;
    g_dbg_view.gnrmc_latitude_deg = 0.0f;
    g_dbg_view.gnrmc_longitude_deg = 0.0f;
    g_dbg_view.gnrmc_status_valid = 0U;
    g_dbg_view.gnrmc_latitude_valid = 0U;
    g_dbg_view.gnrmc_longitude_valid = 0U;
    g_dbg_view.is_bdepi = 0U;
    g_dbg_view.bdepi_sender_card[0] = '\0';
    g_dbg_view.bdepi_receiver_card[0] = '\0';
    g_dbg_view.bdepi_utc[0] = '\0';
    g_dbg_view.bdepi_freq_code = 0U;
    g_dbg_view.bdepi_emergency_code = 0U;
    g_dbg_view.bdepi_report_mode = 0U;
    g_dbg_view.bdepi_freq_valid = 0U;
    g_dbg_view.bdepi_emergency_valid = 0U;
    g_dbg_view.bdepi_report_mode_valid = 0U;
    g_dbg_view.bdepi_longitude_dm[0] = '\0';
    g_dbg_view.bdepi_longitude_ew[0] = '\0';
    g_dbg_view.bdepi_latitude_dm[0] = '\0';
    g_dbg_view.bdepi_latitude_ns[0] = '\0';
    g_dbg_view.bdepi_longitude_deg_e7 = 0;
    g_dbg_view.bdepi_latitude_deg_e7 = 0;
    g_dbg_view.bdepi_longitude_deg = 0.0f;
    g_dbg_view.bdepi_latitude_deg = 0.0f;
    g_dbg_view.bdepi_longitude_valid = 0U;
    g_dbg_view.bdepi_latitude_valid = 0U;
    g_dbg_view.bdepi_altitude_raw[0] = '\0';
    g_dbg_view.bdepi_altitude_x100 = 0;
    g_dbg_view.bdepi_altitude_valid = 0U;
    g_dbg_view.bdepi_altitude_unit[0] = '\0';
    g_dbg_view.bdepi_altitude_abnormal[0] = '\0';
    g_dbg_view.bdepi_altitude_abn_unit[0] = '\0';
    g_dbg_view.bdepi_precision_indicator[0] = '\0';
    g_dbg_view.bdepi_multi_solution[0] = '\0';
    g_dbg_view.bdepi_rescue_subtype[0] = '\0';
    g_dbg_view.bdepi_rescue_center_type[0] = '\0';
    g_dbg_view.bdepi_data_len = 0U;
    g_dbg_view.bdepi_data_len_valid = 0U;
    g_dbg_view.bdepi_data_payload[0] = '\0';

    g_dbg_quick.frame_type = 0U;
    g_dbg_quick.checksum_valid = 0U;
    g_dbg_quick.is_bdpwi = 0U;
    g_dbg_quick.is_bdepi = 0U;
    g_dbg_quick.is_gnrmc = 0U;
    g_dbg_quick.sentence[0] = '\0';
    g_dbg_quick.utc[0] = '\0';
    g_dbg_quick.mode_code = 0U;
    g_dbg_quick.status_code = 0U;
    g_dbg_quick.longitude_deg = 0.0f;
    g_dbg_quick.latitude_deg = 0.0f;
    g_dbg_quick.position_valid = 0U;
    g_dbg_quick.signal_good = 0U;
    g_dbg_quick.tx_mode = 0U;
    g_dbg_quick.card_id_known = 0U;
    g_dbg_quick.card_mismatch = 0U;
    g_dbg_quick.has_cached_fix = 0U;
    g_dbg_quick.shortmsg_pending = 0U;
    g_dbg_quick.ready_to_send = 0U;
    g_dbg_quick.local_card_id[0] = '\0';
    g_dbg_quick.target_card_id[0] = '\0';
    g_dbg_quick.last_tx_text[0] = '\0';
    return;
  }

  g_dbg_quick.update_count++;
  g_dbg_quick.frame_type = (uint32_t)frame->type;
  g_dbg_quick.checksum_valid = frame->checksum_valid ? 1U : 0U;
  g_dbg_quick.is_bdpwi = frame->is_bdpwi ? 1U : 0U;
  g_dbg_quick.is_bdepi = frame->is_bdepi ? 1U : 0U;
  g_dbg_quick.is_gnrmc = frame->is_gnrmc ? 1U : 0U;
  for (i = 0U; i < sizeof(g_dbg_quick.sentence); i++)
  {
    g_dbg_quick.sentence[i] = frame->sentence[i];
  }
  for (i = 0U; i < sizeof(g_dbg_quick.last_tx_text); i++)
  {
    g_dbg_quick.last_tx_text[i] = g_dbg_last_tx_text[i];
  }

  g_dbg_is_rd_mode = frame->is_rd_mode ? 1U : 0U;
  g_dbg_is_bdpwi = frame->is_bdpwi ? 1U : 0U;

  while (frame->bdpwi_utc[len] != '\0' && len < (sizeof(g_dbg_bdpwi_utc) - 1U))
  {
    len++;
  }
  for (i = 0U; i < len; i++)
  {
    g_dbg_bdpwi_utc[i] = frame->bdpwi_utc[i];
  }
  g_dbg_bdpwi_utc[len] = '\0';
  for (i = len + 1U; i < sizeof(g_dbg_bdpwi_utc); i++)
  {
    g_dbg_bdpwi_utc[i] = '\0';
  }

  g_dbg_bdpwi_field1 = frame->bdpwi_field1;
  g_dbg_bdpwi_field2 = frame->bdpwi_field2;
  g_dbg_bdpwi_field1_valid = frame->bdpwi_field1_valid ? 1U : 0U;
  g_dbg_bdpwi_field2_valid = frame->bdpwi_field2_valid ? 1U : 0U;
  g_dbg_view.is_rd_mode = g_dbg_is_rd_mode;
  g_dbg_view.is_bdpwi = g_dbg_is_bdpwi;
  for (i = 0U; i < sizeof(g_dbg_view.bdpwi_utc); i++)
  {
    g_dbg_view.bdpwi_utc[i] = g_dbg_bdpwi_utc[i];
  }
  g_dbg_view.bdpwi_field1 = g_dbg_bdpwi_field1;
  g_dbg_view.bdpwi_field2 = g_dbg_bdpwi_field2;
  g_dbg_view.bdpwi_field1_valid = g_dbg_bdpwi_field1_valid;
  g_dbg_view.bdpwi_field2_valid = g_dbg_bdpwi_field2_valid;

  for (i = 0U; i < sizeof(g_dbg_view.bdpwi_latitude_raw); i++)
  {
    g_dbg_view.bdpwi_latitude_raw[i] = frame->bdpwi.latitude_raw[i];
    g_dbg_view.bdpwi_longitude_raw[i] = frame->bdpwi.longitude_raw[i];
    g_dbg_view.bdpwi_heading_raw[i] = frame->bdpwi.heading_raw[i];
  }
  for (i = 0U; i < sizeof(g_dbg_view.bdpwi_latitude_dm); i++)
  {
    g_dbg_view.bdpwi_latitude_dm[i] = frame->bdpwi.latitude_dm[i];
    g_dbg_view.bdpwi_longitude_dm[i] = frame->bdpwi.longitude_dm[i];
  }
  for (i = 0U; i < sizeof(g_dbg_view.bdpwi_latitude_ns); i++)
  {
    g_dbg_view.bdpwi_latitude_ns[i] = frame->bdpwi.latitude_ns[i];
    g_dbg_view.bdpwi_longitude_ew[i] = frame->bdpwi.longitude_ew[i];
  }
  g_dbg_view.bdpwi_latitude_x100 = frame->bdpwi.latitude_x100;
  g_dbg_view.bdpwi_longitude_x100 = frame->bdpwi.longitude_x100;
  g_dbg_view.bdpwi_heading_x100 = frame->bdpwi.heading_x100;
  g_dbg_view.bdpwi_latitude_deg_e7 = frame->bdpwi.latitude_deg_e7;
  g_dbg_view.bdpwi_longitude_deg_e7 = frame->bdpwi.longitude_deg_e7;
  g_dbg_view.bdpwi_latitude_valid = frame->bdpwi.latitude_valid ? 1U : 0U;
  g_dbg_view.bdpwi_longitude_valid = frame->bdpwi.longitude_valid ? 1U : 0U;
  g_dbg_view.bdpwi_heading_valid = frame->bdpwi.heading_valid ? 1U : 0U;
  if (frame->bdpwi.latitude_deg_valid)
  {
    g_dbg_view.bdpwi_latitude_deg = ((float)frame->bdpwi.latitude_deg_e7) / 10000000.0f;
  }
  else
  {
    g_dbg_view.bdpwi_latitude_deg = 0.0f;
  }
  if (frame->bdpwi.longitude_deg_valid)
  {
    g_dbg_view.bdpwi_longitude_deg = ((float)frame->bdpwi.longitude_deg_e7) / 10000000.0f;
  }
  else
  {
    g_dbg_view.bdpwi_longitude_deg = 0.0f;
  }
  g_dbg_view.bdpwi_latitude_deg_valid = frame->bdpwi.latitude_deg_valid ? 1U : 0U;
  g_dbg_view.bdpwi_longitude_deg_valid = frame->bdpwi.longitude_deg_valid ? 1U : 0U;
  g_dbg_view.bdpwi_old_beam_count = frame->bdpwi.old_beam_count;
  g_dbg_view.bdpwi_new_beam_count = frame->bdpwi.new_beam_count;
  g_dbg_view.bdpwi_best_d_cnr = frame->bdpwi.best_d_cnr;
  g_dbg_view.bdpwi_best_p_cnr = frame->bdpwi.best_p_cnr;
  g_dbg_view.bdpwi_good_beam_count = frame->bdpwi.good_beam_count;
  g_dbg_view.rd_signal_good = frame->bdpwi.signal_good ? 1U : 0U;
  g_dbg_view.tx_mode = g_dbg_tx_mode;
  g_dbg_view.is_gnrmc = frame->is_gnrmc ? 1U : 0U;
  for (i = 0U; i < sizeof(g_dbg_view.gnrmc_utc); i++)
  {
    g_dbg_view.gnrmc_utc[i] = frame->gnrmc.utc[i];
    g_dbg_view.gnrmc_date[i] = frame->gnrmc.date[i];
  }
  for (i = 0U; i < sizeof(g_dbg_view.gnrmc_status); i++)
  {
    g_dbg_view.gnrmc_status[i] = frame->gnrmc.status[i];
  }
  for (i = 0U; i < sizeof(g_dbg_view.gnrmc_latitude_dm); i++)
  {
    g_dbg_view.gnrmc_latitude_dm[i] = frame->gnrmc.latitude_dm[i];
    g_dbg_view.gnrmc_longitude_dm[i] = frame->gnrmc.longitude_dm[i];
  }
  for (i = 0U; i < sizeof(g_dbg_view.gnrmc_latitude_ns); i++)
  {
    g_dbg_view.gnrmc_latitude_ns[i] = frame->gnrmc.latitude_ns[i];
    g_dbg_view.gnrmc_longitude_ew[i] = frame->gnrmc.longitude_ew[i];
  }
  g_dbg_view.gnrmc_latitude_deg_e7 = frame->gnrmc.latitude_deg_e7;
  g_dbg_view.gnrmc_longitude_deg_e7 = frame->gnrmc.longitude_deg_e7;
  g_dbg_view.gnrmc_status_valid = frame->gnrmc.status_valid ? 1U : 0U;
  g_dbg_view.gnrmc_latitude_valid = frame->gnrmc.latitude_valid ? 1U : 0U;
  g_dbg_view.gnrmc_longitude_valid = frame->gnrmc.longitude_valid ? 1U : 0U;
  g_dbg_view.gnrmc_latitude_deg = frame->gnrmc.latitude_valid ? ((float)frame->gnrmc.latitude_deg_e7) / 10000000.0f : 0.0f;
  g_dbg_view.gnrmc_longitude_deg = frame->gnrmc.longitude_valid ? ((float)frame->gnrmc.longitude_deg_e7) / 10000000.0f : 0.0f;

  g_dbg_view.is_bdepi = frame->is_bdepi ? 1U : 0U;
  for (i = 0U; i < sizeof(g_dbg_view.bdepi_sender_card); i++)
  {
    g_dbg_view.bdepi_sender_card[i] = frame->bdepi.sender_card[i];
    g_dbg_view.bdepi_receiver_card[i] = frame->bdepi.receiver_card[i];
  }
  for (i = 0U; i < sizeof(g_dbg_view.bdepi_utc); i++)
  {
    g_dbg_view.bdepi_utc[i] = frame->bdepi.utc[i];
    g_dbg_view.bdepi_altitude_raw[i] = frame->bdepi.altitude_raw[i];
  }
  for (i = 0U; i < sizeof(g_dbg_view.bdepi_longitude_dm); i++)
  {
    g_dbg_view.bdepi_longitude_dm[i] = frame->bdepi.longitude_dm[i];
    g_dbg_view.bdepi_latitude_dm[i] = frame->bdepi.latitude_dm[i];
  }
  for (i = 0U; i < sizeof(g_dbg_view.bdepi_longitude_ew); i++)
  {
    g_dbg_view.bdepi_longitude_ew[i] = frame->bdepi.longitude_ew[i];
    g_dbg_view.bdepi_latitude_ns[i] = frame->bdepi.latitude_ns[i];
  }

  g_dbg_view.bdepi_freq_code = frame->bdepi.freq_code;
  g_dbg_view.bdepi_emergency_code = frame->bdepi.emergency_code;
  g_dbg_view.bdepi_report_mode = frame->bdepi.report_mode_code;
  g_dbg_view.bdepi_freq_valid = frame->bdepi.freq_code_valid ? 1U : 0U;
  g_dbg_view.bdepi_emergency_valid = frame->bdepi.emergency_code_valid ? 1U : 0U;
  g_dbg_view.bdepi_report_mode_valid = frame->bdepi.report_mode_valid ? 1U : 0U;
  g_dbg_view.bdepi_longitude_deg_e7 = frame->bdepi.longitude_deg_e7;
  g_dbg_view.bdepi_latitude_deg_e7 = frame->bdepi.latitude_deg_e7;
  if (frame->bdepi.longitude_valid)
  {
    g_dbg_view.bdepi_longitude_deg = ((float)frame->bdepi.longitude_deg_e7) / 10000000.0f;
  }
  else
  {
    g_dbg_view.bdepi_longitude_deg = 0.0f;
  }

  if (frame->bdepi.latitude_valid)
  {
    g_dbg_view.bdepi_latitude_deg = ((float)frame->bdepi.latitude_deg_e7) / 10000000.0f;
  }
  else
  {
    g_dbg_view.bdepi_latitude_deg = 0.0f;
  }
  g_dbg_view.bdepi_longitude_valid = frame->bdepi.longitude_valid ? 1U : 0U;
  g_dbg_view.bdepi_latitude_valid = frame->bdepi.latitude_valid ? 1U : 0U;
  g_dbg_view.bdepi_altitude_x100 = frame->bdepi.altitude_x100;
  g_dbg_view.bdepi_altitude_valid = frame->bdepi.altitude_valid ? 1U : 0U;
  g_dbg_view.bdepi_data_len = frame->bdepi.data_len;
  g_dbg_view.bdepi_data_len_valid = frame->bdepi.data_len_valid ? 1U : 0U;

  for (i = 0U; i < sizeof(g_dbg_view.bdepi_altitude_unit); i++)
  {
    g_dbg_view.bdepi_altitude_unit[i] = frame->bdepi.altitude_unit[i];
    g_dbg_view.bdepi_altitude_abn_unit[i] = frame->bdepi.altitude_abnormal_unit[i];
  }
  for (i = 0U; i < sizeof(g_dbg_view.bdepi_altitude_abnormal); i++)
  {
    g_dbg_view.bdepi_altitude_abnormal[i] = frame->bdepi.altitude_abnormal[i];
    g_dbg_view.bdepi_precision_indicator[i] = frame->bdepi.precision_indicator[i];
    g_dbg_view.bdepi_multi_solution[i] = frame->bdepi.multi_solution[i];
    g_dbg_view.bdepi_rescue_subtype[i] = frame->bdepi.rescue_subtype[i];
    g_dbg_view.bdepi_rescue_center_type[i] = frame->bdepi.rescue_center_type[i];
  }
  for (i = 0U; i < sizeof(g_dbg_view.bdepi_data_payload); i++)
  {
    g_dbg_view.bdepi_data_payload[i] = frame->bdepi.data_payload[i];
  }

  if (frame->is_bdepi)
  {
    for (i = 0U; i < sizeof(g_dbg_quick.utc); i++)
    {
      g_dbg_quick.utc[i] = frame->bdepi.utc[i];
    }
    g_dbg_quick.mode_code = frame->bdepi.report_mode_code;
    g_dbg_quick.status_code = frame->bdepi.emergency_code;
    if (frame->bdepi.longitude_valid && frame->bdepi.latitude_valid)
    {
      g_dbg_quick.longitude_deg = g_dbg_view.bdepi_longitude_deg;
      g_dbg_quick.latitude_deg = g_dbg_view.bdepi_latitude_deg;
      g_dbg_quick.position_valid = 1U;
    }
    g_dbg_quick.tx_mode = g_dbg_tx_mode;
  }
  else if (frame->is_gnrmc)
  {
    for (i = 0U; i < sizeof(g_dbg_quick.utc); i++)
    {
      g_dbg_quick.utc[i] = frame->gnrmc.utc[i];
    }
    g_dbg_quick.mode_code = 0U;
    g_dbg_quick.status_code = frame->gnrmc.status_valid ? 1U : 0U;
    if (frame->gnrmc.status_valid && frame->gnrmc.longitude_valid && frame->gnrmc.latitude_valid)
    {
      g_dbg_quick.longitude_deg = g_dbg_view.gnrmc_longitude_deg;
      g_dbg_quick.latitude_deg = g_dbg_view.gnrmc_latitude_deg;
      g_dbg_quick.position_valid = 1U;
    }
    g_dbg_quick.tx_mode = g_dbg_tx_mode;
  }
  else if (frame->is_bdpwi)
  {
    for (i = 0U; i < sizeof(g_dbg_quick.utc); i++)
    {
      g_dbg_quick.utc[i] = frame->bdpwi.utc[i];
    }
    g_dbg_quick.mode_code = frame->bdpwi.mode_code;
    g_dbg_quick.status_code = frame->bdpwi.status_code;
    if (frame->bdpwi.longitude_deg_valid && frame->bdpwi.latitude_deg_valid)
    {
      g_dbg_quick.longitude_deg = g_dbg_view.bdpwi_longitude_deg;
      g_dbg_quick.latitude_deg = g_dbg_view.bdpwi_latitude_deg;
      g_dbg_quick.position_valid = 1U;
    }
    g_dbg_quick.tx_mode = g_dbg_tx_mode;
  }
  else
  {
    g_dbg_quick.utc[0] = '\0';
    g_dbg_quick.mode_code = 0U;
    g_dbg_quick.status_code = 0U;
    g_dbg_quick.tx_mode = g_dbg_tx_mode;
  }
}

void HAL_UART_ErrorCallback(UART_HandleTypeDef *huart)
{
  if (huart == NULL)
  {
    return;
  }

  if (huart->Instance == UART5)
  {
    g_dbg_uart4_error_count++;
    g_dbg_uart4_last_error = huart->ErrorCode;
    
    /* Clear error flags so UART can resume receiving */
    __HAL_UART_CLEAR_OREFLAG(huart);
    __HAL_UART_CLEAR_NEFLAG(huart);
    __HAL_UART_CLEAR_FEFLAG(huart);
    __HAL_UART_CLEAR_PEFLAG(huart);
    
    /* Optionally clear the DMA/reception state to allow recovery */
    huart->RxState = HAL_UART_STATE_READY;
    IMU_OnUART_Error(huart);
  }
  else if (huart->Instance == USART3)
  {
    g_dbg_uart3_error_count++;
    g_dbg_uart3_last_error = huart->ErrorCode;
    /* 先把原始错误码交给位移模块；恢复与重挂由 Usart3Task 完成。 */
    DisplacementSensor_OnError(huart);
  }

  PressureSensorDriver_OnError(huart);
  SbusDriver_OnError(huart);
  EthernetUartDriver_OnError(huart);
}

void vAssertCalled(const char *file, int line)
{
  (void)file;
  g_dbg_assert_count++;
  g_dbg_assert_line = (uint32_t)line;
  g_dbg_rtos_hook_code = 1U;
  taskDISABLE_INTERRUPTS();
  for (;;)
  {
  }
}

void vApplicationMallocFailedHook(void)
{
  g_dbg_rtos_hook_code = 2U;
  taskDISABLE_INTERRUPTS();
  for (;;)
  {
  }
}

void vApplicationStackOverflowHook(TaskHandle_t xTask, char *pcTaskName)
{
  (void)xTask;
  (void)pcTaskName;
  g_dbg_rtos_hook_code = 3U;
  taskDISABLE_INTERRUPTS();
  for (;;)
  {
  }
}

/* USER CODE END 4 */

/* USER CODE BEGIN Header_StartDefaultTask */
/**
  * @brief  Function implementing the defaultTask thread.
  * @param  argument: Not used
  * @retval None
  */
/* USER CODE END Header_StartDefaultTask */
void StartDefaultTask(void *argument)
{
  /* USER CODE BEGIN 5 */
  uint32_t led_last_toggle_tick = 0U;
  static uint32_t sd_mount_done = 0U;
  static uint32_t sd_mount_last_try_tick = 0U;
  (void)argument;
  g_dbg_boot_stage = 100U;

  DemoFatFS();

  /* Infinite loop */
  for(;;)
  {

    g_dbg_alive_counter++;
    g_dbg_rtos_tick = osKernelGetTickCount();
    g_dbg_rx_line_count = GliderCore_GetRxLineCount();
    g_dbg_rx_overflow_count = GliderCore_GetRxOverflowCount();
    g_dbg_tx_attempt_count = GliderCore_GetTxAttemptCount();
    g_dbg_tx_ok_count = GliderCore_GetTxOkCount();
    g_dbg_tx_fail_count = GliderCore_GetTxFailCount();
    g_dbg_tx_last_status = GliderCore_GetLastTxHalStatus();
    g_dbg_tx_last_uart_error = GliderCore_GetLastUartErrorCode();
    g_dbg_signal_good = GliderCore_GetSignalGood();
    g_dbg_tx_mode = GliderCore_GetTxMode();
    g_dbg_shortmsg_sent_count = GliderCore_GetShortMsgSentCount();
    g_dbg_card_id_known = GliderCore_GetCardIdKnown();
    g_dbg_default_task_tick = g_dbg_rtos_tick;

    if ((g_dbg_rtos_tick - led_last_toggle_tick) >= 500U)
    {
      led_last_toggle_tick = g_dbg_rtos_tick;
      HAL_GPIO_TogglePin(LED_GPIO_Port, LED_Pin);
    }

    BuzzerDriver_Poll(g_dbg_rtos_tick);

    g_dbg_view.boot_stage = g_dbg_boot_stage;
    g_dbg_view.alive_counter = g_dbg_alive_counter;
    g_dbg_view.rtos_tick = g_dbg_rtos_tick;
    g_dbg_view.rx_line_count = g_dbg_rx_line_count;
    g_dbg_view.rx_overflow_count = g_dbg_rx_overflow_count;
    g_dbg_view.tx_attempt_count = g_dbg_tx_attempt_count;
    g_dbg_view.tx_ok_count = g_dbg_tx_ok_count;
    g_dbg_view.tx_fail_count = g_dbg_tx_fail_count;
    g_dbg_view.tx_last_status = g_dbg_tx_last_status;
    g_dbg_view.tx_last_uart_error = g_dbg_tx_last_uart_error;
    g_dbg_view.rd_signal_good = g_dbg_signal_good;
    g_dbg_view.tx_mode = g_dbg_tx_mode;
    for (size_t tx_i = 0U; tx_i < sizeof(g_dbg_last_tx_text); tx_i++)
    {
      g_dbg_last_tx_text[tx_i] = '\0';
    }
    {
      const char *last_tx = GliderCore_GetLastTxText();
      size_t tx_i = 0U;
      while (last_tx != NULL && last_tx[tx_i] != '\0' && tx_i < (sizeof(g_dbg_last_tx_text) - 1U))
      {
        g_dbg_last_tx_text[tx_i] = last_tx[tx_i];
        tx_i++;
      }
      g_dbg_last_tx_text[tx_i] = '\0';
    }
    for (size_t tx_i = 0U; tx_i < sizeof(g_dbg_view.last_tx_text); tx_i++)
    {
      g_dbg_view.last_tx_text[tx_i] = g_dbg_last_tx_text[tx_i];
    }
    for (size_t card_i = 0U; card_i < sizeof(g_dbg_card_id); card_i++)
    {
      g_dbg_card_id[card_i] = '\0';
    }
    {
      const char *card_id = GliderCore_GetCardId();
      size_t card_i = 0U;
      while (card_id != NULL && card_id[card_i] != '\0' && card_i < (sizeof(g_dbg_card_id) - 1U))
      {
        g_dbg_card_id[card_i] = card_id[card_i];
        card_i++;
      }
      g_dbg_card_id[card_i] = '\0';
    }
    for (size_t card_i = 0U; card_i < sizeof(g_dbg_view.card_id); card_i++)
    {
      g_dbg_view.card_id[card_i] = g_dbg_card_id[card_i];
    }
    g_dbg_view.card_id_known = g_dbg_card_id_known;
    for (size_t sm_i = 0U; sm_i < sizeof(g_dbg_last_shortmsg_payload); sm_i++)
    {
      g_dbg_last_shortmsg_payload[sm_i] = '\0';
    }
    {
      const char *last_sm = GliderCore_GetLastShortMsgPayload();
      size_t sm_i = 0U;
      while (last_sm != NULL && last_sm[sm_i] != '\0' && sm_i < (sizeof(g_dbg_last_shortmsg_payload) - 1U))
      {
        g_dbg_last_shortmsg_payload[sm_i] = last_sm[sm_i];
        sm_i++;
      }
      g_dbg_last_shortmsg_payload[sm_i] = '\0';
    }
    g_dbg_view.shortmsg_sent_count = g_dbg_shortmsg_sent_count;
    for (size_t sm_i = 0U; sm_i < sizeof(g_dbg_view.last_shortmsg_payload); sm_i++)
    {
      g_dbg_view.last_shortmsg_payload[sm_i] = g_dbg_last_shortmsg_payload[sm_i];
    }

    g_dbg_quick.signal_good = g_dbg_signal_good;
    g_dbg_quick.tx_mode = g_dbg_tx_mode;
    g_dbg_quick.card_id_known = g_dbg_card_id_known;
    g_dbg_quick.card_mismatch = GliderCore_GetCardMismatch();
    g_dbg_quick.has_cached_fix = GliderCore_GetHasCachedFix();
    g_dbg_quick.shortmsg_pending = GliderCore_GetShortMsgPending();
    g_dbg_quick.ready_to_send = GliderCore_GetReadyToSend();

    for (size_t card_i = 0U; card_i < sizeof(g_dbg_quick.local_card_id); card_i++)
    {
      g_dbg_quick.local_card_id[card_i] = g_dbg_card_id[card_i];
    }
    {
      const char *target_card = GliderCore_GetPlatformCardId();
      size_t card_i = 0U;
      for (card_i = 0U; card_i < sizeof(g_dbg_quick.target_card_id); card_i++)
      {
        g_dbg_quick.target_card_id[card_i] = '\0';
      }
      card_i = 0U;
      while (target_card != NULL && target_card[card_i] != '\0' && card_i < (sizeof(g_dbg_quick.target_card_id) - 1U))
      {
        g_dbg_quick.target_card_id[card_i] = target_card[card_i];
        card_i++;
      }
      g_dbg_quick.target_card_id[card_i] = '\0';
    }

    PressureSensorDriver_Poll(g_dbg_rtos_tick);

    osDelay(100);
  }
  /* USER CODE END 5 */
}

/* USER CODE BEGIN Header_StartUartRxTask */
/**
* @brief Function implementing the uart7RxTask thread.
* @param argument: Not used
* @retval None
*/
/* USER CODE END Header_StartUartRxTask */
void StartUartRxTask(void *argument)
{
  /* USER CODE BEGIN StartUartRxTask */
  (void)argument;
  GliderCore_RunRxTask();
  /* USER CODE END StartUartRxTask */
}

/* USER CODE BEGIN Header_StartUartTxTask */
/**
* @brief Function implementing the uartTxTask thread.
* @param argument: Not used
* @retval None
*/
/* USER CODE END Header_StartUartTxTask */
void StartUartTxTask(void *argument)
{
  /* USER CODE BEGIN StartUartTxTask */
  (void)argument;
  GliderCore_RunTxTask();
  /* USER CODE END StartUartTxTask */
}

/* USER CODE BEGIN Header_Start_IMU_Task */
/**
* @brief Function implementing the imuRxTask thread.
* @param argument: Not used
* @retval None
*/
/* USER CODE END Header_Start_IMU_Task */
void Start_IMU_Task(void *argument)
{
  /* USER CODE BEGIN Start_IMU_Task */
  uint32_t i;
  uint8_t recent_buf[16];
  IMU_RawData raw;
  IMU_EulerAngle euler;
  IMU_Quaternion quat;
  IMU_BaroData baro;
  IMU_Version ver;

  /* Infinite loop */
  for(;;)
  {
    g_dbg_imu_task_loop_count++;

    /* Update statistics */
    g_imu_debug.frame_count = IMU_Core_GetFrameCount();
    g_imu_debug.crc_error_count = IMU_Core_GetCrcErrorCount();
    g_imu_debug.rx_overflow_count = IMU_Core_GetRxOverflowCount();
    g_imu_debug.rx_irq_count = IMU_Core_GetRxIrqCount();
    g_imu_debug.rx_byte_count = IMU_Core_GetRxByteCount();
    g_imu_debug.rx_poll_byte_count = IMU_Core_GetRxPollByteCount();
    g_imu_debug.rx_rearm_ok_count = IMU_Core_GetRxRearmOkCount();
    g_imu_debug.rx_rearm_fail_count = IMU_Core_GetRxRearmFailCount();
    g_imu_debug.rx_init_status = IMU_Core_GetRxInitStatus();
    g_imu_debug.uart4_irq_count = g_dbg_uart4_irq_count;
    g_imu_debug.uart4_error_count = g_dbg_uart4_error_count;
    g_imu_debug.uart4_last_error = g_dbg_uart4_last_error;
    g_imu_debug.uart_rxne_flag = IMU_Core_GetUartRxneFlag();
    g_imu_debug.uart_error_flags = IMU_Core_GetUartErrorFlags();
    g_imu_debug.recent_rx_len = IMU_Core_GetRecentRxBytes(recent_buf, sizeof(recent_buf));
    for (i = 0U; i < sizeof(g_imu_debug.recent_rx_bytes); i++)
    {
      g_imu_debug.recent_rx_bytes[i] = (i < g_imu_debug.recent_rx_len) ? recent_buf[i] : 0U;
    }
    g_imu_debug.task_loop_count = g_dbg_imu_task_loop_count;
    g_imu_debug.last_function_code = IMU_Core_GetLastFunctionCode();
    g_imu_debug.last_rx_function = IMU_Core_GetLastRxFunction();
    g_imu_debug.last_rx_state = IMU_Core_GetLastRxState();
    g_imu_debug.freq_set_attempt_count = IMU_Core_GetFreqSetAttemptCount();
    g_imu_debug.freq_set_success_count = IMU_Core_GetFreqSetSuccessCount();
    g_imu_debug.freq_set_last_status = IMU_Core_GetFreqSetLastStatus();
    g_imu_debug.requested_output_hz = IMU_Core_GetRequestedOutputFreqHz();
    g_imu_debug.version_request_attempt_count = IMU_Core_GetVersionRequestAttemptCount();
    g_imu_debug.version_request_last_status = IMU_Core_GetVersionRequestLastStatus();

    /* Read raw 9-axis data if available */
    if (IMU_Core_GetRawData(&raw))
    {
      g_imu_debug.ax = raw.accel.ax;
      g_imu_debug.ay = raw.accel.ay;
      g_imu_debug.az = raw.accel.az;
      g_imu_debug.gx = raw.gyro.gx;
      g_imu_debug.gy = raw.gyro.gy;
      g_imu_debug.gz = raw.gyro.gz;
      g_imu_debug.mx = raw.mag.mx;
      g_imu_debug.my = raw.mag.my;
      g_imu_debug.mz = raw.mag.mz;
      g_imu_debug.raw_updated = raw.updated;

    /*输入给ESKF，唯一 IMU 数据源，时间戳用统一单调时钟，唤醒EKF任务*/
    //写IMU快照，防止读写冲突，唤醒EKFTask，定义在ekf_task
    /* 仅在真正有新 raw 帧时投喂 ESKF，IMU_Core_GetRawData 的返回值是"曾收到过帧"，
       不是新帧；raw.updated 才是真正的新帧标志。否则会以 ~1kHz 重复投喂旧帧导致活锁
       上一版bug在于用于判断的参数错误 */
      if (raw.updated)
      {
        EkfTask_PublishImuRaw(&raw, GliderTime_NowUs());
      }
    }

    /* Read Euler angles if available */
    if (IMU_Core_GetEulerAngle(&euler))
    {
      g_imu_debug.roll = euler.roll;
      g_imu_debug.pitch = euler.pitch;
      g_imu_debug.yaw = euler.yaw;
      g_imu_debug.euler_updated = euler.updated;
    }

    /* Read quaternion if available */
    if (IMU_Core_GetQuaternion(&quat))
    {
      g_imu_debug.q0 = quat.q0;
      g_imu_debug.q1 = quat.q1;
      g_imu_debug.q2 = quat.q2;
      g_imu_debug.q3 = quat.q3;
      g_imu_debug.quat_updated = quat.updated;
    }

    /* Read barometer data if available */
    if (IMU_Core_GetBaroData(&baro))
    {
      g_imu_debug.height = baro.height;
      g_imu_debug.temperature = baro.temperature;
      g_imu_debug.pressure = baro.pressure;
      g_imu_debug.pressure_contrast = baro.pressure_contrast;
      g_imu_debug.baro_updated = baro.updated;
    }

    /* 读取版本号，并保留是否真正收到版本返回帧的标志。 */
    g_imu_debug.version_known = IMU_Core_GetVersion(&ver);
    if (g_imu_debug.version_known)
    {
      g_imu_debug.version_high = ver.version_high;
      g_imu_debug.version_mid = ver.version_mid;
      g_imu_debug.version_low = ver.version_low;
    }

    /* Process RX data (runs the frame parser state machine) */
    IMU_Core_RunRxTask();

    /* Yield CPU so other tasks (e.g. servo task) can run reliably. */
    osDelay(1);
  }
  /* USER CODE END Start_IMU_Task */
}

/* USER CODE BEGIN Header_StartServoTask */
/**
* @brief Function implementing the servoTask thread.
* @param argument: here to control the motors, pitch for UMotor_SetTargetSpeedById,roll for Stepper_SetContinuousSignedRpm
* @retval None
* @note pitch 新机构安装方向修正：所有来源先按逻辑 RPM 仲裁，负数向机头、正数向机尾。
*       只在本任务最终调用 UMotor_SetTargetSpeedById 前乘一次 WORM_INSTALL_SIGN=-1。
*       键盘/手柄、SBUS、PID 和回零共用此处；不要在各入口或 PID 参数里重复补偿安装翻转。
*       驱动器实际正 RPM 向机头 PB4，负 RPM 向机尾 PD7，底层按此实际方向做限位。
*       回零逻辑 -350/+35 对应驱动器实际 +350/-35；原始位置反馈不取反。
*       g_rc_worm_cmd_rpm 和 UGWRM.cmd_rpm 记录转换后的驱动请求，便于对照原始反馈；
*       UGCTL.worm_rpm 仍是 PID 逻辑输出，二者符号不同不代表控制错误。
*       calib 同时校准 pitch/roll；worm_axis 只产出动作，本任务独占驱动写入。
*       roll 定步回中和退出限位只启动一次；终态等待新中立命令后才恢复手动。
*/
/* USER CODE END Header_StartServoTask */
void StartServoTask(void *argument)
{
  /* USER CODE BEGIN StartServoTask */
  uint16_t channels[SBUS_CHANNEL_COUNT] = {0U};
  uint32_t frame_lost = 0U;
  uint32_t failsafe = 0U;
  uint32_t mode = RC_CTRL_MODE_OFF;
  uint32_t off_reason = RC_OFF_REASON_NONE;
  uint32_t now_tick;
  uint32_t channel_count;
  uint8_t motor_enabled = 0U;
  uint8_t sbus_valid;
  uint8_t pitchmotor_enable_cmd;
  uint8_t rollmotor_enable_cmd;
  uint8_t pump_enable_cmd;
  uint8_t pump_direction_cmd;
  uint16_t sw_left_outer = 0U;
  uint16_t sw_left_mid_1 = 0U;
  uint16_t sw_left_mid_2 = 0U;
  uint16_t sw_right_outer = 0U;
  int32_t worm_cmd_rpm = 0;   /* 仲裁后的逻辑转速：负向机头、正向机尾 */
  int32_t worm_motor_rpm = 0; /* 安装转换后的驱动器实际方向请求 */
  WormCalibrationOutput calibration_output = {0};
  uint8_t calibration_override = 0U;
  uint8_t calibration_terminal_seen = 0U;
  uint32_t hold_eth_sequence = 0U;
  uint32_t hold_sbus_tick = 0U;
  uint32_t eth_sequence = 0U;
  uint32_t sbus_tick = 0U;
  StepperState stepper_state;
  int32_t stepper_cmd_rpm = 0;
  uint8_t thrust1_speed_cmd = 0U;
  uint8_t thrust2_speed_cmd = 0U;
  uint8_t thrust1_direction_cmd = 0U;
  uint8_t thrust2_direction_cmd = 0U;
  uint8_t thrust_first_nonzero_done = 0U;
  uint8_t thrust_last_direction1 = 0U;
  uint8_t thrust_last_direction2 = 0U;
  uint16_t thrust1_pulse_us;
  uint16_t thrust2_pulse_us;
  float signed_thrust;
  float thrust_magnitude;
  IoControlPumpSource pump_source;
  EthernetUartReadoutPack ethernet_pack = {0};
  uint8_t ethernet_control_flag = 0U;
  StateEstimate state_estimate;
  DisplacementSensorData displacement_snapshot;
  ZigzagControlOutput pid_output;
  PidControlStatus pid_status;
  int16_t rudder_angle_cdeg = 0;
  int16_t rudder_debug_angle_cdeg = 0;
  uint8_t rudder_active = 0U;
  RudderState rudder_state;

  (void)argument;

  Stepper_Init();
  Stepper_SetContinuousSignedRpm(0);
  UMotor_SetTargetSpeedById(RC_WORM_MOTOR_NODE_ID, 0);
  UMotor_SetMotorEnable(RC_WORM_MOTOR_SLOT, 0U);

  for(;;)
  {
    now_tick = HAL_GetTick();
    /* roll 停机后没有 TIM1 更新中断，仍需每拍维护限位释放。 */
    Stepper_ServiceLimits(now_tick);
    /* 双轴位置与校准状态推进；硬件写入仍在下面的唯一应用点。 */
    WormAxis_Step(now_tick);
    taskENTER_CRITICAL();
    (void)EthernetUartDriver_CopyControlPack(
        &ethernet_pack, &ethernet_control_flag);
    eth_sequence = g_ethernet_uart_diag.control_packet_count;
    taskEXIT_CRITICAL();
    (void)EkfBridge_CopyState(&state_estimate);//ServoTask每轮调用PID
    /* 位移数据由 USART3Task 更新，这里整体取一次快照供本轮控制使用。 */
    taskENTER_CRITICAL();
    displacement_snapshot.displacement_mm =
        g_displacement_sensor.displacement_mm;
    displacement_snapshot.sensor_id = g_displacement_sensor.sensor_id;
    displacement_snapshot.valid = g_displacement_sensor.valid;
    taskEXIT_CRITICAL();
    PidControlService_Step(
        &state_estimate,
        (uint8_t)(displacement_snapshot.valid != 0U),
        displacement_snapshot.displacement_mm,
        now_tick,
        ((float)RC_CONTROL_PERIOD_MS) * 0.001f,
        &pid_output);//调用PID服务
    (void)PidControlService_CopyStatus(&pid_status);

    channel_count = SbusDriver_GetChannels(
        channels, SBUS_CHANNEL_COUNT, &frame_lost, &failsafe, &sbus_tick);
    sbus_valid =
        (channel_count >= SBUS_CHANNEL_COUNT &&
         SbusDriver_IsFrameFresh(now_tick, RC_FRAME_TIMEOUT_MS) != 0U &&
         failsafe == 0U && frame_lost == 0U)
            ? 1U
            : 0U;

    calibration_override = WormAxis_GetCalibrationOutput(&calibration_output);
    if (calibration_override != 0U && calibration_output.calib_state != WORM_CALIB_RUNNING)
    {
      if (calibration_terminal_seen == 0U)
      {
        calibration_terminal_seen = 1U;
        hold_eth_sequence = eth_sequence;
        hold_sbus_tick = sbus_tick;
      }
      else if ((ethernet_control_flag != 0U && eth_sequence != hold_eth_sequence &&
                RcControl_IsEthernetNeutral(&ethernet_pack) != 0U) ||
               (ethernet_control_flag == 0U && sbus_valid != 0U && sbus_tick != hold_sbus_tick &&
                RcControl_IsSwitchUp(channels[SBUS_CH_SWITCH_LEFT_OUTER]) != 0U &&
                RcControl_IsSwitchUp(channels[SBUS_CH_SWITCH_LEFT_MID_1]) != 0U &&
                RcControl_IsSwitchUp(channels[SBUS_CH_SWITCH_LEFT_MID_2]) != 0U &&
                RcControl_IsSwitchUp(channels[SBUS_CH_SWITCH_RIGHT_OUTER]) != 0U))
      {
        WormAxis_ReleaseCalibrationHold();
        calibration_override = WormAxis_GetCalibrationOutput(&calibration_output);
        calibration_terminal_seen = 0U;
      }
    }
    else
    {
      calibration_terminal_seen = 0U;
    }

    mode = RC_CTRL_MODE_OFF;
    off_reason = RC_OFF_REASON_NONE;
    pitchmotor_enable_cmd = 0U;
    rollmotor_enable_cmd = 0U;
    pump_enable_cmd = 0U;
    pump_direction_cmd = 0U;
    pump_source = IO_PUMP_SOURCE_OFF;
    /* 常规尾舵仅接网线命令；Ozone 测试在最终应用点按 OFF 条件仲裁。 */
    rudder_angle_cdeg = 0;
    rudder_active = 0U;
    worm_cmd_rpm = 0;
    stepper_cmd_rpm = 0;
    thrust1_speed_cmd = 0U;
    thrust2_speed_cmd = 0U;
    thrust1_direction_cmd = 0U;
    thrust2_direction_cmd = 0U;

    // 新鲜 PID ARM 会话优先,其内部故障时保持 PID 源但输出全零，禁止回落旧命令
    if (pid_status.arm_requested != 0U &&
        pid_status.requested_mode != ZIGZAG_MODE_OFF &&
        pid_status.command_age_ms <= PID_CONTROL_COMMAND_TIMEOUT_MS)
    {
      mode = RC_CTRL_MODE_PID_ETH;
      pump_source = IO_PUMP_SOURCE_PID_ETH;
      if (pid_output.output_valid != 0U)
      {
        pitchmotor_enable_cmd = 1U;
        worm_cmd_rpm = RcControl_ClampSigned(
            pid_output.worm_motor_rpm, RC_WORM_MOTOR_MAX_RPM);
        pump_enable_cmd = pid_output.pump_enable;
        pump_direction_cmd = pid_output.pump_direction;

        signed_thrust = pid_output.signed_thrust_percent;
        thrust_magnitude =
            (signed_thrust >= 0.0f) ? signed_thrust : -signed_thrust;
        if (thrust_magnitude > 100.0f)
        {
          thrust_magnitude = 100.0f;
        }
        thrust1_speed_cmd = (uint8_t)(thrust_magnitude + 0.5f);
        thrust2_speed_cmd = thrust1_speed_cmd;

        /* 沿用 station AUTO：正值=I 键方向，负值=K 键方向。 */
        if (signed_thrust > 0.0f)
        {
          thrust1_direction_cmd = 0U;
          thrust2_direction_cmd = 1U;
        }
        else if (signed_thrust < 0.0f)
        {
          thrust1_direction_cmd = 1U;
          thrust2_direction_cmd = 0U;
        }
      }
      else
      {
        off_reason =
            RC_OFF_REASON_PID_FAULT_BASE + (uint32_t)pid_status.fault;
      }
      /* PID 接管时同步终止两轴校准，不能遗留 roll 的回中动作。 */
      WormAxis_CancelCalibrationForPid();
      calibration_override = 0U;
    }
    /*
     * 双轴校准：优先级仅次于 PID，高于直接以太网控制和 SBUS。
     * 放在这里的理由：用户在 AUTO 模式下输 calib 时，ethernet_control_flag 是 1，
     * 若排在它后面就永远轮不到。而 PID armed 时上面那条分支已经把回零取消掉了。
     * 两轴分别完成并等待；泵/推进保持本轮开头清好的零值。
     */
    else if (calibration_override != 0U)
    {
      mode = RC_CTRL_MODE_WORM_HOMING;
      pitchmotor_enable_cmd = 1U;
      worm_cmd_rpm = RcControl_ClampSigned(
          calibration_output.pitch_rpm, RC_WORM_MOTOR_MAX_RPM);
    }
    else if (ethernet_control_flag != 0U)
    {
      mode = RC_CTRL_MODE_ETH;
      pump_source = IO_PUMP_SOURCE_DIRECT_ETH;
      pitchmotor_enable_cmd = ethernet_pack.pitchmotor_enable;
      rollmotor_enable_cmd = ethernet_pack.rollmotor_enable;
      pump_enable_cmd = ethernet_pack.pump_on_off;
      pump_direction_cmd = ethernet_pack.pump_direction;
      worm_cmd_rpm = RcControl_ClampSigned(
          ethernet_pack.pitchmotor_speed_rpm, RC_WORM_MOTOR_MAX_RPM);
      stepper_cmd_rpm = RcControl_ClampSigned(
          ethernet_pack.rollmotor_speed_rpm, RC_STEPPER_MAX_RPM);
      thrust1_speed_cmd = ethernet_pack.thrustmotor1se_speed_rpm;
      thrust2_speed_cmd = ethernet_pack.thrustmotor2se_speed_rpm;
      thrust1_direction_cmd = ethernet_pack.thrustmotor_direction;
      thrust2_direction_cmd = ethernet_pack.thrustmotor_direction2;
      rudder_angle_cdeg = ethernet_pack.rudder_angle_cdeg;
      rudder_active = ethernet_pack.rudder_valid;
    }
    else if (sbus_valid != 0U)
    {
      sw_left_outer = channels[SBUS_CH_SWITCH_LEFT_OUTER];
      sw_left_mid_1 = channels[SBUS_CH_SWITCH_LEFT_MID_1];
      sw_left_mid_2 = channels[SBUS_CH_SWITCH_LEFT_MID_2];
      sw_right_outer = channels[SBUS_CH_SWITCH_RIGHT_OUTER];

      g_rc_sw_left_outer = sw_left_outer;
      g_rc_sw_left_mid_1 = sw_left_mid_1;
      g_rc_sw_left_mid_2 = sw_left_mid_2;
      g_rc_sw_right_outer = sw_right_outer;

      /* 泵沿用原 SBUS 语义，但只发布邮箱命令，不在本任务写 GPIO。 */
      pump_source = IO_PUMP_SOURCE_SBUS;
      pump_enable_cmd =
          (sw_right_outer > RC_SWITCH_DOWN_THRESHOLD) ? 1U : 0U;
      pump_direction_cmd =
          (sw_left_mid_2 > 800U && sw_left_mid_2 < 1200U) ? 1U : 0U;

      if ((RcControl_IsSwitchUp(sw_left_outer) != 0U) &&
          (RcControl_IsSwitchUp(sw_left_mid_1) != 0U) &&
          (RcControl_IsSwitchUp(sw_left_mid_2) != 0U) &&
          (RcControl_IsSwitchUp(sw_right_outer) != 0U))
      {
        off_reason = RC_OFF_REASON_ALL_SWITCH_UP;
      }
      else if (RcControl_IsSwitchMid(sw_left_mid_1) != 0U)
      {
        mode = RC_CTRL_MODE_OPEN_LOOP_SPEED;
        pitchmotor_enable_cmd = 1U;
        rollmotor_enable_cmd = 1U;
        g_rc_left_stick_y = channels[SBUS_CH_LEFT_STICK_Y];
        g_rc_left_stick_x = channels[SBUS_CH_LEFT_STICK_X];
        g_rc_right_stick_y = channels[SBUS_CH_RIGHT_STICK_Y];
        worm_cmd_rpm = RcControl_MapStickToSignedRpm(
            g_rc_left_stick_y, RC_WORM_MOTOR_MAX_RPM);
        stepper_cmd_rpm = RcControl_MapStickToSignedRpm(
            g_rc_left_stick_x, RC_STEPPER_MAX_RPM);
      }
      else
      {
        off_reason = RC_OFF_REASON_MODE_SWITCH_NOT_MID;
      }
    }
    else if (channel_count < SBUS_CHANNEL_COUNT ||
             SbusDriver_IsFrameFresh(
                 now_tick, RC_FRAME_TIMEOUT_MS) == 0U)
    {
      off_reason = RC_OFF_REASON_FRAME_TIMEOUT;
    }
    else
    {
      off_reason = RC_OFF_REASON_FAILSAFE_OR_LOST;
    }

    /* 唯一硬件应用点：先完成源仲裁，再一次性写各执行器。 */
    if (calibration_override != 0U)
    {
      if (RcControl_ApplyCalibrationRoll(&calibration_output) == 0U)
      {
        /* roll 启动失败回执在本拍停止 pitch，不能等下一个 20ms。 */
        pitchmotor_enable_cmd = 0U;
        worm_cmd_rpm = 0;
      }
      (void)Stepper_CopyState(&stepper_state);
      stepper_cmd_rpm = stepper_state.pulse_rpm;
    }
    /* Ozone 仅在常规控制 OFF 且泵未启用时接管尾舵；其他来源会撤销调试使能，
       不影响其他轴，也不在冲突消失后自动恢复旧调试目标。 */
    if (RudderDriver_GetDebugCommand((uint8_t)(mode == RC_CTRL_MODE_OFF &&
                                              pump_enable_cmd == 0U),
                                     &rudder_debug_angle_cdeg))
    {
      RudderDriver_ApplyDebug(rudder_debug_angle_cdeg);
    }
    else
    {
      RudderDriver_Apply(rudder_angle_cdeg, rudder_active);
    }
    (void)RudderDriver_CopyState(&rudder_state);
    /* 保留旧 Ozone 观察名称，内容改为真正已下发的尾舵命令。 */
    g_dbg_servo_start_ok = rudder_state.pwm_started;
    g_dbg_servo_step_count = rudder_state.update_count;
    g_dbg_servo_pulse_us = rudder_state.applied_pulse_us;
    /* pitch 唯一安装方向转换点；各来源已限幅到 +/-600，取反不会溢出。
     * 未使能时每拍明确归零，防止诊断值残留上一拍的驱动请求。 */
    worm_motor_rpm = (pitchmotor_enable_cmd != 0U)
                         ? WORM_INSTALL_SIGN * worm_cmd_rpm : 0;
    if (pitchmotor_enable_cmd != 0U)
    {
      if (motor_enabled == 0U)
      {
        UMotor_SetMotorEnable(RC_WORM_MOTOR_SLOT, 1U);
        motor_enabled = 1U;
      }
      UMotor_SetTargetSpeedById(RC_WORM_MOTOR_NODE_ID, worm_motor_rpm);
    }
    else
    {
      worm_cmd_rpm = 0;
      UMotor_SetTargetSpeedById(RC_WORM_MOTOR_NODE_ID, 0);
      if (motor_enabled != 0U)
      {
        UMotor_SetMotorEnable(RC_WORM_MOTOR_SLOT, 0U);
        motor_enabled = 0U;
      }
    }

    if (calibration_override != 0U)
    {
      /* 已按动作类型应用；KEEP 期间不得用连续速度覆盖定步运动。 */
    }
    else if (rollmotor_enable_cmd != 0U)
    {
      Stepper_DisarmReleaseStop();
      Stepper_SetContinuousSignedRpm(stepper_cmd_rpm);
    }
    else
    {
      stepper_cmd_rpm = 0;
      Stepper_DisarmReleaseStop();
      Stepper_SetContinuousSignedRpm(0);
    }

    if (thrust1_speed_cmd == 0U && thrust2_speed_cmd == 0U)
    {
      (void)ThrusterDriver_SetDualPulseUs(
          THRUSTER_PULSE_NEUTRAL_US, THRUSTER_PULSE_NEUTRAL_US);
      thrust_first_nonzero_done = 0U;
    }
    else if (thrust_first_nonzero_done == 0U ||
             thrust1_direction_cmd != thrust_last_direction1 ||
             thrust2_direction_cmd != thrust_last_direction2)
    {
      /* 从静止启动或换向时先给一拍中立。 */
      (void)ThrusterDriver_SetDualPulseUs(
          THRUSTER_PULSE_NEUTRAL_US, THRUSTER_PULSE_NEUTRAL_US);
      thrust_first_nonzero_done = 1U;
      thrust_last_direction1 = thrust1_direction_cmd;
      thrust_last_direction2 = thrust2_direction_cmd;
    }
    else
    {
      thrust1_pulse_us = ThrusterDriver_MapDirectionSpeedToPulseUs(
          thrust1_direction_cmd, thrust1_speed_cmd);
      thrust2_pulse_us = ThrusterDriver_MapDirectionSpeedToPulseUs(
          thrust2_direction_cmd, thrust2_speed_cmd);
      (void)ThrusterDriver_SetDualPulseUs(
          thrust1_pulse_us, thrust2_pulse_us);
    }

    (void)IoControlPump_SubmitCommand(
        pump_source,
        pump_enable_cmd,
        pump_direction_cmd,
        now_tick);

    g_rc_ctrl_mode = mode;
    g_rc_ctrl_off_reason = off_reason;
    g_rc_worm_cmd_rpm = worm_motor_rpm;
    g_rc_stepper_cmd_rpm = stepper_cmd_rpm;

    osDelay(RC_CONTROL_PERIOD_MS);//循环定义位置
  }
  /* USER CODE END StartServoTask */
}

/* USER CODE BEGIN Header_StartUsart3Task */
/**
* @brief Function implementing the Usart3Task thread.
* @param argument: Not used
* @retval None
*/
/* USER CODE END Header_StartUsart3Task */
void StartUsart3Task(void *argument)
{
  /* USER CODE BEGIN StartUsart3Task */
  (void)argument;

  for (;;)
  {
    /* 位移数据、ServoTask 邮箱时间戳和泵超时统一使用 HAL_GetTick。 */
    uint32_t now = HAL_GetTick();
    /*
     * 限位电平在这里 10ms 刷新一次，motor_driver 直接读当前电平判方向
     * （Motor_IsLimitBlocked），不再需要单独的限位事件观察函数。
     */
    LimitSwitch_ReadStates(g_limit_switch_states);
    DisplacementSensor_Poll(now);
    IoControlPump_Poll();
    osDelay(10);
  }
  /* USER CODE END StartUsart3Task */
}

/* USER CODE BEGIN Header_StartUsart2Task */
/**
* @brief Function implementing the Usart2Task thread.
* @param argument: Not used
* @retval None
*/
/* USER CODE END Header_StartUsart2Task */
void StartUsart2Task(void *argument)
{
  /* USER CODE BEGIN StartUsart2Task */
  UMotor_StartTask(argument);
  /* USER CODE END StartUsart2Task */
}

 /* MPU Configuration */

void MPU_Config(void)
{
  MPU_Region_InitTypeDef MPU_InitStruct = {0};

  /* Disables the MPU */
  HAL_MPU_Disable();

  /** Initializes and configures the Region and the memory to be protected
  */
  MPU_InitStruct.Enable = MPU_REGION_ENABLE;
  MPU_InitStruct.Number = MPU_REGION_NUMBER0;
  MPU_InitStruct.BaseAddress = 0x0;
  MPU_InitStruct.Size = MPU_REGION_SIZE_4GB;
  MPU_InitStruct.SubRegionDisable = 0x87;
  MPU_InitStruct.TypeExtField = MPU_TEX_LEVEL0;
  MPU_InitStruct.AccessPermission = MPU_REGION_NO_ACCESS;
  MPU_InitStruct.DisableExec = MPU_INSTRUCTION_ACCESS_DISABLE;
  MPU_InitStruct.IsShareable = MPU_ACCESS_SHAREABLE;
  MPU_InitStruct.IsCacheable = MPU_ACCESS_NOT_CACHEABLE;
  MPU_InitStruct.IsBufferable = MPU_ACCESS_NOT_BUFFERABLE;

  HAL_MPU_ConfigRegion(&MPU_InitStruct);
  /* Enables the MPU */
  HAL_MPU_Enable(MPU_PRIVILEGED_DEFAULT);

}

/**
  * @brief  This function is executed in case of error occurrence.
  * @retval None
  */
void Error_Handler(void)
{
  /* USER CODE BEGIN Error_Handler_Debug */
  /* User can add his own implementation to report the HAL error return state */
  g_dbg_rtos_hook_code = 4U;
  __disable_irq();
  while (1)
  {
    g_dbg_fault_count++;
  }
  /* USER CODE END Error_Handler_Debug */
}

#ifdef  USE_FULL_ASSERT
/**
  * @brief  Reports the name of the source file and the source line number
  *         where the assert_param error has occurred.
  * @param  file: pointer to the source file name
  * @param  line: assert_param error line source number
  * @retval None
  */
void assert_failed(uint8_t *file, uint32_t line)
{
  /* USER CODE BEGIN 6 */
  /* User can add his own implementation to report the file name and line number,
     ex: printf("Wrong parameters value: file %s on line %d\r\n", file, line) */
  /* USER CODE END 6 */
}
#endif /* USE_FULL_ASSERT */
