Frrrrrrrrrank/Underwater-Glider/software/software.ioc

Mcu.UserName=STM32H743VITx
PA0.Signal=S_TIM2_CH1_ETR
PA1.Signal=USART2_DE
PA10.Signal=USART1_RX
PA12.Signal=USART1_DE
PA2.Signal=USART2_TX
PA3.Signal=USART2_RX
PA4.Signal=SPI1_NSS
PA5.Signal=SPI1_SCK
PA6.Signal=SPI1_MISO
PA7.Signal=SPI1_MOSI
PA9.Signal=USART1_TX
PB0.GPIO_Label=LED
PB0.Signal=GPIO_Output
PB1.Signal=ADCx_INP5
PB10.Signal=I2C2_SCL
PB11.Signal=I2C2_SDA
PB12.Signal=UART5_RX
PB13.Signal=UART5_TX
PB14.Signal=UART4_RTS
PB15.Signal=UART4_CTS
PB5.Signal=GPIO_Input
PB6.Signal=LPUART1_TX
PB7.Signal=LPUART1_RX
PB8.Signal=UART4_RX
PB9.Signal=UART4_TX
PC1.Signal=SPI2_MOSI
PC10.Signal=SDMMC1_D2
PC11.Signal=SDMMC1_D3
PC12.Signal=SDMMC1_CK
PC13.GPIO_Label=PUMP_SPEED_B0
PC13.Signal=GPIO_Output
PC2_C.Signal=SPI2_MISO
PC4.GPIO_Label=IMU_DRY
PC4.Signal=GPIO_Input
PC5.Signal=ADCx_INP8
PC7.Signal=GPIO_Input
PC8.Signal=SDMMC1_D0
PC9.Signal=SDMMC1_D1
PD0.Signal=FDCAN1_RX
PD1.Signal=FDCAN1_TX
PD12.Signal=USART3_DE
PD14.Signal=S_TIM4_CH3
PD15.Signal=S_TIM4_CH4
PD2.Signal=SDMMC1_CMD
PD3.Signal=SPI2_SCK
PD7.Signal=GPIO_Input
PD8.Signal=USART3_TX
PD9.Signal=USART3_RX
PE0.Signal=UART8_RX
PE1.Signal=UART8_TX
PE10.Signal=GPIO_Output
PE11.Signal=S_TIM1_CH2
PE12.Signal=GPIO_Output
PE13.Signal=GPIO_Output
PE14.Signal=S_TIM1_CH4
PE4.GPIO_Label=PUMP_DIR
PE4.Signal=GPIO_Output
PE5.Signal=S_TIM15_CH1
PE6.Signal=S_TIM15_CH2
PE7.Signal=UART7_RX
PE8.Signal=UART7_TX
