Frrrrrrrrrank/Underwater-Glider/software/Glider-Core/glider_core.c

#include "glider_core.h"

#include "cmsis_os.h"
#include "displacement_sensor.h"
#include "ethernet_uart_driver.h"
#include "glider_rdss_codec.h"
#include "imu_core.h"
#include "pressure_sensor_driver.h"
#include "sbus_driver.h"

#include <stdio.h>
#include <string.h>

#define GLIDER_RX_RING_SIZE 512U
#define GLIDER_RX_LINE_SIZE 512U
#define GLIDER_RD_MODE_CMD "AT+TESTRD\r\n"
#define GLIDER_POSITION_TEST_CMD "AT+TESTRN\r\n"
#define GLIDER_TRANSPARENT_MODE_CMD "AT+TESTTC\r\n"
#define GLIDER_QUERY_LOCAL_CARD_CMD "$CCICA,0,00*7B\r\n"
#define GLIDER_QUERY_SIGNAL_CMD "$CCRMO,BSI,2,0*26\r\n"
#define GLIDER_QUERY_TARGET_CARD_CMD "AT+SENDTO?\r\n"
#define GLIDER_SET_CARD_CMD_FMT "AT+SENDTO=%s=\r\n"
#define GLIDER_TX_MODE_SIGNAL_POLL 0U
#define GLIDER_TX_MODE_POSITION_TEST 1U
#define GLIDER_TX_MODE_RECEIVE_ONLY 2U
/* Only edit this macro to change the target platform card ID. */
#define GLIDER_TARGET_CARD_ID "1462107"
#define GLIDER_PLATFORM_CARD_ID GLIDER_TARGET_CARD_ID
#define GLIDER_SIGNAL_STABLE_COUNT 2U
#define GLIDER_MODE_SWITCH_COOLDOWN_LINES 3U
#define GLIDER_CARD_QUERY_COOLDOWN_LOOPS 6U
#define GLIDER_RN_REFRESH_INTERVAL_MS 30000U
#define GLIDER_RELOCATE_INTERVAL_MS 180000U
#define GLIDER_SHORTMSG_SEND_INTERVAL_MS 2000U
#define GLIDER_TC_REQUEST_RETRY_MS 3000U
#define GLIDER_TC_ENTER_GRACE_MS 1200U
#define GLIDER_RD_MODE_RETRY_MS 10000U
#define GLIDER_SHORTMSG_ACK_TIMEOUT_MS 8000U

static UART_HandleTypeDef *s_uart = NULL;
static volatile uint8_t s_rx_ring[GLIDER_RX_RING_SIZE];
static volatile uint16_t s_rx_head = 0;
static volatile uint16_t s_rx_tail = 0;
static volatile uint8_t s_rx_byte = 0;

static volatile uint32_t s_rx_overflow_count = 0;
static volatile uint32_t s_rx_line_count = 0;
static volatile uint32_t s_tx_attempt_count = 0;
static volatile uint32_t s_tx_ok_count = 0;
static volatile uint32_t s_tx_fail_count = 0;
static volatile uint32_t s_tx_last_hal_status = 0;
static volatile uint32_t s_tx_last_uart_error = 0;
static volatile uint32_t s_shortmsg_sent_count = 0;
static volatile uint32_t s_shortmsg_attempt_count = 0;
static volatile uint32_t s_shortmsg_reject_count = 0;
static volatile uint32_t s_shortmsg_timeout_count = 0;
static volatile uint32_t s_shortmsg_uart_fail_count = 0;
static volatile uint32_t s_shortmsg_last_result = GLIDER_SHORTMSG_RESULT_IDLE;
static volatile uint32_t s_shortmsg_send_ok_count = 0U;
static volatile int32_t s_local_latitude_deg_e7 = 0;
static volatile int32_t s_local_longitude_deg_e7 = 0;
static volatile uint32_t s_bdpwi_signal_available = 0;
static char s_last_tx_text[32] = {0};
static char s_last_shortmsg_payload[96] = {0};

volatile GliderTargetCoordinate g_target_coordinate = {0};

typedef struct
{
  volatile uint32_t signal_good;
  volatile uint32_t tx_mode;
  char local_card_id[24];
  volatile uint32_t local_card_id_known;
  volatile uint32_t local_card_mismatch;
  volatile uint32_t transparent_mode_ready;
  volatile uint32_t tc_mode_requested;
  volatile uint32_t tc_mode_active;
  volatile uint32_t rn_mode_active;
  volatile uint32_t rd_mode_active;
  volatile uint32_t shortmsg_pending;
  volatile uint32_t shortmsg_waiting_ack;
  char current_target_card[24];
  volatile uint32_t current_target_card_known;
  volatile uint32_t current_target_card_match;
  volatile uint32_t target_card_query_attempted;
  char pending_shortmsg_payload[96];
  volatile uint32_t has_cached_fix;
  char cached_shortmsg_payload[96];
  volatile uint32_t signal_good_streak;
  volatile uint32_t signal_bad_streak;
  volatile uint32_t mode_switch_cooldown;
  volatile uint32_t card_query_cooldown;
} GliderLastState;

static GliderLastState s_last = {
    0U,
    GLIDER_TX_MODE_SIGNAL_POLL,
    {0},
    0U,
    0U,
    0U,
    0U,
    0U,
    0U,
    0U,
    0U,
    0U,
    {0},
    0U,
    0U,
    0U,
    {0},
    0U,
    {0},
    0U,
    0U,
    0U,
    0U};
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
