Frrrrrrrrrank/Underwater-Glider/(commit log)

2026-01-09 init proj
    [MainControl.kicad_sch, Power.kicad_sch, UnderwaterGlider.kicad_pcb, UnderwaterGlider.kicad_sch]
2026-01-10 update layout
    [MainControl.kicad_sch, Power.kicad_sch, UnderwaterGlider.kicad_pcb]
2026-01-19 update placement
    [Power.kicad_sch, UnderwaterGlider.kicad_pcb]
2026-01-24 update version,submit custom
    [UnderwaterGlider.kicad_pcb, bom.csv, designators.csv, positions.csv]
2026-03-24 read imu data ok
2026-03-25 update servo driver in main, wait to seperate in driver file
2026-04-01 ok to receive displacement sensor value
2026-04-16 fix resend BD shortmsg bug, can driver UMotor
2026-04-20 update pressure sensor
2026-04-20 update pressure sensor baud rate 115200
2026-04-21 update fs rc control, add test code in servoTask
2026-04-29 need to debug pump
2026-04-30 fix rc control bug, ok to control pitch and roll motor
2026-04-30 ok to use remote control to control pump motor
2026-05-07 ignore build outputs and KiCad temp files
2026-05-09 update schematic change
2026-05-11 update schematic design, ready to start layout
2026-05-12 update pcb from schematic
2026-06-02 add ignore rules for build and KiCad temp files
2026-06-02 ok to control pump and linear displacement sensor feedback
2026-06-09 update can control pump, umotor,stepper, read displacement sensor, RC control at the same time
2026-06-09 update hardware testing,12v tvs chosen wrong
2026-06-15 update pcb step model file
2026-06-15 add buzzer and led toggle pin
2026-06-17 update ver1.1 stepper and pitch motor
2026-06-17 IMU加速度计输出单位更改
2026-06-17 change io control pump not yet test
2026-06-17 remove kicad lock files from integration
2026-06-18 ok to test pump
2026-06-18 imu and linear displacement sensor ok
2026-06-19 增加单独的TCPhandle
2026-06-19 测试版本,未修改cubemx
2026-06-22 完成限位开关闭环及线位移传感器闭环
2026-06-24 完成pitch由网线的控制，泵写完逻辑未调试
2026-06-24 网线可发送接受，但是存在bug有时会卡死，可能是因为数据包过大？
2026-06-24 修改python的上位机，现在网线通讯应该没有bug了
2026-06-24 增加了python的译码，但还未测试
2026-06-25 EKF面向嵌入式封装，架构完整，目前遇到活锁问题
2026-06-25 增加了推进器的控制，可能还要改下
2026-06-26 减小了从STM32发送至python端的数据包大小
2026-06-29 压力计失锁问题改正v1
2026-06-29 两个推进器分别控制
2026-06-30 IMU频率设置100hz，坐标系从FLU变换为FRD
2026-06-30 网口输出EKF状态估计量
2026-06-30 压力计频率调10HZ需要上机测试
2026-06-30 网口结构体调试出EKF参数
2026-06-30 EKF消息心跳包
2026-07-08 log分析工具，ekf消息包与其它执行器解耦
2026-07-09 CZQ更新
2026-07-16 更新了auto的部分内容
2026-07-22 增加了初步的PID控制
2026-07-22 上位机通信报格式优化，规定为地面站，磁力计标定完成
2026-07-23 上位机地面站架构更新，发送消息格式统一
2026-08-03 PID初版完成，泵和电机驱动debug完成
2026-08-12 改了深度外环闭环，现在是期望线位移传感器位置
2026-08-18 压力计调平
2026-09-04 rdss_frank更新
2026-09-04 clibration自校正开发完成
2026-10-09 地面站初版，UI初版定了
2026-10-15 手柄映射，用于测试推进器
2026-10-16 roll限位设计完成，手柄映射测试完成
2026-10-16 pitch映射以及回零范围已修改
2026-10-16 rdss卡号更改，电池电压监测完善
2026-10-22 终端地面站显示与控制指令发送分离
2026-10-29 rdss消息可以记录为log，roll电机百分比行程做好了
2026-11-05 Preserve rudder controls and read-only gamepad preview before merge
2026-11-05 update pressure sensor with i2c
